JulianRe24/ME3-Entwurf/Unterlagen/Foto Getriebe.PNG

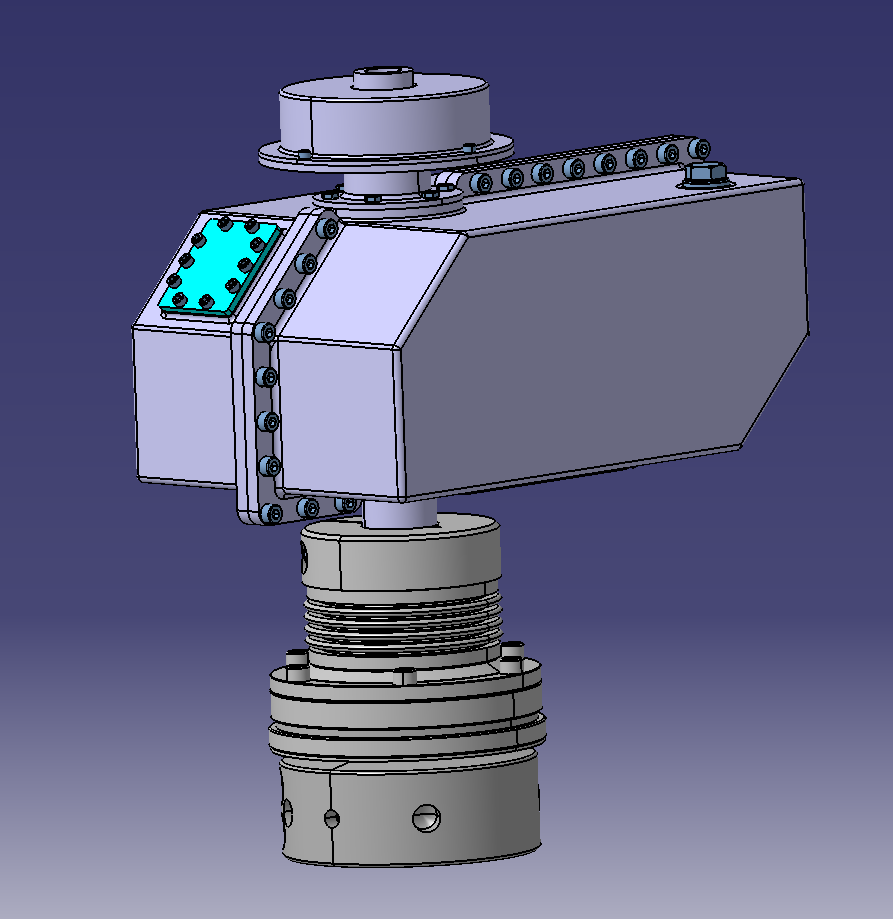
Unterlagen/Foto Getriebe.PNG
