JulianRe24/ME3-Entwurf/README.md

# ME3-Entwurf
Hier wird ein wundervoller Maschinenelemente 3 Entwurf erstellt.
