JulianRe24/ME3-Entwurf/Unterlagen/Bohrgerät-Getriebe_Berechnung final.pdf

Getriebeberechnung Bohrgerät | Lara Vujevic
Julian Reimann
Arne Schlemermeyer

Vereinbarte Konstanten:

Normaleingriffs-winkelwinkel:

Schrägungswinkel: Überschlägiger Belastungswert:

Anwendungsfaktor:

αn ≔20 | ° | β ≔20 ° | Bzul ≔4 | ―N―mm²
KA ≔2.0

Druckkraft
vom Boden:
Schaltdrehzahl: | Dauerfestigkeitsschubspannung:
FB ≔1500 N | ns ≔1400 rpm | τTzul ≔50 ―N―mm²
(42CrMo4)

Antriebsdrehzahl:
nAntrieb ≔2000 ―1―min

Übersetzungsverhältnis:

Antriebsmoment:
Tan ≔50 N ⋅m

Theoretisch benötigte Übersetzungen:
i1 ≔3.40 | i2 ≔2.95 | orientiert an TB 21-11
iGesamt ≔i | ⋅ 1

i2

iGesamt =10.03

Errechnete Übersetzungen (siehe Zahnraddaten):
i'1 ≔3.381 | i'2 ≔2.964
i'Gesamt ≔i' | ⋅ 1

i'2

i'Gesamt =10.021

Moment der Vorgelegewelle:
TVorgelege ≔T | ⋅ an | i'1 | TVorgelege =169.05 N ⋅m

Abtriebsmoment:

Tab ≔T | ⋅ an | i'Gesamt | Tab =501.064 N ⋅m

10.08.2022 Seite 1 von 27

Fliehkraftkupplung:

NFK ≔2 | FF ≔25 N | ns ≔1400 ―1―min
ωs ≔2 π⋅ns =146.608 | ―1
s
rFK ≔50 mm | μ0 ≔0.9
mFK ≔0.5 | kg | Δl ≔2.5 mm

dR ≔120 mm

Federsteifigkeit: | C ≔――

FF
Δl

C =10 ―N―mm

Bei Schaltdrehzahl:

Fliehkraft: | FFlieh ≔mFK ⋅ rFK ⋅ωs
2 | FFlieh =0.537 | kN
Kontaktkraft: | FN ≔⎛⎝FFlieh -2 ⋅FF

⎞
⎠ | FN =0.487 | kN
Reibkraft eines Fliehkörpers: | FR ≔μ | ⋅ 0 | FN | FR =438.611 N
Reib-/Schaltmoment: | TR ≔NFK ⋅FR ⋅―

dR
2

TR =52.633 N·m

10.08.2022 Seite 2 von 27

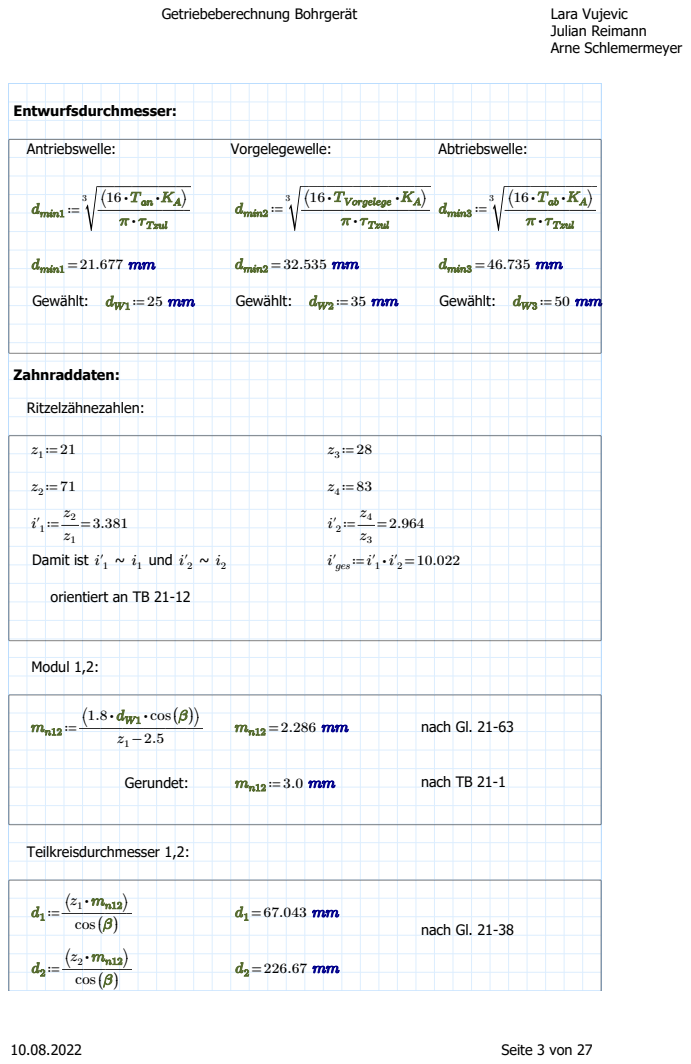
[picture p2: page 3]
Entwurfsdurchmesser:; Antriebswelle:; Vorgelegewelle:; Abtriebswelle:; dmin2 ≔; ⎛⎝16 ⋅TVorgelege ⋅KA; π⋅τTzul; dmin3 ≔; dmin1 ≔; dmin1 =21.677 mm; dmin2 =32.535 mm; dmin3 =46.735 mm; Gewählt:; Zahnraddaten:; Ritzelzähnezahlen:; Damit ist i' ~; und; i'ges≔i'1; Modul 1,2:; ⎛⎝1.8 ⋅dW1 ⋅ cos ((β))⎞ ⎠; nach Gl. 21-63; Gerundet:; nach TB 21-1; Teilkreisdurchmesser 1,2:; cos ((β)); nach Gl. 21-38; 10.08.2022 Seite 3 von 27

orientiert an TB 21-12

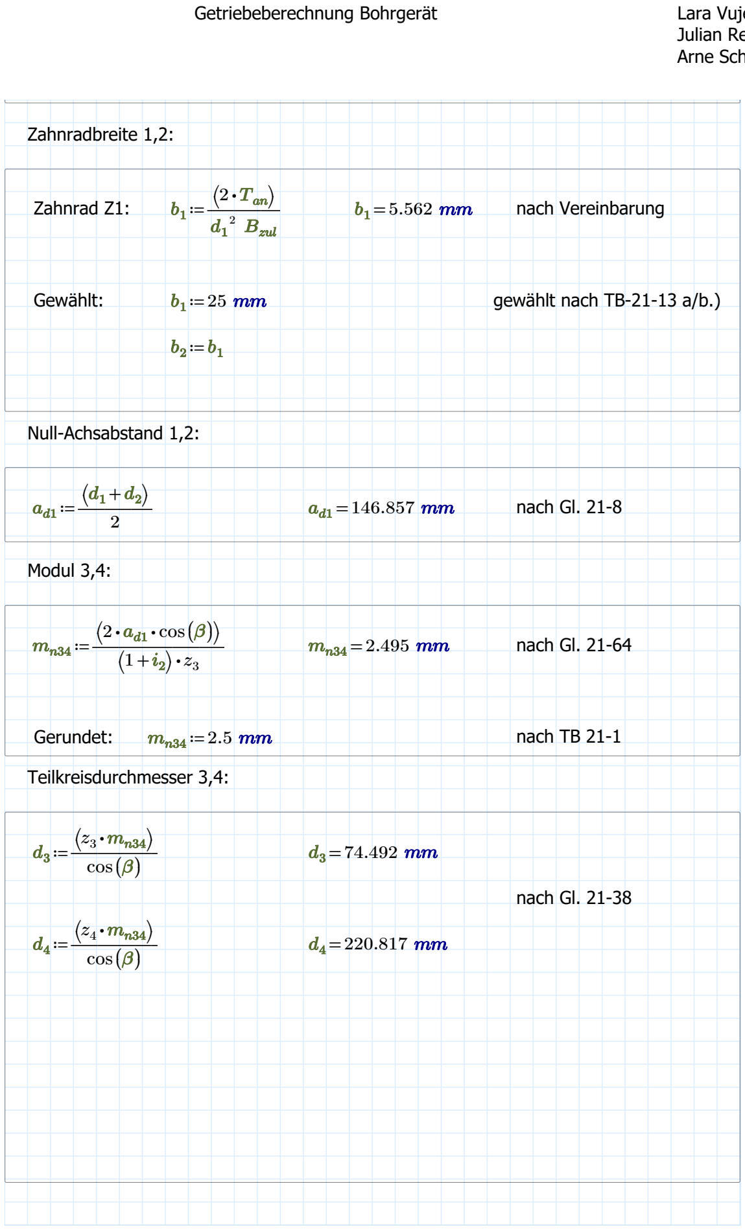
[picture p3: figure]
Zahnradbreite 1,2:; Zahnrad Z1:; ⎛⎝2 ⋅Tan; 2 Bzul; nach Vereinbarung; Gewählt:; gewählt nach TB-21-13 a/b.); Null-Achsabstand 1,2:; nach Gl. 21-8; Modul 3,4:; ⋅ d1 cos ((β))⎞; nach Gl. 21-64; Gerundet:; nach TB 21-1; Teilkreisdurchmesser 3,4:; cos ((β)); nach Gl. 21-38

10.08.2022 Seite 4 von 27

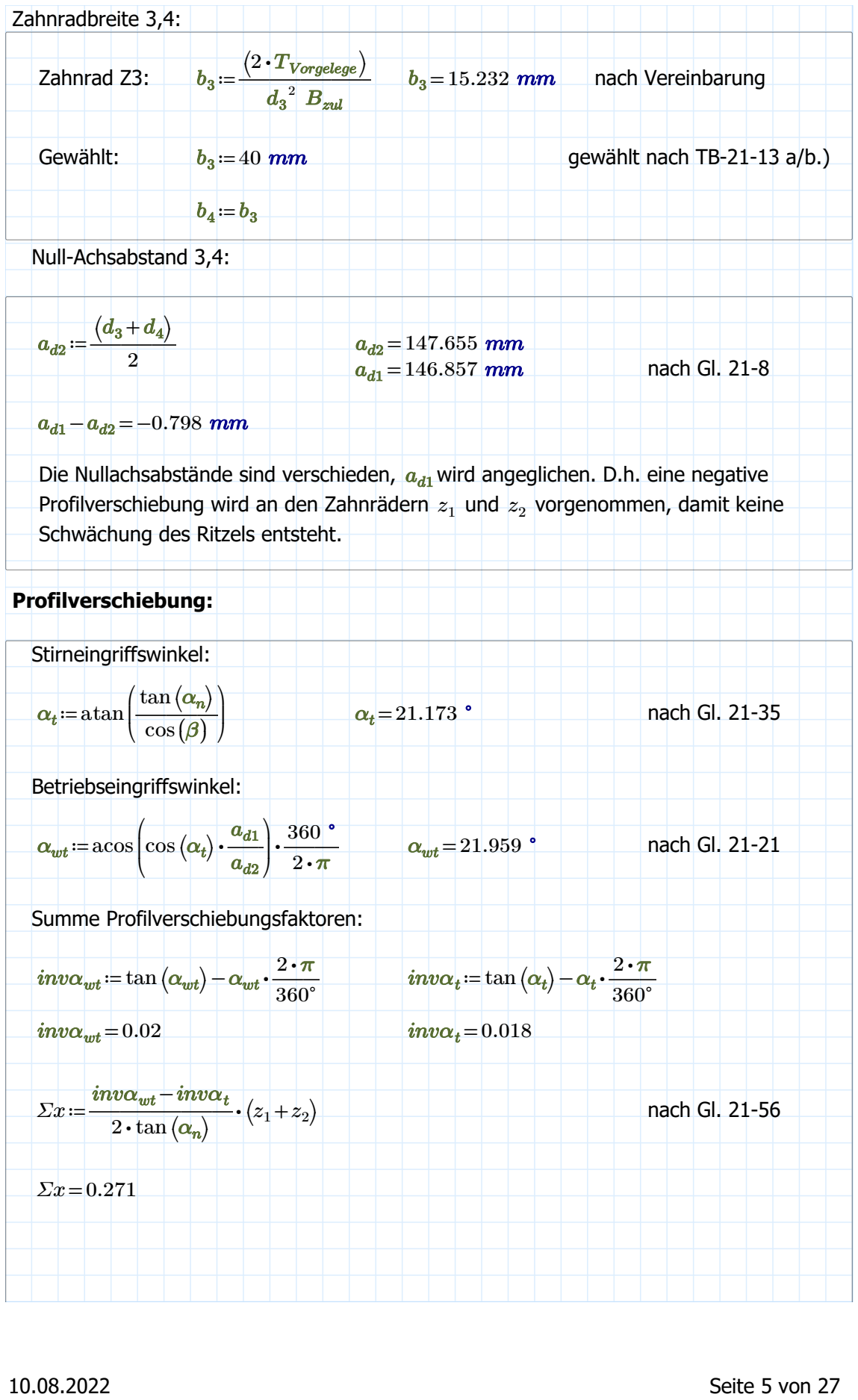
[picture p4: figure]
Zahnradbreite 3,4:; Zahnrad Z3:; ⎛⎝2 ⋅TVorgelege ⎞ ⎠; 2 Bzul; nach Vereinbarung; Gewählt:; gewählt nach TB-21-13 a/b.); Null-Achsabstand 3,4:; nach Gl. 21-8; Profilverschiebung wird an den Zahnrädern; und; vorgenommen, damit keine 1; Schwächung des Ritzels entsteht.; Profilverschiebung:; Stirneingriffswinkel:; αt ≔atan; tan⎛⎝αn; ⎞ ⎠ cos ((β)); nach Gl. 21-35; Betriebseingriffswinkel:; αwt ≔acos; cos ⎛; αwt =21.959 °; nach Gl. 21-21; Summe Profilverschiebungsfaktoren:; invαwt ≔tan⎛⎝αwt⎞; ⎠-αwt ⋅―2 ⋅π―360°; invαt ≔tan⎛⎝αt; invαwt =0.02; invαt =0.018; invαwt -invαt 2 ⋅ tan⎛⎝αn; nach Gl. 21-56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

Die Nullachsabstände sind verschieden, | a | wird angeglichen. D.h. eine negative d1

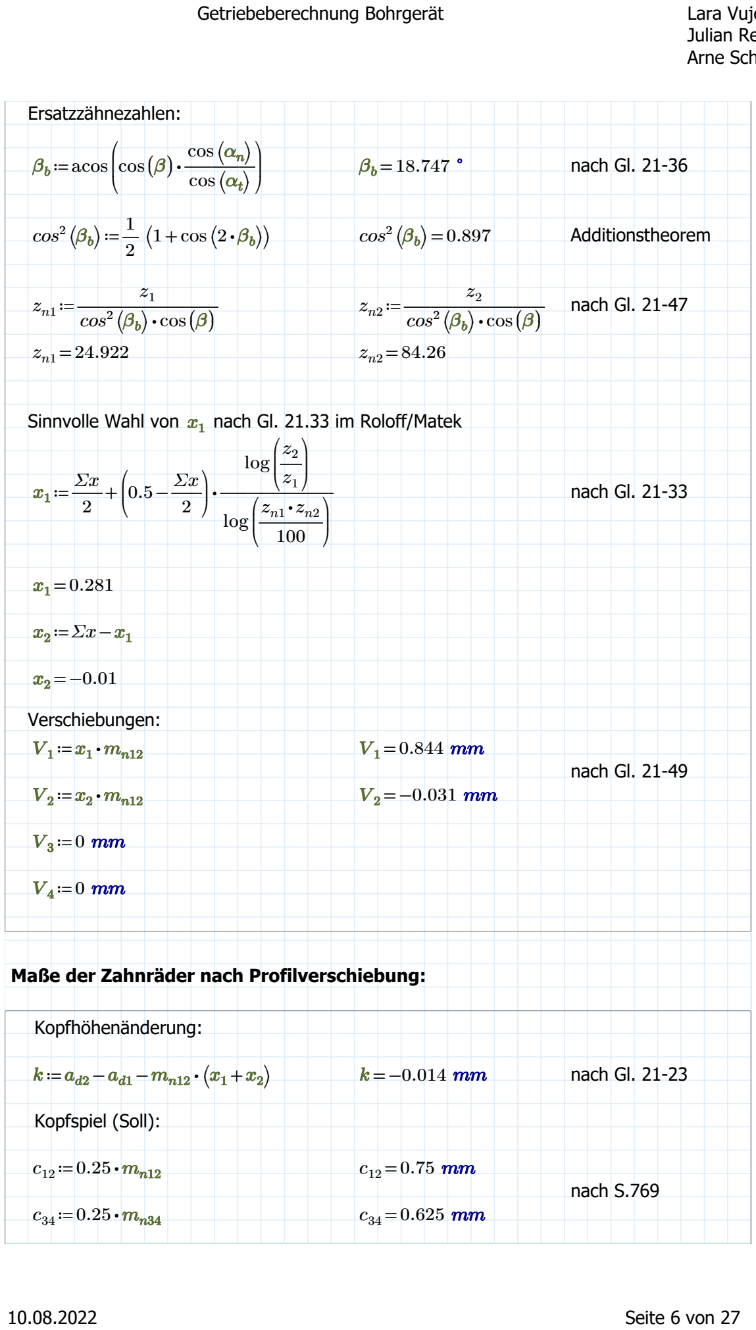
[picture p5: figure]
Ersatzzähnezahlen:; βb ≔acos; cos ((β)) ⋅―――; cos ⎛⎝αn; cos ⎛⎝αt; nach Gl. 21-36; cos² ⎛⎝βb; ⎛⎝1+cos ⎛⎝2 ⋅βb; Additionstheorem; cos² ⎛; ⎠ cos ((β)); nach Gl. 21-47; log; nach Gl. 21-33; Verschiebungen:; nach Gl. 21-49; Kopfhöhenänderung:; nach Gl. 21-23; Kopfspiel (Soll):; nach S.769; 10.08.2022 Seite 6 von 27

Sinnvolle Wahl von x1 nach Gl. 21.33 im Roloff/Matek

Maße der Zahnräder nach Profilverschiebung:

Kopfkreisdurchmesser nach Profilverschiebung:

da1 ≔d1 +2 ⋅mn12 +2 ⋅V1 +2 ⋅k | da1 =74.702 mm | nach Gl. 21-24
da2 ≔d2 +2 ⋅mn12 +2 ⋅V2 +2 ⋅k | da2 =232.578 | mm
da3 ≔d3 +2 ⋅mn34 | da3 =79.492 mm | nach Gl. 21-40
da4 ≔d4 +2 ⋅mn34 | da4 =225.817 | mm

Fußkreisdurchmesser nach Profilverschiebung:

df1 ≔d1 -2 ⋅ ⎛⎝

⎛⎝mn12 +c12⎞
⎠-V1

⎞
⎠ | df1 =61.231 mm | nach Gl. 21-25

df2 ≔d2 -2 ⋅ ⎛⎝

⎛⎝mn12 +c12⎞
⎠-V2

⎞
⎠ | df2 =219.107 | mm
df3 ≔d3 -2.5 ⋅mn34 | df3 =68.242 mm | nach Gl. 21-41
df4 ≔d4 -2.5 ⋅mn34 | df4 =214.567 | mm

Kopfspiel nach Profilverschiebung:

c≔ad2 -0.5 ⋅ ⎛⎝da1 +df2⎞
⎠ | c=0.75 | mm | nach Gl. 21-22c

Prüfen der Zahndicke am Kopfkreis:

tangentiales Modul: | mt12 ≔―――

mn12
cos ((β))
min. Kopfdicke des Zahnes: | sa12min ≔0.2 ⋅mn12 | nach S.791

sa12min =0.6 mm

Stirnteilung: | pt12 ≔m | ⋅ t12 | π | nach Gl. 21-34
Stirnzahndicke: | st1 ≔――+

pt12
2

2 ⋅V ⋅ 1 tan⎛⎝αt

⎞
⎠ | nach Gl. 21-51
" s | " ist in Bezug auf den tangentialen Stirnschnitt (S-S) durch das Zahnrad. t1
(S.802 - Bild 21-14)
" sa1 " ist auf den Kopfkreis bezogen

10.08.2022 Seite 7 von 27

nach S.806
"α " entspricht at1
"αyt1 " aus Roloff Matek

Profilwinkel am Kopfkreis: αat1 ≔acos

⎛
⎜
⎝

――――

d ⋅ 1 cos ⎛⎝αt

⎞
⎠
da1

⎞
⎟
⎠

invαat1 ≔tan⎛⎝αat1⎞

⎠-αat1 ⋅―― | aus Vorlesung 2 ⋅π
360 °

Kopfdicke des Zahnes an den gewählten Zahnrädern (nach Profilverschiebung):

sa1 ≔d ⋅ a1

⎛
⎜
⎝
| | ―+ | | | -
| | st1 d1
invαt
| | | invαat1 | | | ⎞ ⎟ ⎠
sa1 =2.055 | mm | nach Gl. 21-53
Stirnzahndicke: | st2 ≔――+
| | | | | | pt12
| | | | | | 2
2 ⋅V | ⋅ 2 tan⎛⎝αt

⎞
⎠

Profilwinkel am Kopfkreis: αat2 ≔acos

⎛
⎜
⎝

――――

d ⋅ 2 cos ⎛⎝αt

⎞
⎠
da2

⎞
⎟
⎠

invαat2 ≔tan⎛⎝αat2⎞

⎠-α ⋅ at2 ―2 ⋅―π
360 °
Kopfdicke des Zahnes an den gewählten Zahnrädern (nach Profilverschiebung):

sa2 ≔d ⋅ a2

⎛
⎜
⎝
| | ―+ | | | -
| | st2 d2
invαt
| | | invαat2 | | | ⎞ ⎟ ⎠
sa2 =2.583 | mm
Sowohl | s | als auch | sind > | . Die Zahndicke am Kopfkreis ist damit a1 | sa2 | sa12min
ausreichend. Zusätzliche Prüfung über TB 21-8 R/M führt zum gleichen Ergebnis.

Grundkreisdurchmesser db:
(Der Durchmesser welcher von der Normalen N-N, die durch den Berührpunkt der Zahnflanken geht, tangiert wird - Bild 21.3)
db1 ≔d | ⋅ 1 | cos ⎛⎝αt
| | ⎞
⎠ | db1 =62.517 mm
db2 ≔d | ⋅ 2 | cos ⎛⎝αt
| | ⎞
⎠ | db2 =211.369 | mm
nach Gl. 21-2
db3 ≔d | ⋅ 3 | cos ⎛⎝αt
| | ⎞
⎠ | db3 =69.464 mm
db4 ≔d | ⋅ 4 | cos ⎛⎝αt
| | ⎞
⎠ | db4 =205.911 | mm

Profilüberdeckung:

Profilüberdeckung des ersten Zahnradpaares:

nach Gl. 21-57
εα12≔――――――――――――――――――

⎛
⎜
⎝
0.5 ⋅ | -
| | ⎛ ⎜ ⎝ d a1
- +

### 2 db1

2 ――⋅

z2
|z2
- da2

### 2 db2

2

⎞
⎟
⎠
a | ⋅ d2 | sin⎛⎝αwt⎞
⎠

⎞
⎟
⎠
π⋅m ⋅ t12 cos ⎛⎝αt

⎞
⎠

10.08.2022 Seite 8 von 27

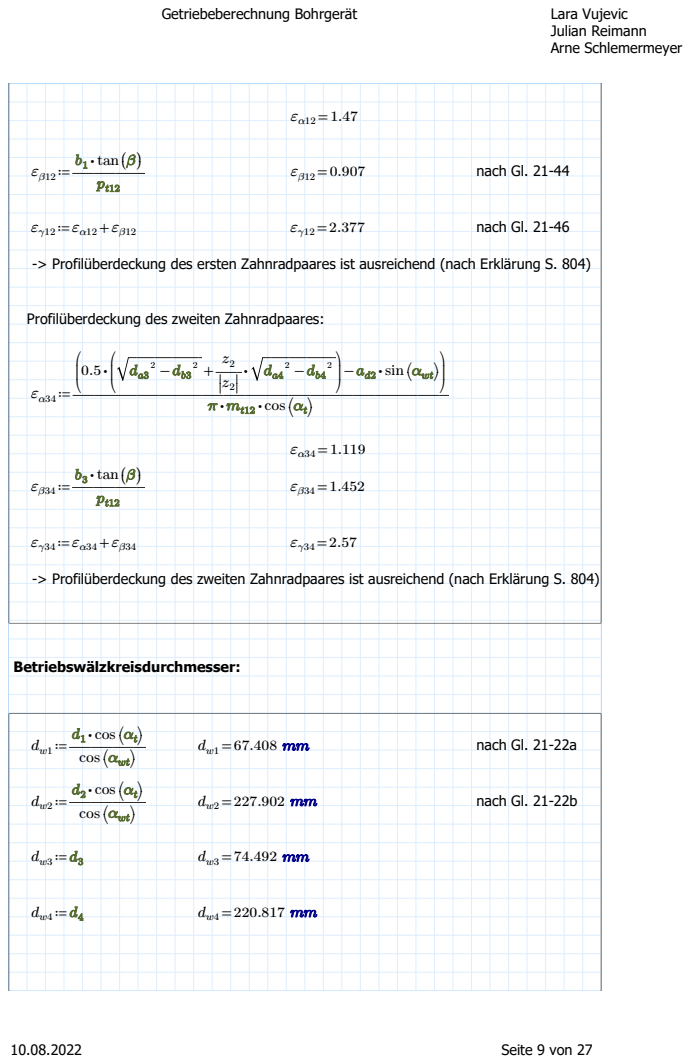
[picture p6: page 9]
nach Gl. 21-44; ⋅ 1 tan((β)); nach Gl. 21-46; sin⎛⎝αwt⎞; ⋅ t12 cos ⎛⎝αt; ⋅ 3 tan((β)); Betriebswälzkreisdurchmesser:; ⋅ 1 cos ⎛⎝αt; cos ⎛⎝αwt⎞ ⎠; nach Gl. 21-22a; ⋅ 2 cos ⎛⎝αt; nach Gl. 21-22b; 10.08.2022 Seite 9 von 27

-> Profilüberdeckung des ersten Zahnradpaares ist ausreichend (nach Erklärung S. 804)

Profilüberdeckung des zweiten Zahnradpaares:

-> Profilüberdeckung des zweiten Zahnradpaares ist ausreichend (nach Erklärung S. 804)

Kontrolle Achsabstand:

a≔―――=

dw1+dw2
2

147.655 mm
identisch mit:
ad2 =147.655 mm

a≔―――=

dw3+dw4
2

147.655 mm

Zusammenfassung:

d1 =67.043 mm | db1 =62.517 mm | da1 =74.702 mm | df1 =61.231 mm
d2 =226.67 mm | db2 =211.369 | mm | da2 =232.578 | mm | df2 =219.107 | mm
d3 =74.492 mm | db3 =69.464 mm | da3 =79.492 mm | df3 =68.242 mm
d4 =220.817 mm | db4 =205.911 | mm | da4 =225.817 | mm | df4 =214.567 | mm
b1 =25 mm | dw1=67.408 mm | z1=21 | mn12 =3 mm
b2 =25 mm | dw2=227.902 | mm | z2=71
b3 =40 mm | dw3=74.492 mm | z3=28 | mn34 =2.5 | mm
b4 =40 mm | dw4=220.817 | mm | z4=83
V1 =0.844 | mm | εα12=1.47 | εα34=1.119 | x1 =0.281
V2 =-0.031 mm | εβ12=0.907 | εβ34=1.452 | x2 =-0.01
V3 =0 mm | | εγ12=2.377 | εγ34=2.57

V4 =0 mm

10.08.2022 Seite 10 von 27

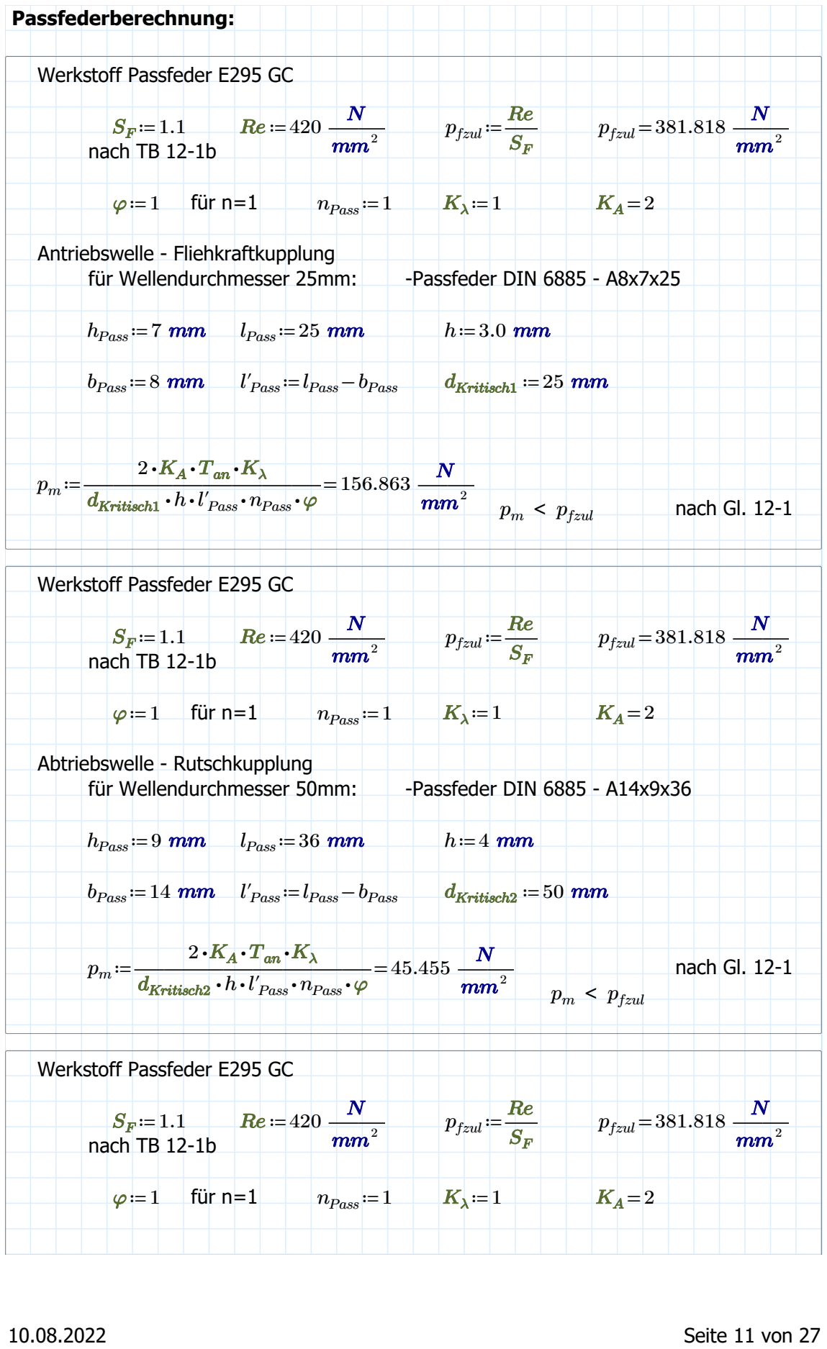
[picture p7: figure]
Passfederberechnung:; Werkstoff Passfeder E295 GC; Re ≔420 ―N―mm²; pfzul≔―Re―SF; pfzul=381.818 ―N―mm²; nach TB 12-1b; für n=1; nPass≔1; Antriebswelle - Fliehkraftkupplung; für Wellendurchmesser 25mm:; -Passfeder DIN 6885 - A8x7x25; hPass≔7 mm; lPass≔25 mm; bPass≔8; l'Pass≔lPass-bPass; dKritisch1 ≔25; dKritisch1; ⋅h⋅l'Pass ⋅nPass ⋅φ; 156.863 ―N―mm²; pm < pfzul; nach Gl. 12-1; Abtriebswelle - Rutschkupplung; für Wellendurchmesser 50mm:; -Passfeder DIN 6885 - A14x9x36; hPass≔9 mm; lPass≔36 mm; bPass≔14 mm; dKritisch2 ≔50; dKritisch2; 45.455 ―N―mm²; 10.08.2022 Seite 11 von 27

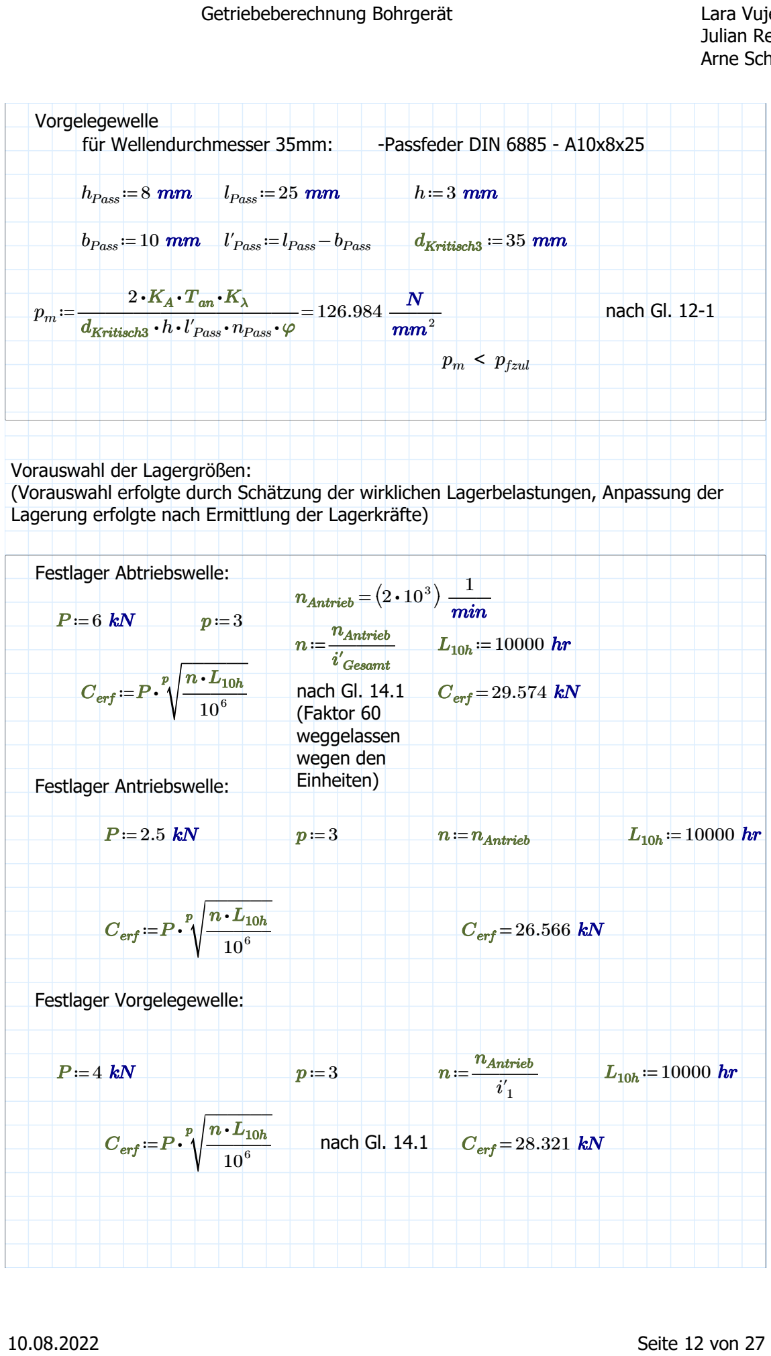
[picture p8: figure]
Vorgelegewelle; für Wellendurchmesser 35mm:; -Passfeder DIN 6885 - A10x8x25; hPass≔8 mm; lPass≔25 mm; bPass≔10 mm; l'Pass≔lPass-bPass; dKritisch3 ≔35; dKritisch3; ⋅h⋅l'Pass ⋅nPass ⋅φ; 126.984 ―N―mm²; nach Gl. 12-1; pm < pfzul; Vorauswahl der Lagergrößen:; Festlager Abtriebswelle:; nAntrieb =⎛⎝2 ⋅ 10³ ⎞; ⎠ ―1―min P ≔6 kN; nAntrieb; i'Gesamt; nach Gl. 14.1 (Faktor 60 weggelassen wegen den Einheiten); Cerf ≔P ⋅; Cerf =29.574; Festlager Antriebswelle:; n ≔nAntrieb; Cerf =26.566; Festlager Vorgelegewelle:; nAntrieb i'1; nach Gl. 14.1; Cerf =28.321; 10.08.2022 Seite 12 von 27

(Vorauswahl erfolgte durch Schätzung der wirklichen Lagerbelastungen, Anpassung der Lagerung erfolgte nach Ermittlung der Lagerkräfte)

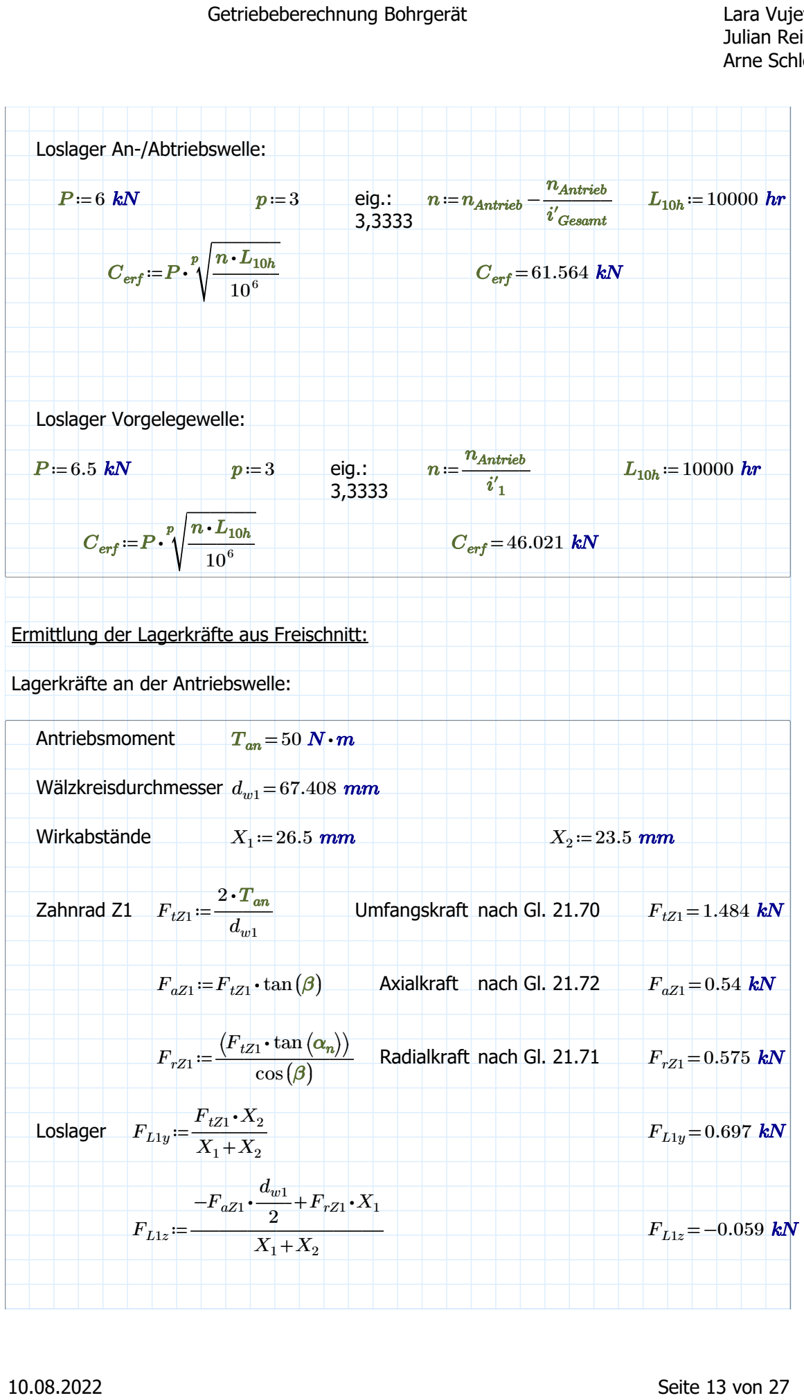
[picture p9: figure]
Loslager An-/Abtriebswelle:; eig.:; n ≔nAntrieb -―――; nAntrieb; i'Gesamt; Cerf ≔P ⋅; Cerf =61.564; Loslager Vorgelegewelle:; nAntrieb i'1; Cerf =46.021; Ermittlung der Lagerkräfte aus Freischnitt:; Lagerkräfte an der Antriebswelle:; Antriebsmoment; Tan =50 N ⋅m; Wälzkreisdurchmesser; Wirkabstände; FtZ1≔―――; 2 ⋅Tan; Zahnrad Z1; Umfangskraft; nach Gl. 21.70; FtZ1=1.484 kN; FaZ1≔F; ⋅ tZ1 tan((β)); Axialkraft; nach Gl. 21.72; FaZ1=0.54; FrZ1≔―――――; ⋅ tZ1 tan⎛⎝αn; cos ((β)); Radialkraft; nach Gl. 21.71; FrZ1=0.575 kN; Loslager; -FaZ1 ⋅――+; 10.08.2022 Seite 13 von 27

Festlager | FF1x≔FaZ1 | FF1x=0.54 | kN
FF1y≔FtZ1-FL1y | FF1y=0.786 kN
FF1z≔FrZ1-FL1z | FF1z=0.634 kN

Lagerkräfte an der Vorgelegewelle:

Moment an der Vorgelegewelle: | TVorgelege =169.05 N ⋅m
Wälzkreisdurchmesser | dw2=227.902 | mm | dw3=74.492 mm
Wirkabstände | X3≔26 | mm | X4≔21 | mm | X5≔36.5 mm
Zahnrad Z2 | FaZ2≔-FaZ1 | FtZ2≔-FtZ1 | FrZ2≔-FrZ1

Zahnrad Z3
FtZ3≔――――

2 ⋅TVorgelege
| | dw3 | | | FtZ3=4.539 kN
FaZ3≔F | ⋅ tZ3 | tan((β)) | FaZ3=1.652 kN

FrZ3≔―――――

F ⋅ tZ3 tan⎛⎝αn

⎞
⎠
| | cos ((β)) | | | FrZ3=1.758 kN
Loslager | FL2y≔-――――――――
FtZ2 ⋅X3+F | ⋅ tZ3 ⎛⎝X3+X4

⎞
⎠
X3+X4+X5 | FL2y=-2.093 | kN

FL2z≔――――――――――――――――

-FrZ2 ⋅X3+FaZ2 ⋅――+ | +

dw2
2
F | ⋅ rZ3 | ⎛⎝X3+X4

⎞
⎠ | F | ⋅ aZ3 | ――

dw3
2
X3+X4+X5

FL2z=1.168 kN

Festlager | FF2x≔FaZ3+FaZ2 | FF2x=1.112 kN
FF2y≔-FtZ2-FtZ3-FL2y | FF2y=-0.962 | kN
FF2z≔FrZ2-FrZ3+FL2z | FF2z=-1.164 | kN

10.08.2022 Seite 14 von 27

Die Lagerkräfte | , | und | wurden im Freischnitt falsch
herum orientiert angenommen, daraus resultiert ihr negativer Wert. Für die weitere Berechnung wird die Orientierung der Kraftvektoren positiv angenommen daher folgt:
FL2y | FF2y | FF2z

FL2y≔2.093 kN
FF2y≔0.962 kN
FF2z≔1.164 kN

Lagerkräfte an der Abtriebswelle:

Bodenkraft | FB≔1.5 kN
Abtriebsmoment | Tab =501.064 N ⋅m
Wälzkreisdurchmesser | dw4=220.817 | mm
Wirkabstände | X6≔27.5 mm | X7≔41 | mm
Zahnrad Z4 | FaZ4≔-FaZ3 | FtZ4≔-FtZ3 | FrZ4≔-FrZ3

FtZ4≔――

2 ⋅Tab

dw4

FtZ4=4.538 kN

FaZ4≔F | ⋅ tZ3 | tan((β)) | FaZ4=1.652 kN

FrZ4≔―――――

F ⋅ tZ4 tan⎛⎝αn

⎞
⎠
cos ((β))

FrZ4=1.758 kN

Loslager | FL3y≔――――
-F | ⋅ tZ4 | X7
X6+X7

FL3y=-2.716 kN

FL3z≔―――――――

-FrZ4 ⋅X7-F ⋅ aZ4 ――

dw4
2
X6+X7
FL3z=-3.715 | kN
Festlager | FF3x≔-FaZ4+FB | FF3x=-0.152 | kN
| FF3y≔-FtZ4-FL3y | FF3y=-1.822 | kN
FF3z≔-FrZ4-FL3z | FF3z=1.957 kN

10.08.2022 Seite 15 von 27

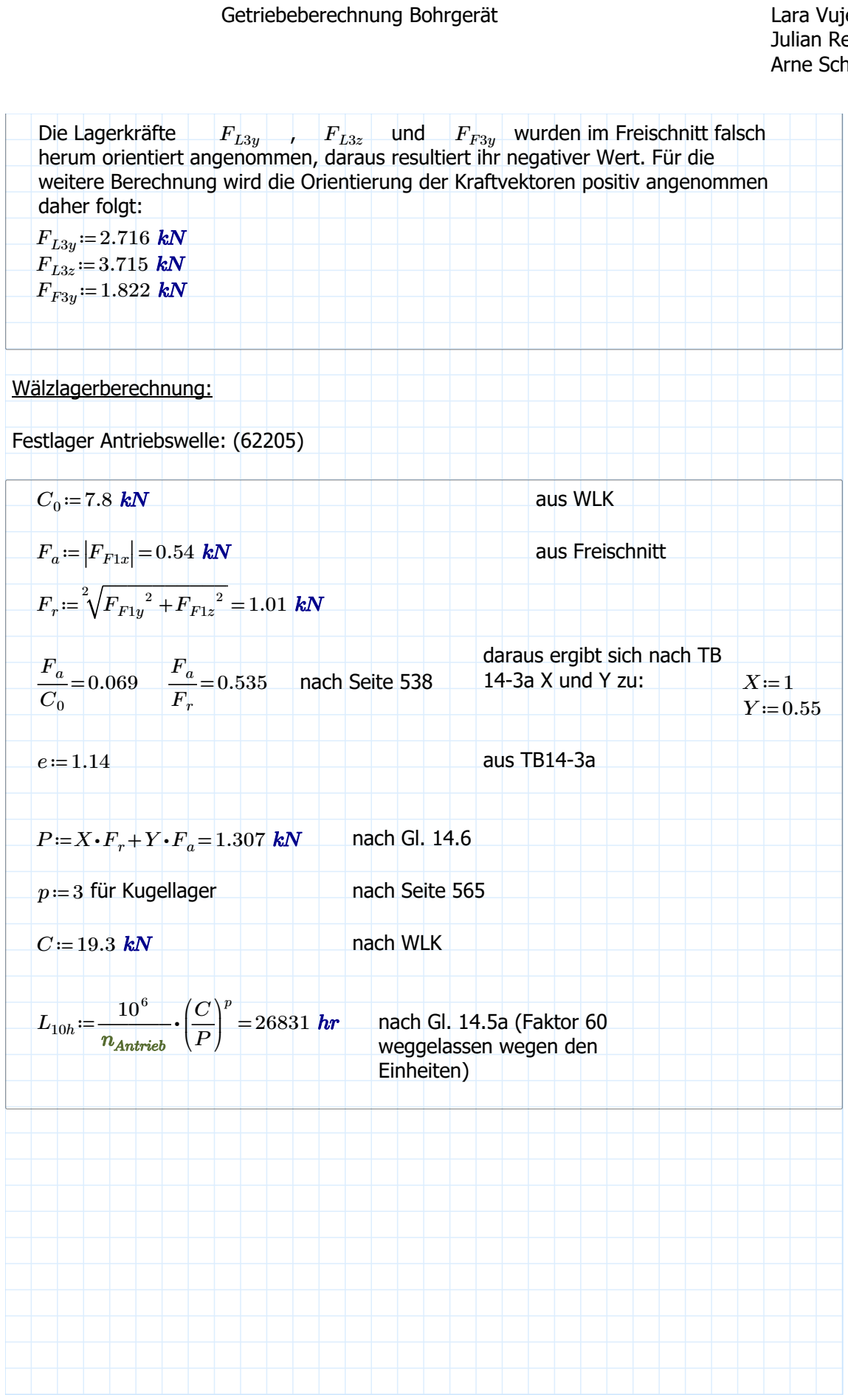
[picture p10: figure]
Die Lagerkräfte; und; wurden im Freischnitt falsch; daher folgt:; Wälzlagerberechnung:; Festlager Antriebswelle: (62205); aus WLK; aus Freischnitt; aus TB14-3a; nach Gl. 14.6; p≔3 für Kugellager; nach Seite 565; nach WLK; nach Gl. 14.5a (Faktor 60 weggelassen wegen den Einheiten); nAntrieb

herum orientiert angenommen, daraus resultiert ihr negativer Wert. Für die weitere Berechnung wird die Orientierung der Kraftvektoren positiv angenommen

daraus ergibt sich nach TB ―= | nach Seite 538 | 14-3a X und Y zu: | X≔1

10.08.2022 Seite 16 von 27

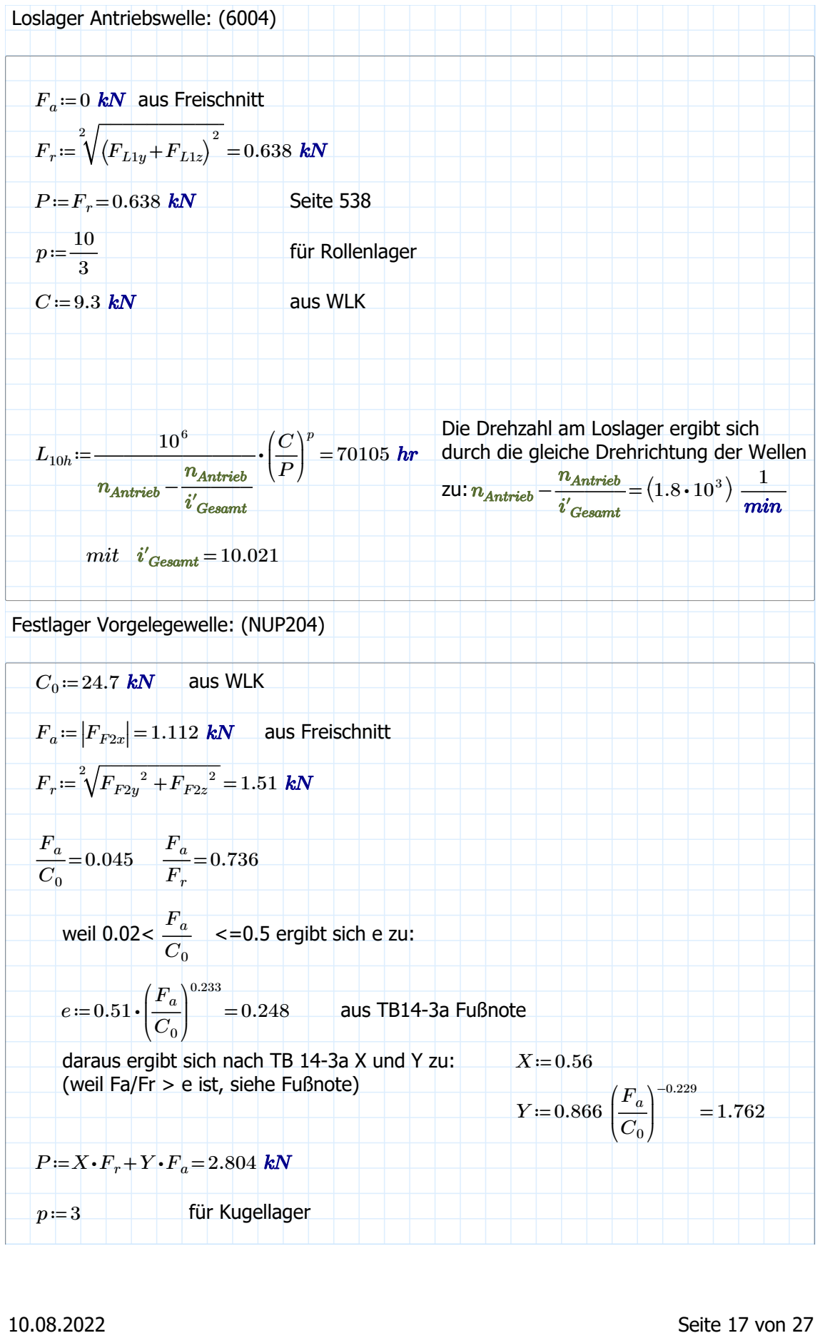
[picture p11: figure]
Loslager Antriebswelle: (6004); aus Freischnitt; Seite 538; für Rollenlager; aus WLK; Die Drehzahl am Loslager ergibt sich; zu:nAntrieb -―――=; nAntrieb; i'Gesamt; ―1―min; nAntrieb -―――; mit; i'Gesamt =10.021; Festlager Vorgelegewelle: (NUP204); aus Freischnitt a; weil 0.02<; <=0.5 ergibt sich e zu:; 0.248 aus TB14-3a Fußnote; (weil Fa/Fr > e ist, siehe Fußnote); für Kugellager; 10.08.2022 Seite 17 von 27

durch die gleiche Drehrichtung der Wellen

daraus ergibt sich nach TB 14-3a X und Y zu:

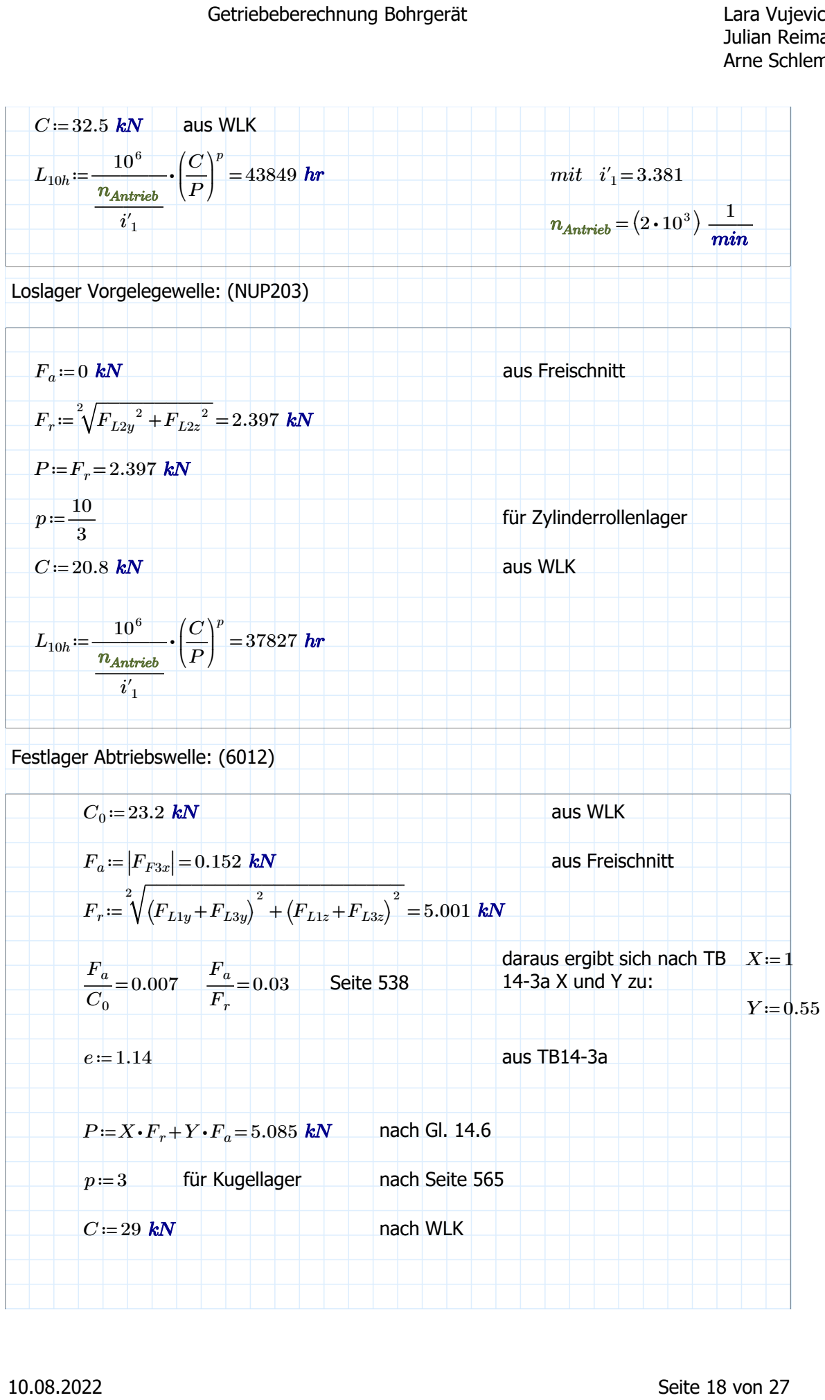
[picture p12: figure]
aus WLK; nAntrieb i'1; mit; nAntrieb =⎛⎝2 ⋅ 10³ ⎞; ⎠ ―1―min; Loslager Vorgelegewelle: (NUP203); aus Freischnitt; für Zylinderrollenlager 10; Festlager Abtriebswelle: (6012); daraus ergibt sich nach TB 14-3a X und Y zu:; Seite 538; aus TB14-3a; nach Gl. 14.6; für Kugellager; nach Seite 565; nach WLK; 10.08.2022 Seite 18 von 27

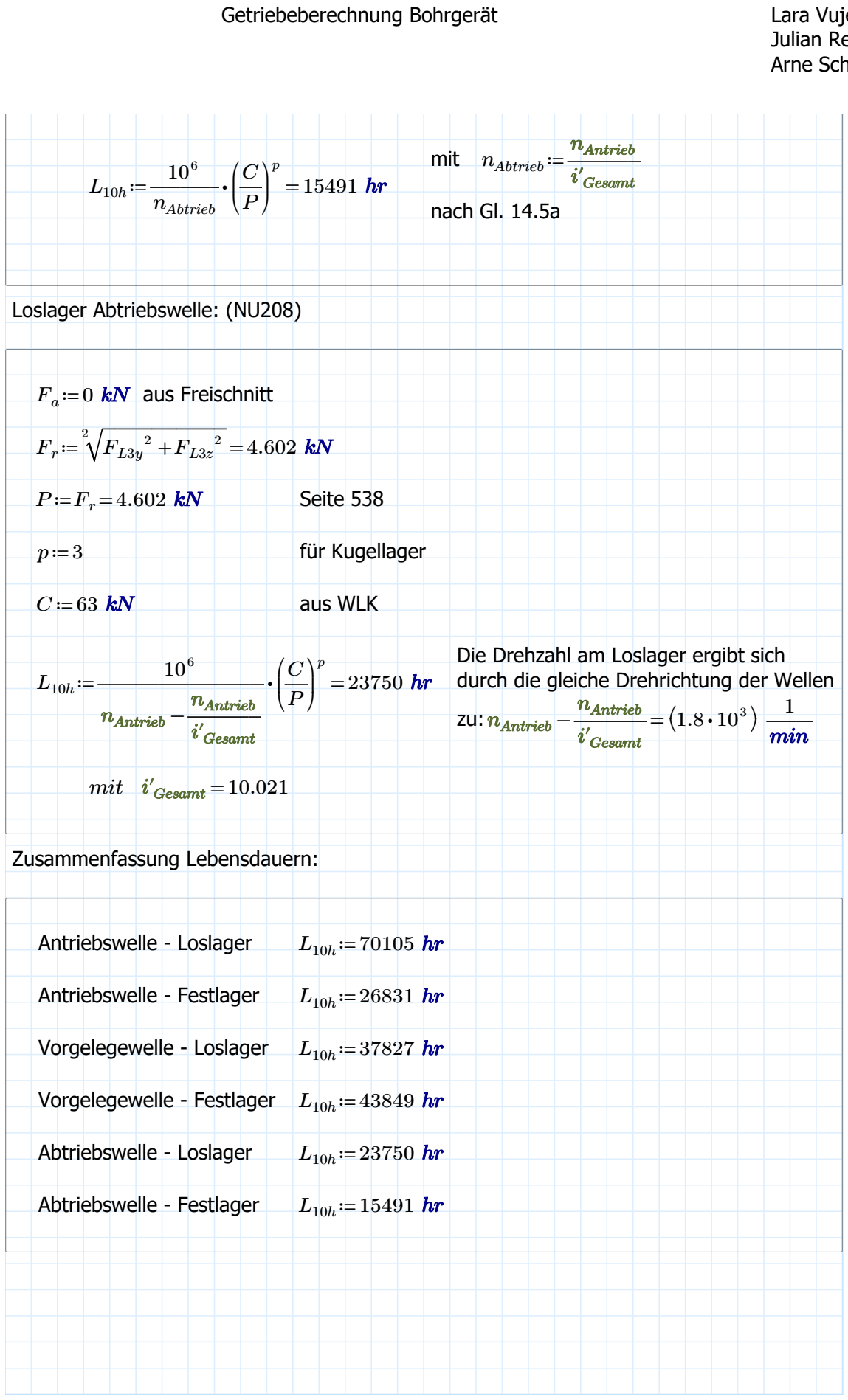
[picture p13: figure]
mit; nAbtrieb≔―――; nAntrieb; i'Gesamt 10h; nAbtrieb; nach Gl. 14.5a; Loslager Abtriebswelle: (NU208); aus Freischnitt; Seite 538; für Kugellager; aus WLK; Die Drehzahl am Loslager ergibt sich; zu:nAntrieb -―――=; i'Gesamt; ―1―min; nAntrieb -―――; i'Gesamt =10.021; Zusammenfassung Lebensdauern:; Antriebswelle - Loslager; Antriebswelle - Festlager; Vorgelegewelle - Loslager; Vorgelegewelle - Festlager; Abtriebswelle - Loslager; Abtriebswelle - Festlager

durch die gleiche Drehrichtung der Wellen

10.08.2022 Seite 19 von 27

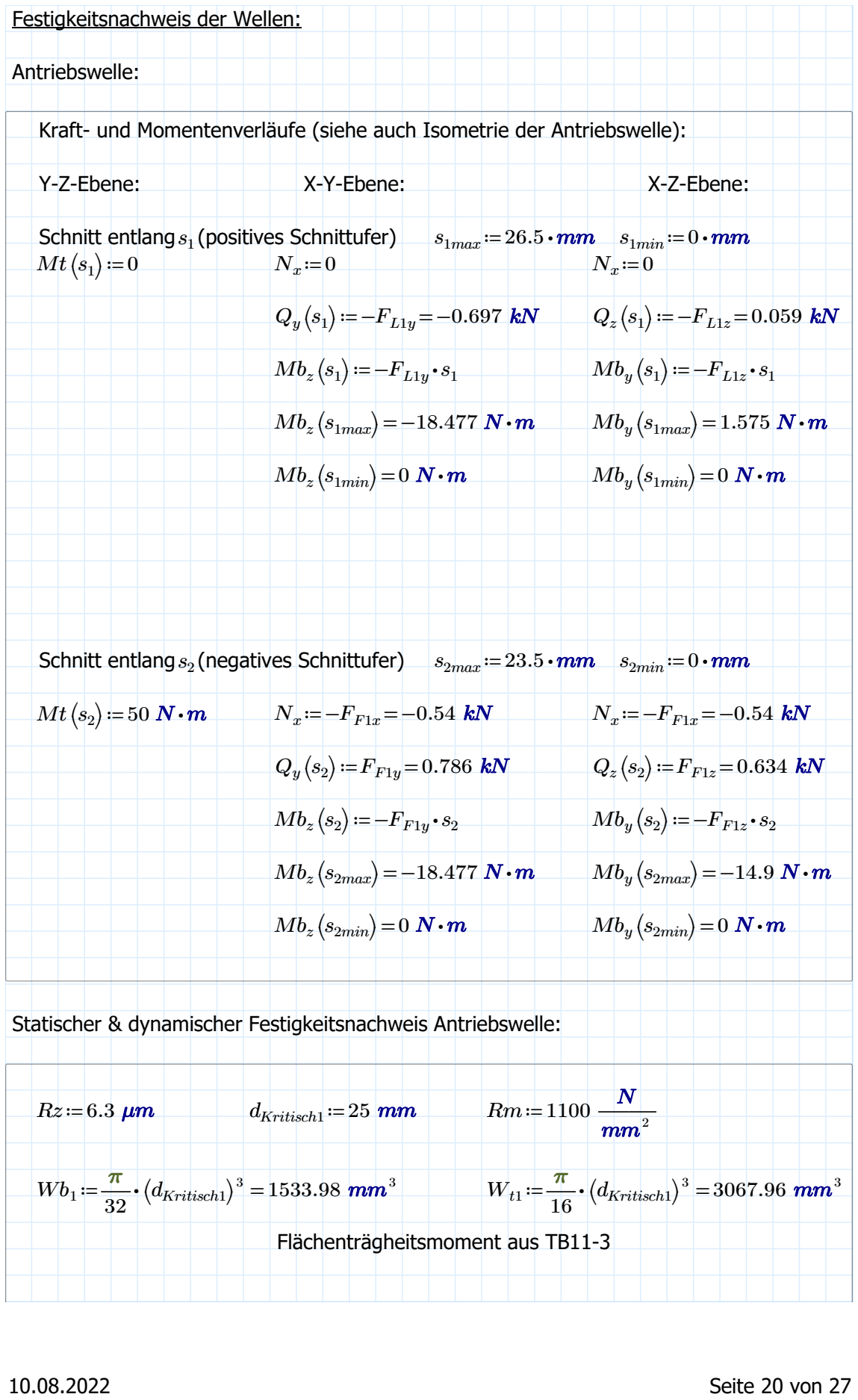
[picture p14: figure]
Festigkeitsnachweis der Wellen:; Antriebswelle:; Y-Z-Ebene:; X-Y-Ebene:; X-Z-Ebene:; Mbz; Mby; ⎛⎝s1max⎞; ⎛⎝s1max⎞ ⎠=1.575 N ⋅m; ⎛⎝s1min⎞; ⎛⎝s1min⎞ ⎠=0 N ⋅m; ⎛⎝s2max⎞; ⎛⎝s2max⎞ ⎠=-14.9 N ⋅m; ⎛⎝s2min⎞; ⎛⎝s2min⎞ ⎠=0 N ⋅m; ⎛⎝dKritisch1⎞ ⎠; mm³; 3 3067.96 mm³; Flächenträgheitsmoment aus TB11-3; 10.08.2022 Seite 20 von 27

Kraft- und Momentenverläufe (siehe auch Isometrie der Antriebswelle):

Schnitt entlangs1 (positives Schnittufer) | s1max≔26.5 ⋅mm | s1min≔0 ⋅mm
Schnitt entlangs2 (negatives Schnittufer) | s2max≔23.5 ⋅mm | s2min≔0 ⋅mm
⎠≔50 N ⋅m | Nx≔-FF1x=-0.54 | kN | Nx≔-FF1x=-0.54 | kN

Statischer & dynamischer Festigkeitsnachweis Antriebswelle:

Rz≔6.3 μm | dKritisch1≔25 | mm | Rm≔1100 ―N―mm²

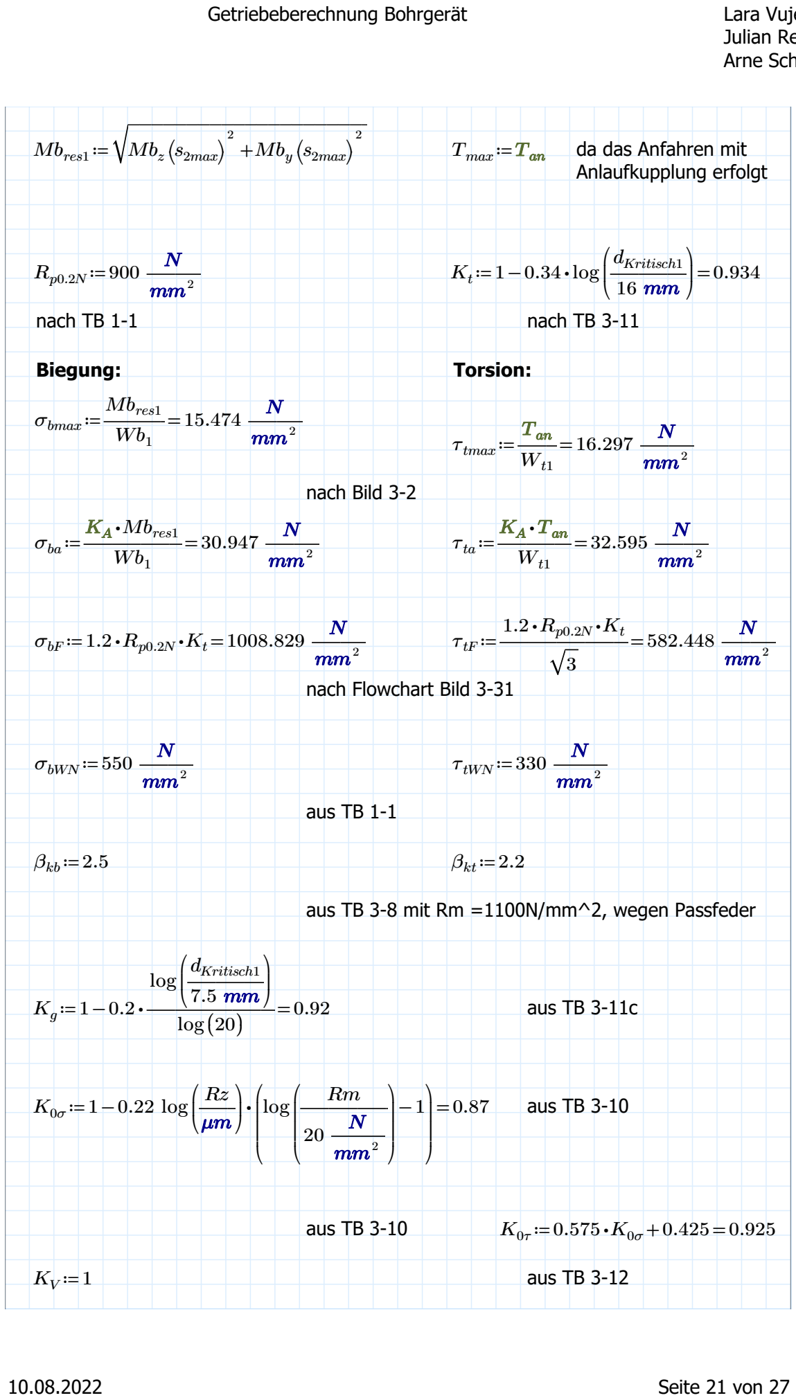
[picture p15: figure]
Mbres1≔; Mbz; ⎛⎝s2max⎞; Mby; ⎛⎝s2max⎞ ⎠; Tmax≔Tan; da das Anfahren mit; Anlaufkupplung erfolgt; Rp0.2N≔900 ―N―mm²; Kt≔1-0.34 ⋅log; dKritisch1 16 mm; nach TB 1-1; nach TB 3-11; Biegung:; Torsion:; σbmax≔―――=; Mbres1 Wb1; 15.474 ―N―mm²; τtmax≔――=; Tan; 16.297 ―N―mm²; nach Bild 3-2; σba≔――――=; KA ⋅Mbres1 Wb1; 30.947 ―N―mm²; τta≔―――=; KA ⋅Tan; 32.595 ―N―mm²; σbF≔1.2 ⋅Rp0.2N ⋅Kt=1008.829 ―N―mm²; τtF≔―――――=; 582.448 ―N―mm²; nach Flowchart Bild 3-31; σbWN≔550 ―N―mm²; τtWN≔330; ―N―mm²; aus TB 1-1; βkb≔2.5; βkt≔2.2; log; dKritisch1 7.5 mm; log((20)); 0.92 aus TB 3-11c; K0σ≔1-0.22 log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

aus TB 3-8 mit Rm =1100N/mm^2, wegen Passfeder

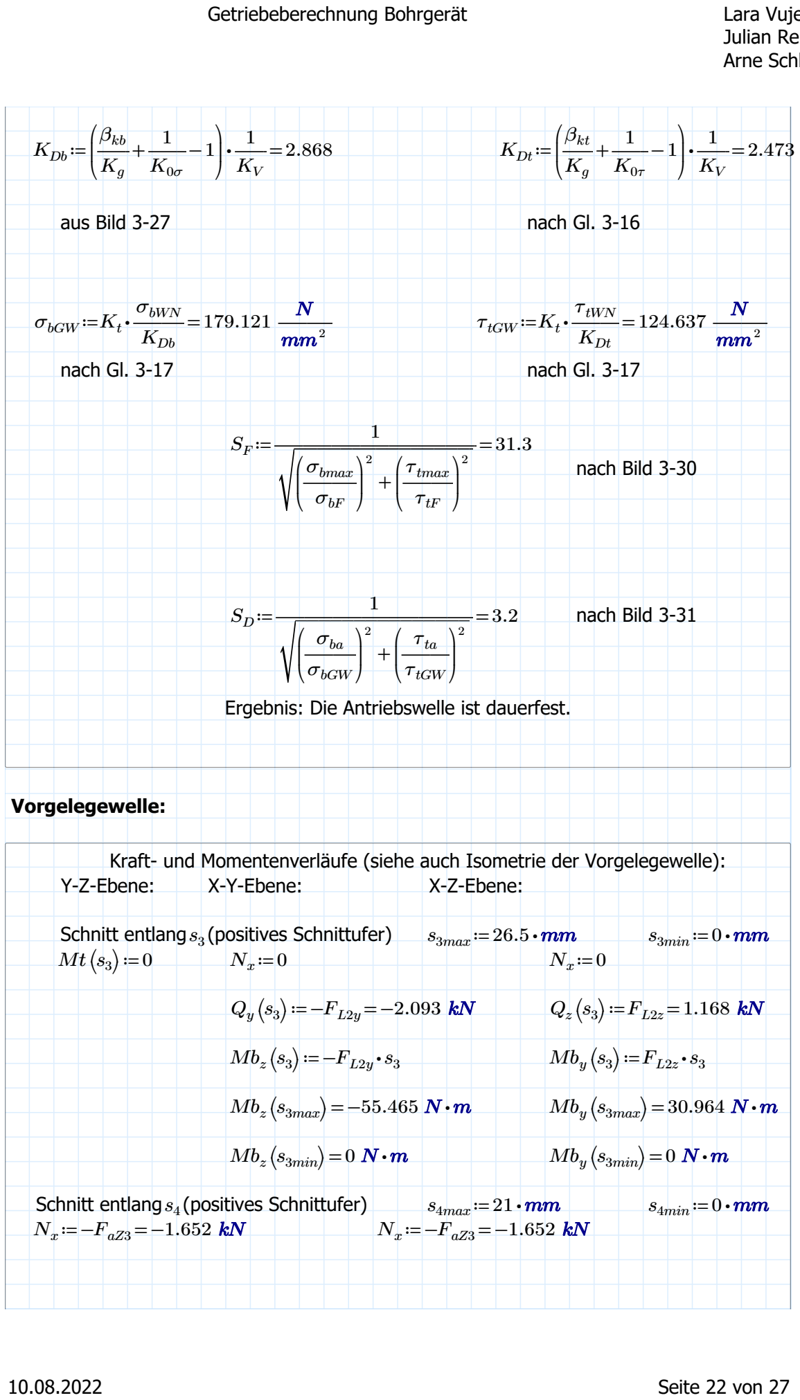
[picture p16: figure]
KDb≔; βkb Kg; KDt≔; βkt Kg; aus Bild 3-27; nach Gl. 3-16; σbGW ≔Kt; σbWN; KDb; 179.121 ―N―mm²; τtGW ≔Kt; τtWN; KDt; 124.637 ―N―mm²; nach Gl. 3-17; σbmax; σbF; τtmax; τtF; nach Bild 3-30; σba; σbGW; τta; τtGW; 3.2 nach Bild 3-31; Ergebnis: Die Antriebswelle ist dauerfest.; Vorgelegewelle:; Y-Z-Ebene:; X-Y-Ebene:; X-Z-Ebene:; Schnitt entlangs; (positives Schnittufer) 3; s3max≔26.5 ⋅mm; s3min≔0 ⋅mm; Mbz; Mby; ⎛⎝s3max⎞; ⎛⎝s3max⎞ ⎠=30.964 N ⋅m; ⎛⎝s3min⎞; ⎛⎝s3min⎞ ⎠=0 N ⋅m; (positives Schnittufer) 4; s4max≔21 ⋅mm; s4min≔0 ⋅mm; Nx≔-FaZ3=-1.652 kN; 10.08.2022 Seite 22 von 27

Kraft- und Momentenverläufe (siehe auch Isometrie der Vorgelegewelle):

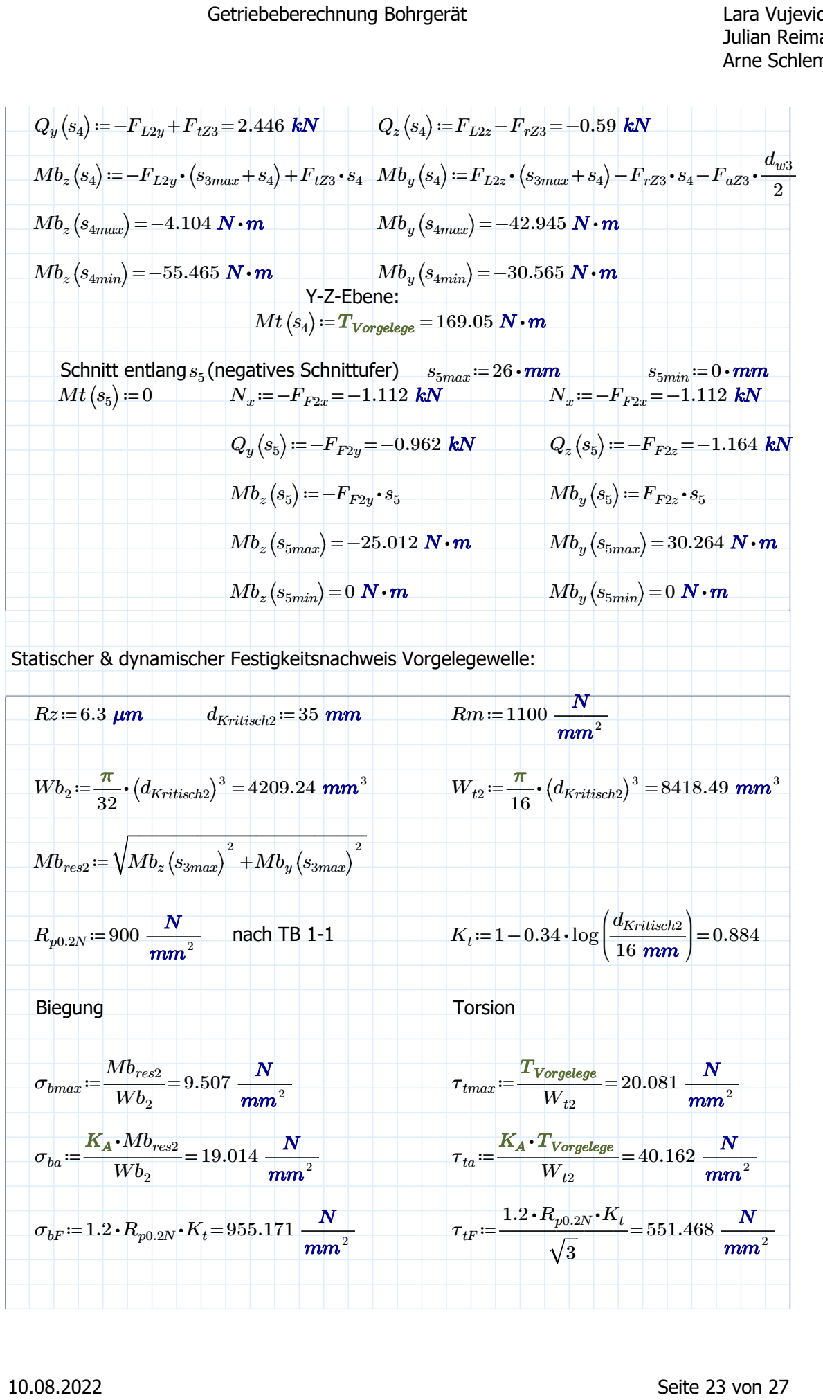
[picture p17: figure]
⎠≔-FL2y+FtZ3=2.446 kN; ⎠≔FL2z-FrZ3=-0.59; Mbz; ⎠≔-FL2y ⋅ ⎛⎝s3max+s4; Mby; ⎠≔FL2z ⋅ ⎛⎝s3max+s4; ⎠-FrZ3 ⋅ s4-F; ⎛⎝s4max⎞; ⎛⎝s4max⎞ ⎠=-42.945 N ⋅m; ⎛⎝s4min⎞; ⎛⎝s4min⎞ ⎠=-30.565 N ⋅m; Y-Z-Ebene: Mt ⎛⎝s4; ⎞ ⎠≔TVorgelege =169.05 N ⋅m; Schnitt entlangs; (negatives Schnittufer) 5; s5max≔26 ⋅mm; s5min≔0 ⋅mm; ⎛⎝s5max⎞; ⎛⎝s5max⎞ ⎠=30.264 N ⋅m; ⎛⎝s5min⎞; ⎛⎝s5min⎞ ⎠=0 N ⋅m; Statischer & dynamischer Festigkeitsnachweis Vorgelegewelle:; dKritisch2≔35; Rm≔1100 ―N―mm²; ⎛⎝dKritisch2⎞ ⎠; mm³; 3 8418.49 mm³; Mbres2≔; ⎛⎝s3max⎞; ⎛⎝s3max⎞ ⎠; Rp0.2N≔900 ―N―mm²; nach TB 1-1; Kt≔1-0.34 ⋅log; dKritisch2 16 mm; Biegung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

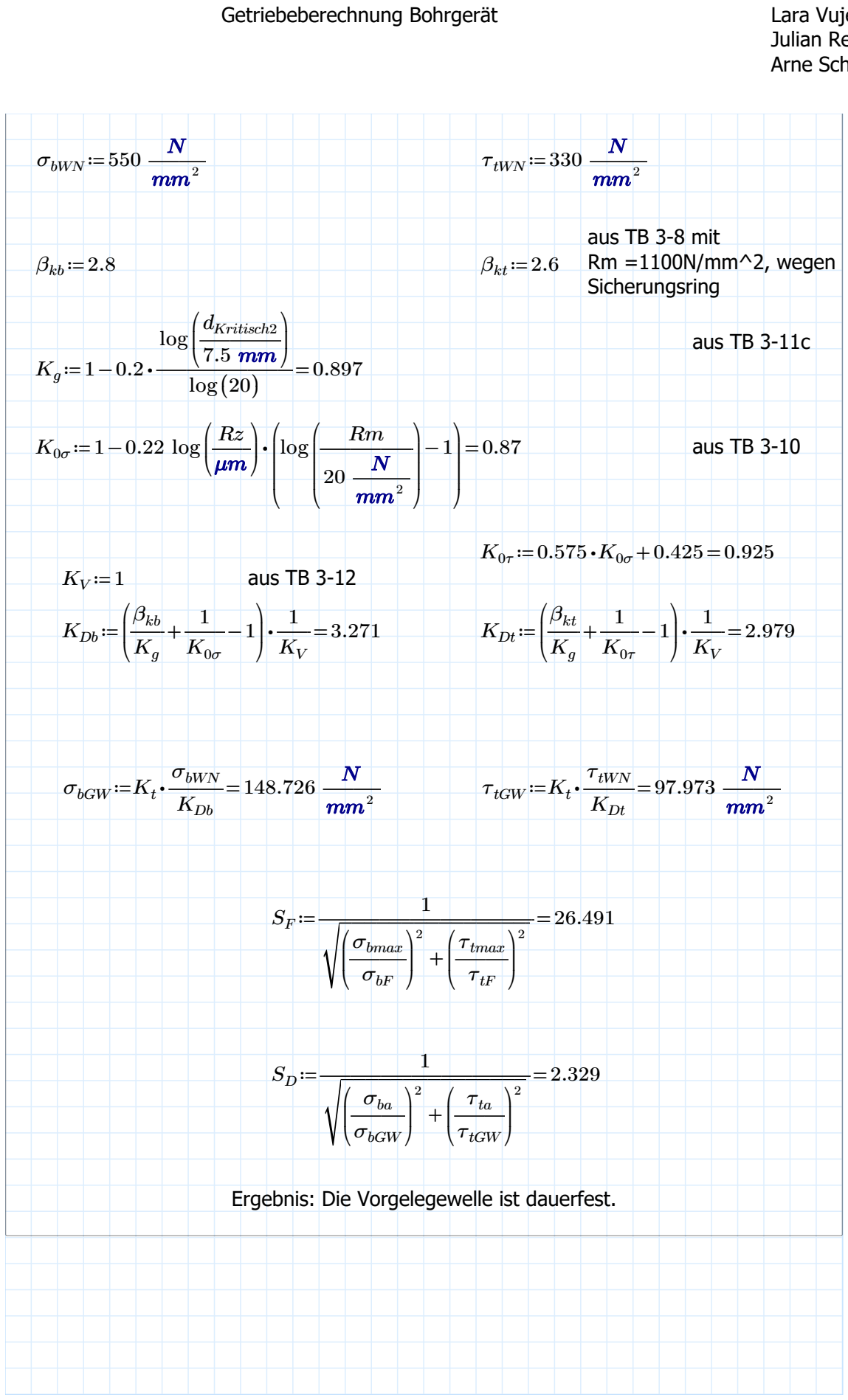
[picture p18: figure]
σbWN≔550 ―N―mm²; τtWN≔330; ―N―mm²; aus TB 3-8 mit Rm =1100N/mm^2, wegen Sicherungsring; βkb≔2.8; βkt≔2.6; aus TB 3-11c; log; dKritisch2 7.5 mm; log((20)); K0σ≔1-0.22 log; ―Rm――― 20 ―N―mm²; 0.87 aus TB 3-10; aus TB 3-12; KDb≔; βkb Kg; KDt≔; βkt Kg; σbGW ≔Kt; σbWN; KDb; 148.726 ―N―mm²; τtGW ≔Kt; τtWN; KDt; 97.973 ―N―mm²; σbmax; σbF; τtmax; τtF; σba; σbGW; τta; τtGW; Ergebnis: Die Vorgelegewelle ist dauerfest.

10.08.2022 Seite 24 von 27

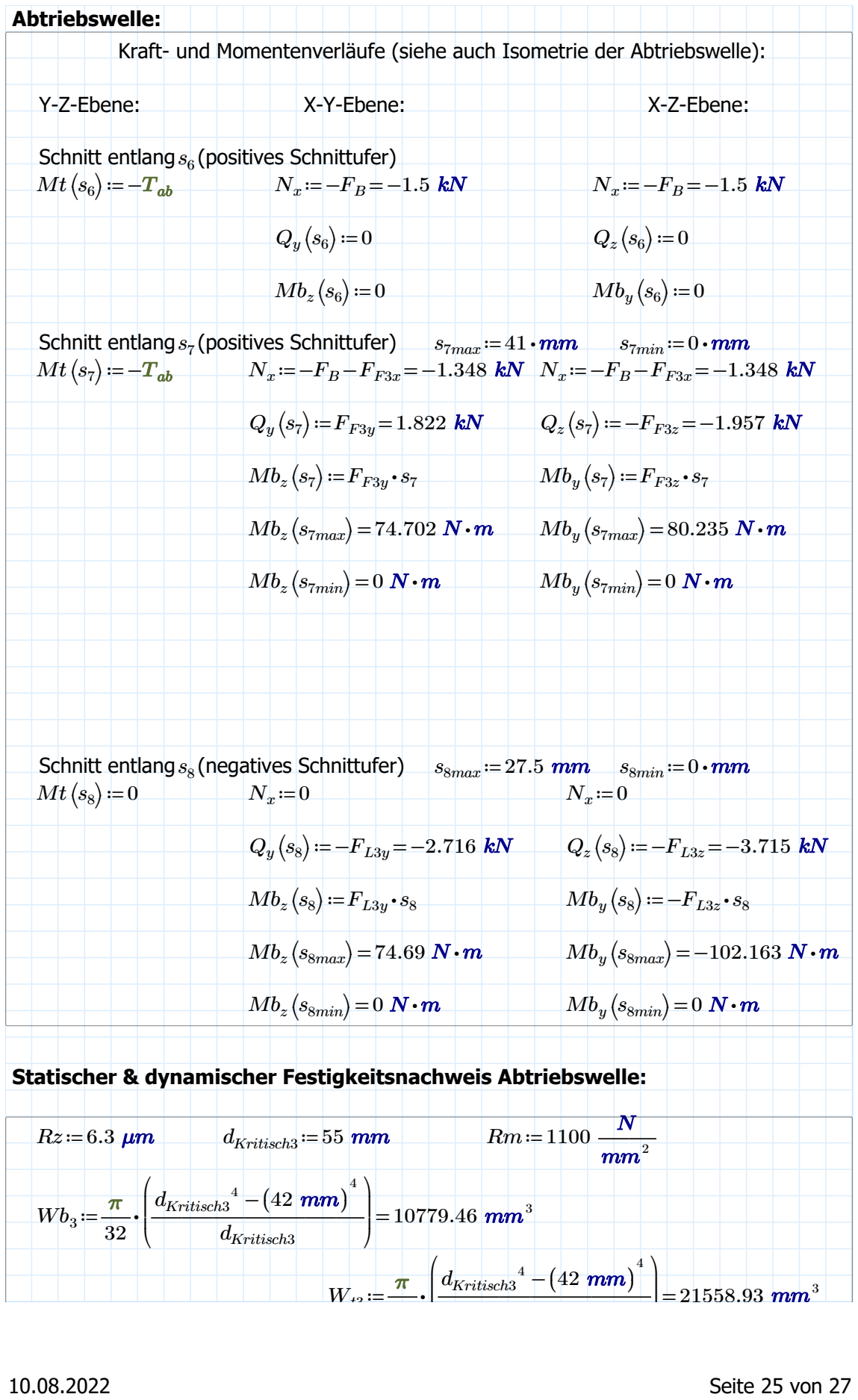
[picture p19: figure]
Abtriebswelle:; Y-Z-Ebene:; X-Y-Ebene:; X-Z-Ebene:; Schnitt entlangs; (positives Schnittufer) 6; ⎠≔-Tab; Mbz; Mby; Schnitt entlangs7 (positives Schnittufer); s7max≔41 ⋅mm; s7min≔0 ⋅mm; ⎛⎝s7max⎞; ⎛⎝s7max⎞ ⎠=80.235 N ⋅m; ⎛⎝s7min⎞; ⎛⎝s7min⎞ ⎠=0 N ⋅m; Schnitt entlangs8 (negatives Schnittufer); s8max≔27.5 mm; s8min≔0 ⋅mm; ⎛⎝s8max⎞; ⎛⎝s8max⎞ ⎠=-102.163 N ⋅m; ⎛⎝s8min⎞; ⎛⎝s8min⎞ ⎠=0 N ⋅m; Statischer & dynamischer Festigkeitsnachweis Abtriebswelle:; dKritisch3≔55; Rm≔1100 ―N―mm²; dKritisch3; 10779.46 mm³; dKritisch3 -; 21558.93 mm³; 10.08.2022 Seite 25 von 27

Kraft- und Momentenverläufe (siehe auch Isometrie der Abtriebswelle):

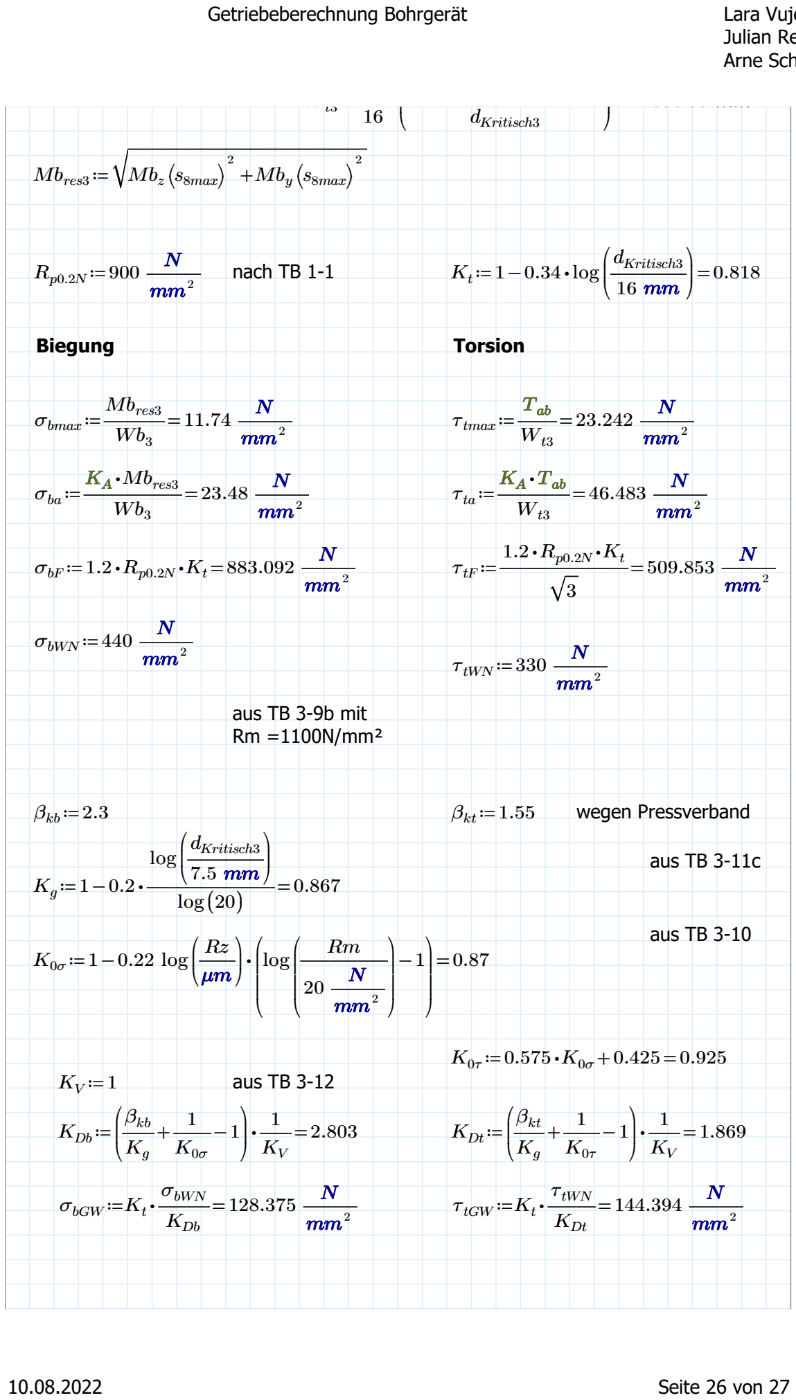
[picture p20: figure]
dKritisch3; Mbres3≔; Mbz; ⎛⎝s8max⎞; Mby; ⎛⎝s8max⎞ ⎠; Rp0.2N≔900 ―N―mm²; nach TB 1-1; Kt≔1-0.34 ⋅log; dKritisch3 16 mm; Biegung; Torsion; σbmax≔―――=; Mbres3 Wb3; 11.74 ―N―mm²; τtmax≔――=; Tab; 23.242 ―N―mm²; σba≔――――=; KA ⋅Mbres3 Wb3; 23.48 ―N―mm²; τta≔―――=; KA ⋅Tab; 46.483 ―N―mm²; σbF≔1.2 ⋅Rp0.2N ⋅Kt=883.092; ―N―mm²; τtF≔―――――=; 509.853 ―N―mm²; σbWN≔440 ―N―mm²; τtWN≔330; aus TB 3-9b mit Rm =1100N/mm²; βkb≔2.3; βkt≔1.55; wegen Pressverband; aus TB 3-11c; log; dKritisch3 7.5 mm; log((20)); aus TB 3-10; K0σ≔1-0.22 log; ―Rm――― 20 ―N―mm²; aus TB 3-12; KDb≔; βkb Kg; KDt≔; βkt Kg; σbGW ≔Kt; σbWN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

SF≔――――――――=

1

+

⎛
⎜
⎝

――

σbmax

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
τtmax

τtF

⎞
⎟
⎠

2

21.06

SD≔―――――――=

1

+

⎛
⎜
⎝

――

σba

σbGW

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
τtGW

⎞
⎟
⎠

2

2.701

Ergebnis: Die Abtriebswelle ist dauerfest.

Schmierstoffberechnung

Für Auslegung eines Schmierstoffes für das Getriebe muss zuerst die benötigte kinematische Nennviskosität des Schmieröles bestimmt werden. Diese erhalten wir über TB 20-7 a) mit Hilfe des Kraft-Geschwindigkeits-Faktors ―. Es wird die Umfangsgeschwindigkeit und Durchmesser von ks v

Zahnrad 4 gewählt.

u≔―

z4 z3 | nAbtrieb≔――― nAntrieb i'Gesamt
ks≔ | ⋅ | =

⎛
⎜
⎝

3 ⋅――⋅

FtZ4
b | ⋅ 4 | d4

―u+―1
u

⎞
⎟
⎠

――1――― π⋅d ⋅ 4 nAbtrieb
0.893 ―⋅

s
m

MPa
υ
Durch das Ablesen von TB 20-7 a) ergibt sich ca. ein Wert von: | ν40≔2.3 ⋅ 10 | ⋅

2 ―mm―

2
s

Gewähltes Schmieröl:
DIN 51517 - CLP 220: Umlaufschmieröl auf Basis eines Mineralöls (C) mit Zusatzstoffen für erhöhten Korrosionsschutz, Alterungsbeständigkeit (L), sowie Herabsetzung der Reibung und des Verschleißes (P).
Geeignet für kinematische Viskositäten von | ν | ≔ | - ISO VG 220 (220). 40 | 198‥.242 ―mm―

2
s

10.08.2022 Seite 27 von 27
