JulianRe24/ME3-Entwurf/Unterlagen/Bohrgerät-Getriebe_Berechnung Stand 11.04.pdf

Getriebeberechnung Bohrgerät | Lara Vujevic
Julian Reimann
Arne Schlemermeyer

Vereinbarte Konstanten:

Normaleingriffs-winkelwinkel:

Schrägungswinkel: Überschlägiger Belastungswert:

Anwendungsfaktor:

αn ≔20 | ° | β ≔20 ° | Bzul ≔4 | ―N―mm²
KA ≔2.0

Druckkraft
vom Boden:
Schaltdrehzahl: | Dauerfestigkeitsschubspannung:
FB ≔1500 N | ns ≔1400 rpm | τTzul ≔50 ―N―mm²
(42CrMo4)

Antriebsdrehzahl:
nAntrieb ≔2000 ―1―min

Übersetzungsverhältnis:

Antriebsmoment:
Tan ≔50 N ⋅m

Theoretisch benötigte Übersetzungen:
i1 ≔3.40 | i2 ≔2.95 | orientiert an TB 21-11
iGesamt ≔i | ⋅ 1

i2

iGesamt =10.03

Errechnete Übersetzungen (siehe Zahnraddaten):
i'1 ≔3.381 | i'2 ≔2.964
i'Gesamt ≔i' | ⋅ 1

i'2

i'Gesamt =10.021

Moment der Vorgelegewelle:
TVorgelege ≔T | ⋅ an | i'1 | TVorgelege =169.05 N ⋅m

Abtriebsmoment:

Tab ≔T | ⋅ an | i'Gesamt | Tab =501.064 N ⋅m

11.04.2022 Seite 1 von 32

Fliehkraftkupplung:

NFK ≔2 | FF ≔15 N | ns ≔1400 ―1―min
ωs ≔2 π⋅ns =146.608 | ―1
s
rFK ≔50 mm | μ0 ≔0.9
mFK ≔1 kg | Δl ≔2.5 mm

dR ≔140 mm

Federsteifigkeit: | C ≔―― FF
Δl

C =6 ―N―mm

Bei Schaltdrehzahl:

Fliehkraft: | FFlieh ≔mFK ⋅ rFK ⋅ωs
2 | FFlieh =1.075 | kN
Kontaktkraft: | FN ≔⎛⎝FFlieh -2 ⋅FF

⎞
⎠ | FN =1.045 | kN
Reibkraft eines Fliehkörpers: | FR ≔μ | ⋅ 0 | FN | FR =940.221 N
Reib-/Schaltmoment: | TR ≔NFK ⋅FR ⋅―

dR
2

TR =131.631 N·m

11.04.2022 Seite 2 von 32

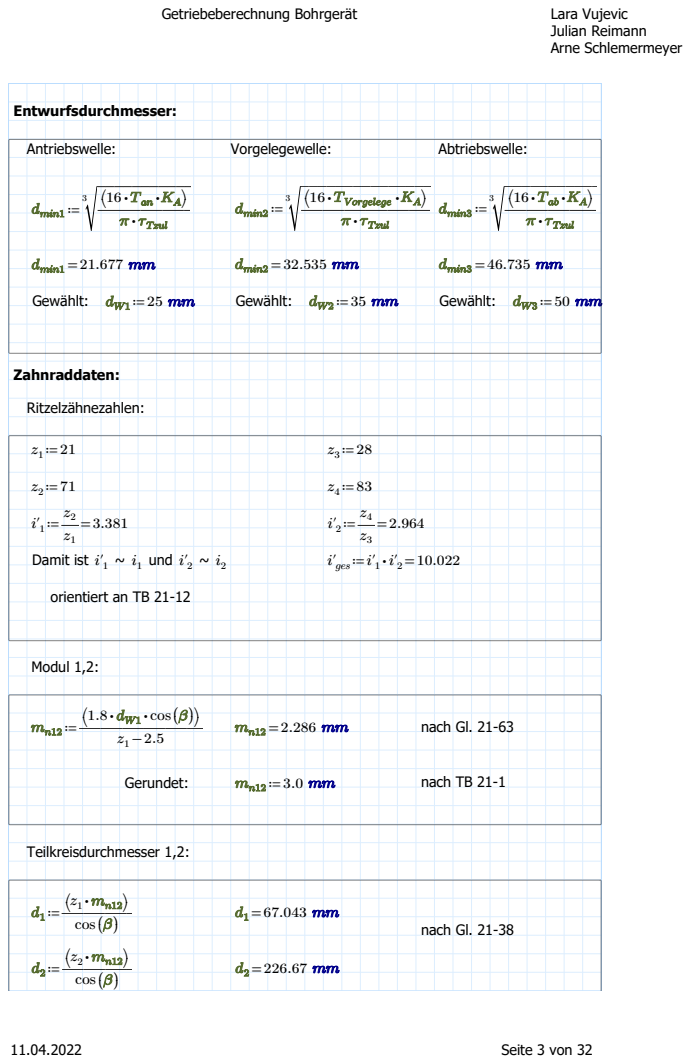
[picture p21: page 3]
Entwurfsdurchmesser:; Antriebswelle:; Vorgelegewelle:; Abtriebswelle:; dmin2 ≔; ⎛⎝16 ⋅TVorgelege ⋅KA; π⋅τTzul; dmin3 ≔; dmin1 ≔; dmin1 =21.677 mm; dmin2 =32.535 mm; dmin3 =46.735 mm; Gewählt:; Zahnraddaten:; Ritzelzähnezahlen:; Damit ist i' ~; und; i'ges≔i'1; Modul 1,2:; ⎛⎝1.8 ⋅dW1 ⋅ cos ((β))⎞ ⎠; nach Gl. 21-63; Gerundet:; nach TB 21-1; Teilkreisdurchmesser 1,2:; cos ((β)); nach Gl. 21-38; 11.04.2022 Seite 3 von 32

orientiert an TB 21-12

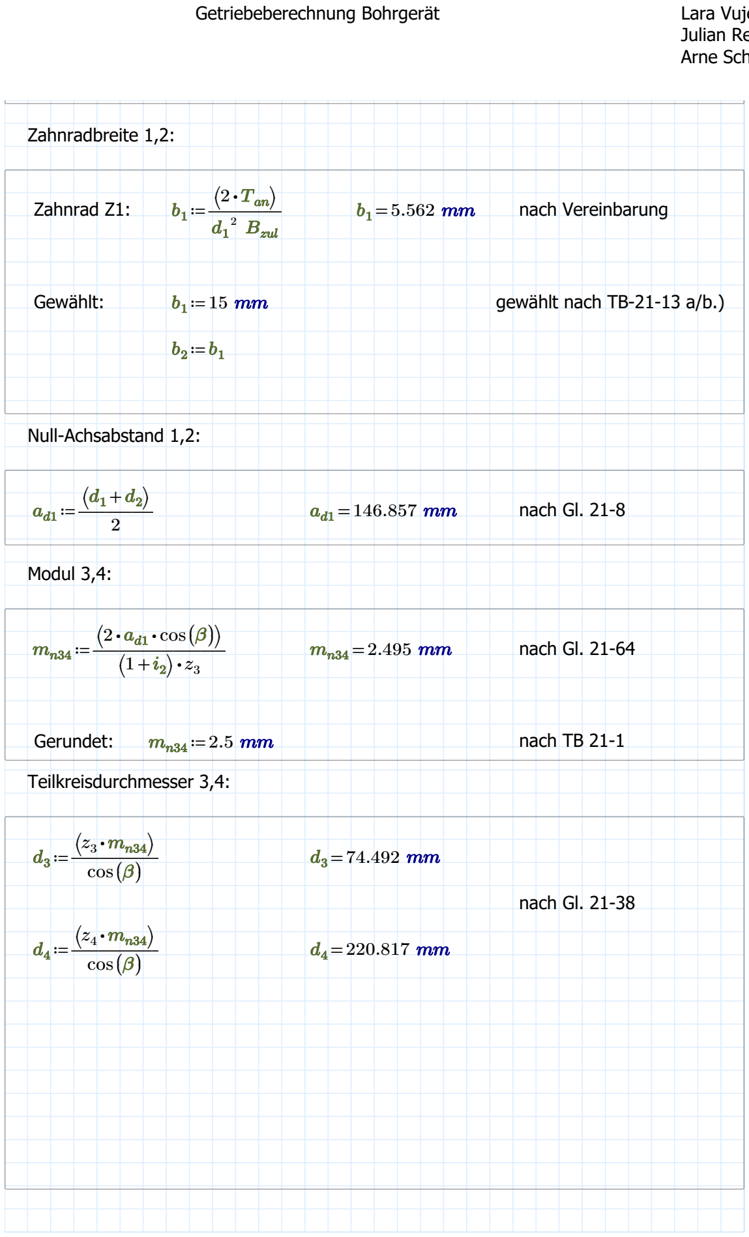
[picture p22: figure]
Zahnradbreite 1,2:; Zahnrad Z1:; ⎛⎝2 ⋅Tan; 2 Bzul; nach Vereinbarung; Gewählt:; gewählt nach TB-21-13 a/b.); Null-Achsabstand 1,2:; nach Gl. 21-8; Modul 3,4:; ⋅ d1 cos ((β))⎞; nach Gl. 21-64; Gerundet:; nach TB 21-1; Teilkreisdurchmesser 3,4:; cos ((β)); nach Gl. 21-38

11.04.2022 Seite 4 von 32

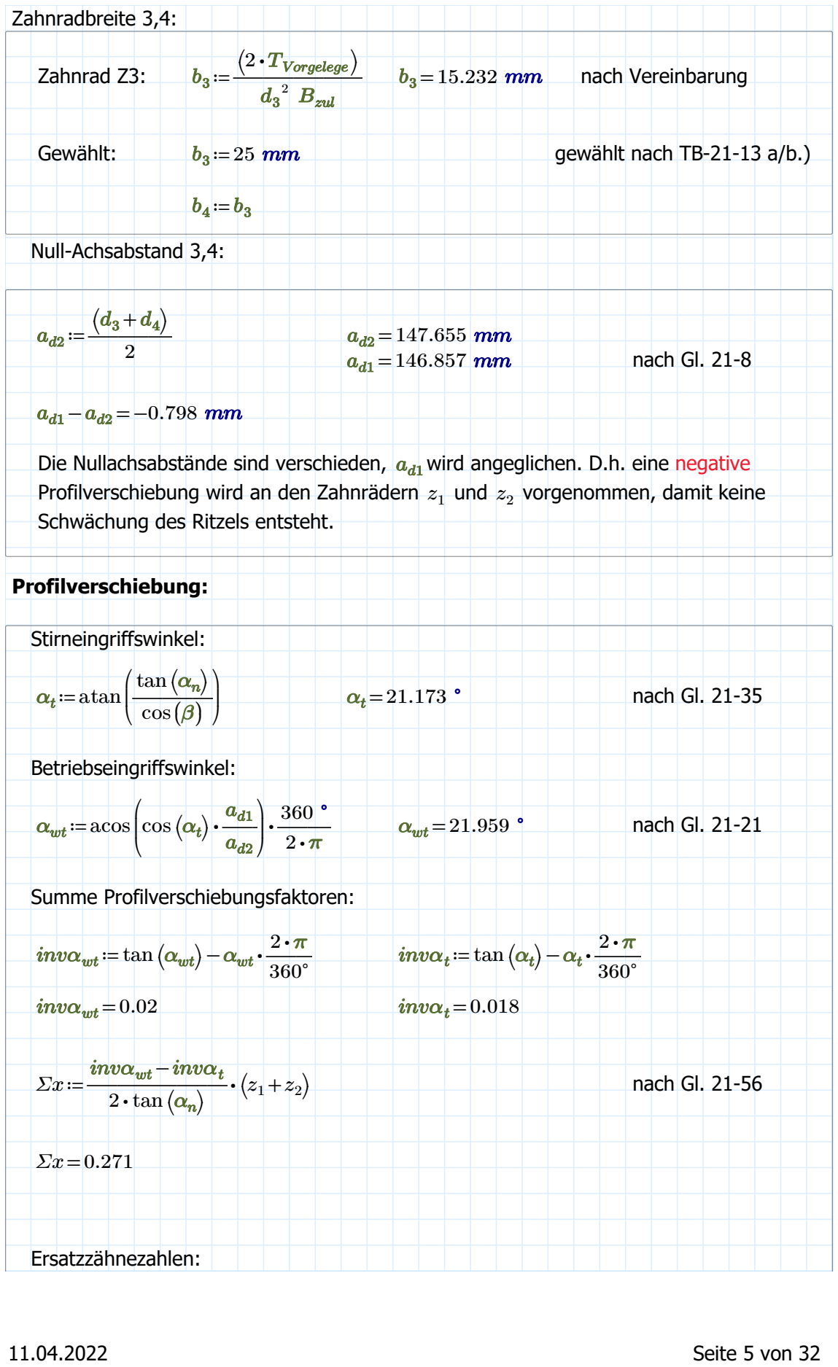
[picture p23: figure]
Zahnradbreite 3,4:; Zahnrad Z3:; ⎛⎝2 ⋅TVorgelege ⎞ ⎠; 2 Bzul; nach Vereinbarung; Gewählt:; gewählt nach TB-21-13 a/b.); Null-Achsabstand 3,4:; nach Gl. 21-8; Profilverschiebung wird an den Zahnrädern; und; vorgenommen, damit keine 1; Schwächung des Ritzels entsteht.; Profilverschiebung:; Stirneingriffswinkel:; αt ≔atan; tan⎛⎝αn; ⎞ ⎠ cos ((β)); nach Gl. 21-35; Betriebseingriffswinkel:; αwt ≔acos; cos ⎛; αwt =21.959 °; nach Gl. 21-21; Summe Profilverschiebungsfaktoren:; invαwt ≔tan⎛⎝αwt⎞; ⎠-αwt ⋅―2 ⋅π―360°; invαt ≔tan⎛⎝αt; invαwt =0.02; invαt =0.018; invαwt -invαt 2 ⋅ tan⎛⎝αn; nach Gl. 21-56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

Die Nullachsabstände sind verschieden, ad1 wird angeglichen. D.h. eine negative

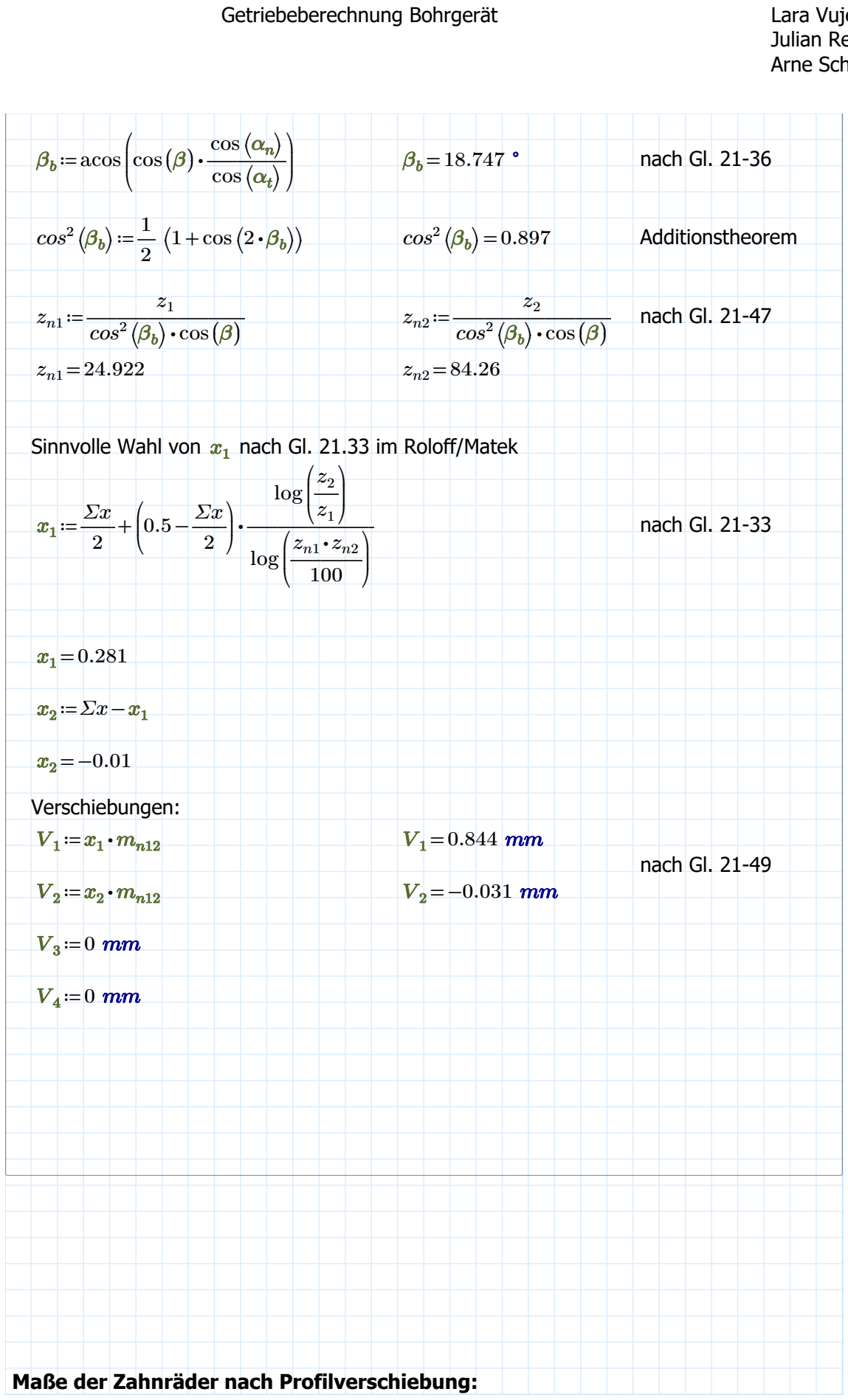
[picture p24: figure]
βb ≔acos; cos ((β)) ⋅―――; cos ⎛⎝αn; cos ⎛⎝αt; nach Gl. 21-36; cos² ⎛⎝βb; ⎛⎝1+cos ⎛⎝2 ⋅βb; Additionstheorem; cos² ⎛; ⎠ cos ((β)); nach Gl. 21-47; log; nach Gl. 21-33; Verschiebungen:; nach Gl. 21-49

Sinnvolle Wahl von x1 nach Gl. 21.33 im Roloff/Matek

Maße der Zahnräder nach Profilverschiebung:

11.04.2022 Seite 6 von 32

Kopfhöhenänderung:

k ≔ad2 -ad1 -m | ⋅ n12 | ⎛⎝x1 +x2

⎞
⎠ | k =-0.014 | mm | nach Gl. 21-23

Kopfspiel (Soll):

c12≔0.25 ⋅mn12 | c12=0.75 mm
| | | nach S.769
c34≔0.25 ⋅mn34 | c34=0.625 | mm

Kopfkreisdurchmesser nach Profilverschiebung:

da1 ≔d1 +2 ⋅mn12 +2 ⋅V1 +2 ⋅k | da1 =74.702 mm | nach Gl. 21-24
da2 ≔d2 +2 ⋅mn12 +2 ⋅V2 +2 ⋅k | da2 =232.578 | mm
da3 ≔d3 +2 ⋅mn34 | da3 =79.492 mm | nach Gl. 21-40
da4 ≔d4 +2 ⋅mn34 | da4 =225.817 | mm

Fußkreisdurchmesser nach Profilverschiebung:

df1 ≔d1 -2 ⋅ ⎛⎝

⎛⎝mn12 +c12⎞
⎠-V1

⎞
⎠ | df1 =61.231 mm | nach Gl. 21-25

df2 ≔d2 -2 ⋅ ⎛⎝

⎛⎝mn12 +c12⎞
⎠-V2

⎞
⎠ | df2 =219.107 | mm
df3 ≔d3 -2.5 ⋅mn34 | df3 =68.242 mm | nach Gl. 21-41
df4 ≔d4 -2.5 ⋅mn34 | df4 =214.567 | mm

Kopfspiel nach Profilverschiebung:

c≔ad2 -0.5 ⋅ ⎛⎝da1 +df2⎞
⎠ | c=0.75 | mm | nach Gl. 21-22c

Prüfen der Zahndicke am Kopfkreis:

11.04.2022 Seite 7 von 32

tangentiales Modul: | mt12 ≔―――

mn12
cos ((β))
min. Kopfdicke des Zahnes: | sa12min ≔0.2 ⋅mn12 | nach S.791

sa12min =0.6 mm

Stirnteilung: | pt12 ≔m | ⋅ t12 | π | nach Gl. 21-34
Stirnzahndicke: | st1 ≔――+

pt12
2

2 ⋅V ⋅ 1 tan⎛⎝αt

⎞
⎠ | nach Gl. 21-51
" s | " ist in Bezug auf den tangentialen Stirnschnitt (S-S) durch das Zahnrad. t1
(S.802 - Bild 21-14)
" sa1 " ist auf den Kopfkreis bezogen

nach S.806
"α " entspricht at1
"αyt1 " aus Roloff Matek

Profilwinkel am Kopfkreis: αat1 ≔acos

⎛
⎜
⎝

――――

d ⋅ 1 cos ⎛⎝αt

⎞
⎠
da1

⎞
⎟
⎠

invαat1 ≔tan⎛⎝αat1⎞

⎠-αat1 ⋅―― | aus Vorlesung 2 ⋅π
360 °

Kopfdicke des Zahnes an den gewählten Zahnrädern (nach Profilverschiebung):

sa1 ≔d ⋅ a1

⎛
⎜
⎝
| | ―+ | | | -
| | st1 d1
invαt
| | | invαat1 | | | ⎞ ⎟ ⎠
sa1 =2.055 | mm | nach Gl. 21-53
Stirnzahndicke: | st2 ≔――+
| | | | | | pt12
| | | | | | 2
2 ⋅V | ⋅ 2 tan⎛⎝αt

⎞
⎠

Profilwinkel am Kopfkreis: αat2 ≔acos

⎛
⎜
⎝

――――

d ⋅ 2 cos ⎛⎝αt

⎞
⎠
da2

⎞
⎟
⎠

invαat2 ≔tan⎛⎝αat2⎞

⎠-α ⋅ at2 ―2 ⋅―π
360 °
Kopfdicke des Zahnes an den gewählten Zahnrädern (nach Profilverschiebung):

sa2 ≔d ⋅ a2

⎛
⎜
⎝
| | ―+ | | | -
| | st2 d2
invαt
| | | invαat2 | | | ⎞ ⎟ ⎠
sa2 =2.583 | mm
Sowohl | s | als auch | sind > | . Die Zahndicke am Kopfkreis ist damit a1 | sa2 | sa12min
ausreichend. Zusätzliche Prüfung über TB 21-8 R/M führt zum gleichen Ergebnis.

Grundkreisdurchmesser db:

11.04.2022 Seite 8 von 32

(Der Durchmesser welcher von der Normalen N-N, die durch den Berührpunkt der Zahnflanken geht, tangiert wird - Bild 21.3)
db1 ≔d | ⋅ 1 | cos ⎛⎝αt

⎞
⎠ | db1 =62.517 mm
db2 ≔d | ⋅ 2 | cos ⎛⎝αt

⎞
⎠ | db2 =211.369 | mm
nach Gl. 21-2
db3 ≔d | ⋅ 3 | cos ⎛⎝αt

⎞
⎠ | db3 =69.464 mm
db4 ≔d | ⋅ 4 | cos ⎛⎝αt

⎞
⎠ | db4 =205.911 | mm

Profilüberdeckung:

Profilüberdeckung des ersten Zahnradpaares:

nach Gl. 21-57
εα12≔――――――――――――――――――

⎛
⎜
⎝
0.5 ⋅ | -

⎛
⎜
⎝

d
a1
- +

### 2 db1

2 ――⋅

z2
|z2
- da2

### 2 db2

2

⎞
⎟
⎠
a | ⋅ d2 | sin⎛⎝αwt⎞
⎠

⎞
⎟
⎠
π⋅m ⋅ t12 cos ⎛⎝αt

⎞
⎠

εα12=1.47

εβ12≔―――― | nach Gl. 21-44
b | ⋅ 1 tan((β))

pt12

εβ12=0.544

εγ12≔εα12+εβ12 | εγ12=2.015 | nach Gl. 21-46

-> Profilüberdeckung des ersten Zahnradpaares ist ausreichend (nach Erklärung S. 804)

Profilüberdeckung des zweiten Zahnradpaares:

εα34≔――――――――――――――――――

⎛
⎜
⎝
0.5 ⋅ | -

⎛
⎜
⎝

d
a3
- +

### 2 db3

2 ――⋅

z2
|z2
- da4

### 2 db4

2

⎞
⎟
⎠
a | ⋅ d2 | sin⎛⎝αwt⎞
⎠

⎞
⎟
⎠
π⋅m ⋅ t12 cos ⎛⎝αt

⎞
⎠

εα34=1.119

εβ34≔――――

b ⋅ 3 tan((β))

pt12

εβ34=0.907

εγ34≔εα34+εβ34 | εγ34=2.026

-> Profilüberdeckung des zweiten Zahnradpaares ist ausreichend (nach Erklärung S. 804)

11.04.2022 Seite 9 von 32

Betriebswälzkreisdurchmesser:

dw1≔――――

d ⋅ 1 cos ⎛⎝αt

⎞
⎠
cos ⎛⎝αwt⎞
⎠
dw1=67.408 mm | nach Gl. 21-22a

dw2≔――――

d ⋅ 2 cos ⎛⎝αt

⎞
⎠
cos ⎛⎝αwt⎞
⎠
dw2=227.902 | mm | nach Gl. 21-22b
dw3≔d3 | dw3=74.492 mm
dw4≔d4 | dw4=220.817 | mm

Kontrolle Achsabstand:

a≔―――=

dw1+dw2
2

147.655 mm
identisch mit:
ad2 =147.655 mm

a≔―――=

dw3+dw4
2

147.655 mm

Zusammenfassung:

d1 =67.043 mm | db1 =62.517 mm | da1 =74.702 mm | df1 =61.231 mm
d2 =226.67 mm | db2 =211.369 | mm | da2 =232.578 | mm | df2 =219.107 | mm
d3 =74.492 mm | db3 =69.464 mm | da3 =79.492 mm | df3 =68.242 mm
d4 =220.817 mm | db4 =205.911 | mm | da4 =225.817 | mm | df4 =214.567 | mm
b1 =15 mm | dw1=67.408 mm | z1=21 | mn12 =3 mm
b2 =15 mm | dw2=227.902 | mm | z2=71
b3 =25 mm | dw3=74.492 mm | z3=28 | mn34 =2.5 | mm
b4 =25 mm | dw4=220.817 | mm | z4=83
V1 =0.844 | mm | εα12=1.47 | εα34=1.119 | x1 =0.281

11.04.2022 Seite 10 von 32

1 | α12 | α34 | 1
V2 =-0.031 mm | εβ12=0.544 | εβ34=0.907 | x2 =-0.01
V3 =0 mm | εγ12=2.015 | εγ34=2.026

V4 =0 mm

Passfederberechnung:

Werkstoff Passfeder E295 GC SF ≔1.1 Re ≔420 ―N―mm²

pfzul≔―Re―SF

pfzul=381.818 ―N―mm²
nach TB 12-1b
φ ≔1 | für n=1 | nPass≔1 | Kλ ≔1 | KA =2

Antriebswelle - Fliehkraftkupplung
für Wellendurchmesser 25mm: | -Passfeder DIN 6885 - A8x7x28
hPass≔7 mm | lPass≔28 mm | h≔3.0 | mm
bPass≔8 | mm | l'Pass≔lPass-bPass | dKritisch1 ≔25 | mm

pm ≔――――――――=

2 ⋅KA ⋅T | ⋅ an | Kλ
dKritisch1 | ⋅h⋅l'Pass ⋅nPass ⋅φ

133.333 ―N―mm²
pm < pfzul | nach Gl. 12-1

Werkstoff Passfeder E295 GC
SF ≔1.1 | Re ≔420 ―N―mm²
| | | pfzul≔―Re―SF | pfzul=381.818 ―N―mm²
nach TB 12-1b
φ ≔1 | für n=1 | nPass≔1 | Kλ ≔1 | KA =2

Abtriebswelle - Rutschkupplung
für Wellendurchmesser 50mm: | -Passfeder DIN 6885 - A14x9x70
hPass≔9 mm | lPass≔70 mm | h≔3.5 | mm
bPass≔14 mm | l'Pass≔lPass-bPass | dKritisch1 ≔50 | mm

11.04.2022 Seite 11 von 32

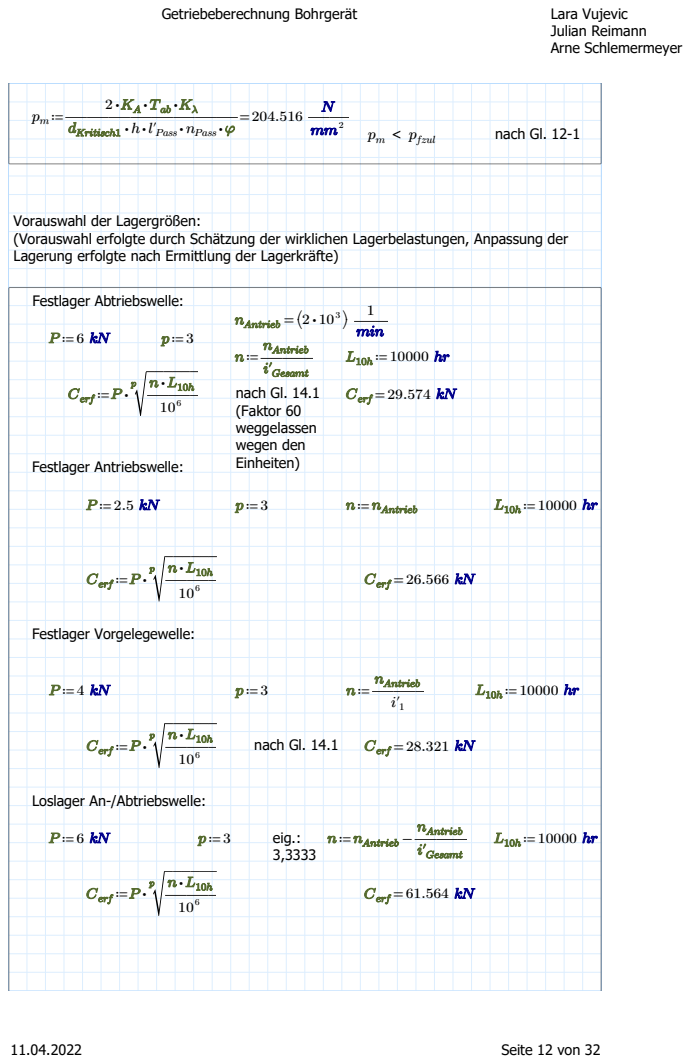
[picture p25: page 12]
dKritisch1; ⋅h⋅l'Pass ⋅nPass ⋅φ; 204.516 ―N―mm²; pm < pfzul; nach Gl. 12-1; Festlager Abtriebswelle:; nAntrieb =⎛⎝2 ⋅ 10³ ⎞; ⎠ ―1―min P ≔6 kN; nAntrieb; i'Gesamt; nach Gl. 14.1 (Faktor 60 weggelassen wegen den Einheiten); Cerf ≔P ⋅; Cerf =29.574; Festlager Antriebswelle:; n ≔nAntrieb; Cerf =26.566; Festlager Vorgelegewelle:; nAntrieb i'1; nach Gl. 14.1; Cerf =28.321; eig.:; n ≔nAntrieb -―――; Cerf =61.564; 11.04.2022 Seite 12 von 32

Vorauswahl der Lagergrößen:
(Vorauswahl erfolgte durch Schätzung der wirklichen Lagerbelastungen, Anpassung der
Lagerung erfolgte nach Ermittlung der Lagerkräfte)

Loslager An-/Abtriebswelle:

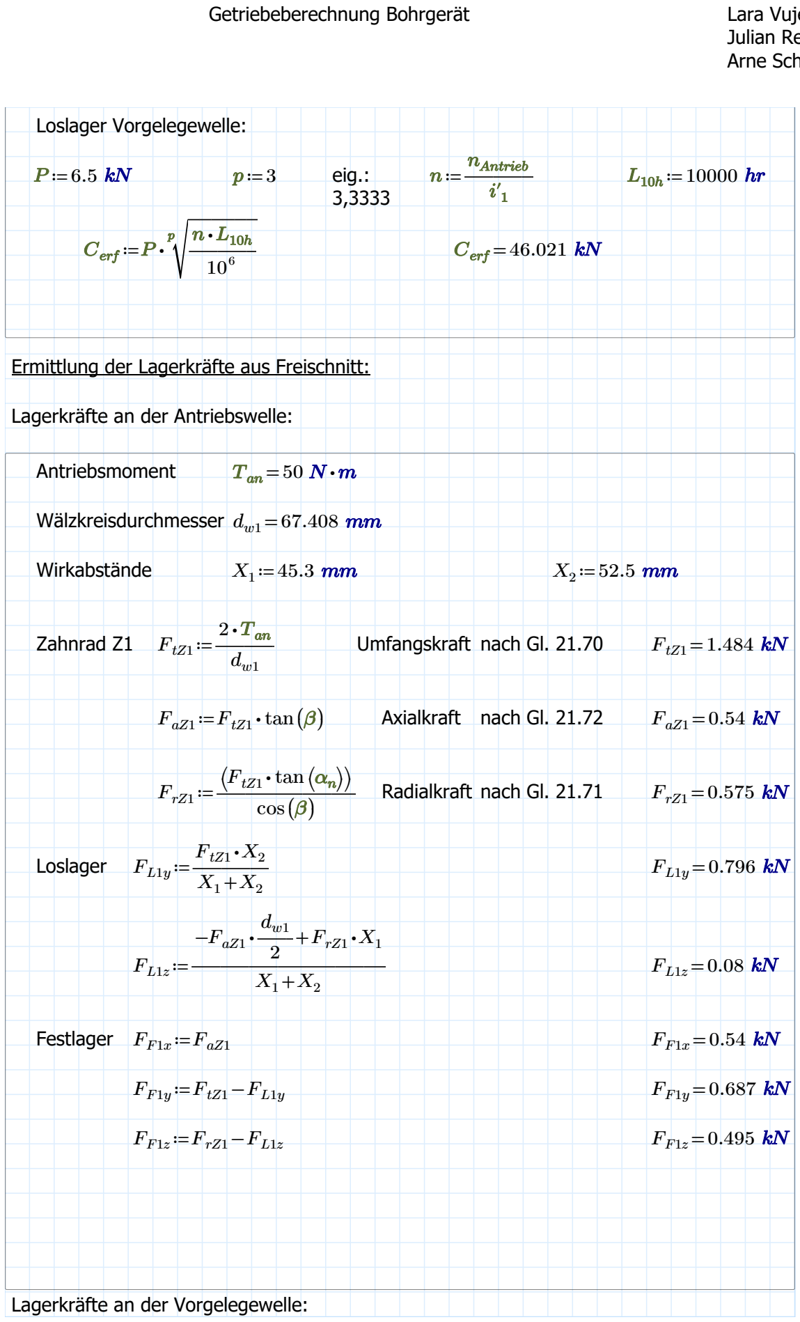
[picture p26: figure]
Loslager Vorgelegewelle:; eig.:; nAntrieb i'1; Cerf ≔P ⋅; Cerf =46.021; Ermittlung der Lagerkräfte aus Freischnitt:; Lagerkräfte an der Antriebswelle:; Antriebsmoment; Tan =50 N ⋅m; Wälzkreisdurchmesser; Wirkabstände; FtZ1≔―――; 2 ⋅Tan; Zahnrad Z1; Umfangskraft; nach Gl. 21.70; FtZ1=1.484 kN; FaZ1≔F; ⋅ tZ1 tan((β)); Axialkraft; nach Gl. 21.72; FaZ1=0.54; FrZ1≔―――――; ⋅ tZ1 tan⎛⎝αn; cos ((β)); Radialkraft; nach Gl. 21.71; FrZ1=0.575 kN; Loslager; -FaZ1 ⋅――+; Festlager; FF1x≔FaZ1; FF1y≔FtZ1-FL1y; FF1z≔FrZ1-FL1z; Lagerkräfte an der Vorgelegewelle:

11.04.2022 Seite 13 von 32

Moment an der Vorgelegewelle: | TVorgelege =169.05 N ⋅m
Wälzkreisdurchmesser | dw2=227.902 | mm | dw3=74.492 mm
Wirkabstände | X3≔48.5 mm | X4≔104.15 mm | X5≔49.85 | mm
Zahnrad Z2 | FaZ2≔-FaZ1 | FtZ2≔-FtZ1 | FrZ2≔-FrZ1

Zahnrad Z3
| FtZ3≔―――― 2 ⋅TVorgelege dw3
FtZ3=4.539 kN
FaZ3≔F | ⋅ tZ3 | tan((β)) | FaZ3=1.652 kN

FrZ3≔―――――

| F ⋅ tZ3 tan⎛⎝αn

⎞
⎠
| cos ((β))

FrZ3=1.758 kN

Loslager | FL2y≔-――――――――
FtZ2 ⋅X3+F | ⋅ tZ3 ⎛⎝X3+X4

⎞
⎠
X3+X4+X5 | FL2y=-3.066 | kN

FL2z≔――――――――――――――――

-FrZ2 ⋅X3+FaZ2 ⋅――+ | +

dw2
2
F | ⋅ rZ3 | ⎛⎝X3+X4

⎞
⎠ | F | ⋅ aZ3 | ――

dw3
2
X3+X4+X5

FL2z=1.463 kN

Festlager | FF2x≔FaZ3+FaZ2 | FF2x=1.112 kN
FF2y≔-FtZ2-FtZ3-FL2y | FF2y=0.011 kN
FF2z≔FrZ2-FrZ3+FL2z | FF2z=-0.87 kN
Die Lagerkräfte | , | und | wurden im Freischnitt falsch
herum orientiert angenommen, daraus resultiert ihr negativer Wert. Für die weitere Berechnung wird die Orientierung der Kraftvektoren positiv angenommen daher folgt:
FL2y | FF2y | FF2z

FL2y≔4.707 kN
FF2y≔0.051 kN
FF2z≔1.303 kN

Lagerkräfte an der Abtriebswelle:

11.04.2022 Seite 14 von 32

Bodenkraft | FB≔1.5 kN
Abtriebsmoment | Tab =501.064 N ⋅m
Wälzkreisdurchmesser | dw4=220.817 | mm
Wirkabstände | X6≔49.35 | mm | X7≔51.65 | mm
Zahnrad Z4 | FaZ4≔-FaZ3 | FtZ4≔-FtZ3 | FrZ4≔-FrZ3

FtZ4≔――

2 ⋅Tab

dw4

FtZ4=4.538 kN

FaZ4≔F | ⋅ tZ3 | tan((β)) | FaZ4=1.652 kN

FrZ4≔―――――

F ⋅ tZ4 tan⎛⎝αn

⎞
⎠
cos ((β))

FrZ4=1.758 kN

Loslager | FL3y≔――――
-F | ⋅ tZ4 | X7
X6+X7

FL3y=-2.321 kN

FL3z≔―――――――

-FrZ4 ⋅X7-F ⋅ aZ4 ――

dw4
2
X6+X7
FL3z=-2.705 | kN
Festlager | FF3x≔-FaZ4+FB | FF3x=-0.152 | kN
| FF3y≔-FtZ4-FL3y | FF3y=-2.217 | kN
FF3z≔-FrZ4-FL3z | FF3z=0.947 kN
Die Lagerkräfte | , | und | wurden im Freischnitt falsch
herum orientiert angenommen, daraus resultiert ihr negativer Wert. Für die weitere Berechnung wird die Orientierung der Kraftvektoren positiv angenommen daher folgt:
FL3y | FL3z | FF3y

FL3y≔3.564 kN
FL3z≔3.176 kN
FF3y≔3.406 kN

Wälzlagerberechnung:

11.04.2022 Seite 15 von 32

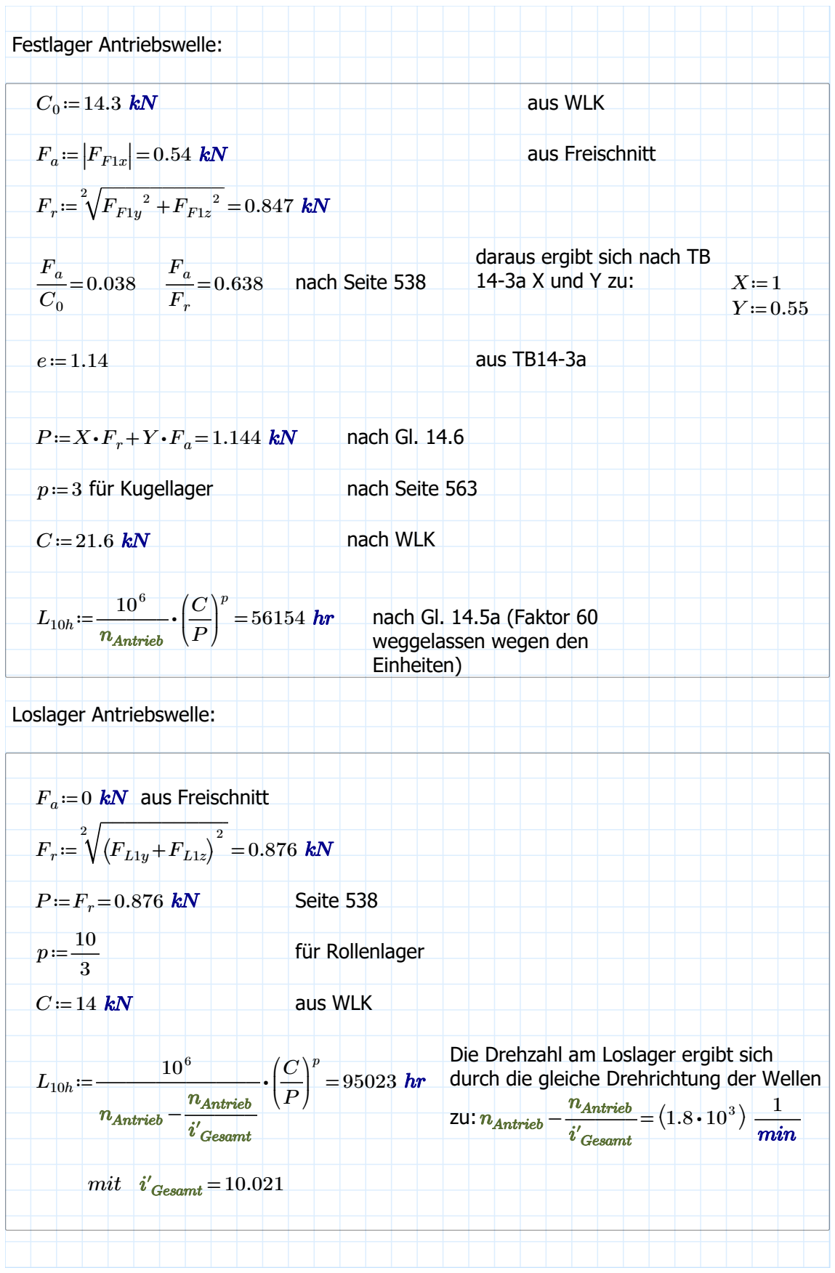
[picture p27: figure]
Festlager Antriebswelle:; aus WLK; aus Freischnitt; aus TB14-3a; nach Gl. 14.6; p≔3 für Kugellager; nach Seite 563; nach WLK; nach Gl. 14.5a (Faktor 60 weggelassen wegen den Einheiten); nAntrieb; Loslager Antriebswelle:; Seite 538; für Rollenlager; Die Drehzahl am Loslager ergibt sich; zu:nAntrieb -―――=; i'Gesamt; ―1―min; nAntrieb -―――; mit; i'Gesamt =10.021

daraus ergibt sich nach TB ―= | nach Seite 538 | 14-3a X und Y zu: | X≔1

durch die gleiche Drehrichtung der Wellen

11.04.2022 Seite 16 von 32

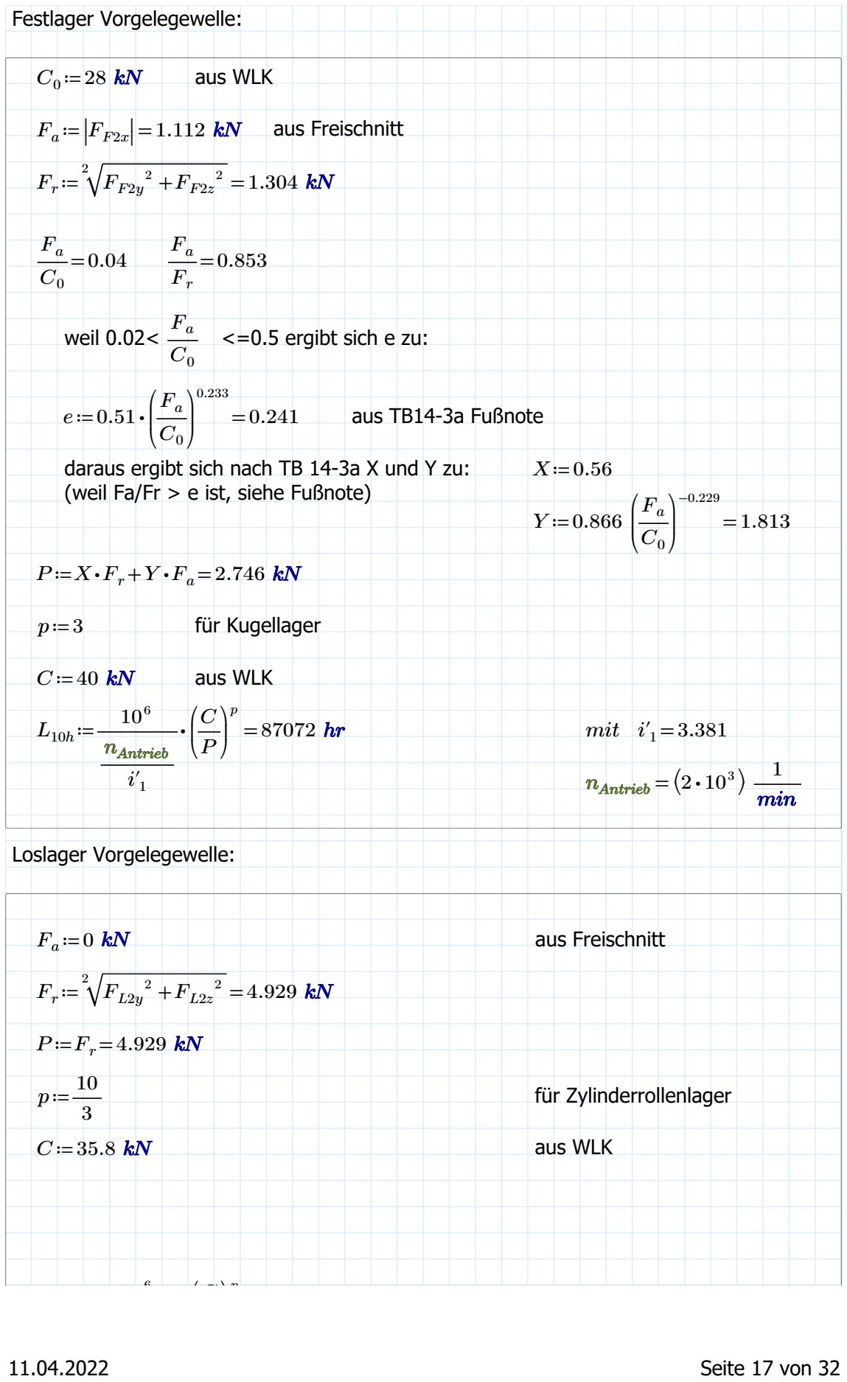
[picture p28: figure]
Festlager Vorgelegewelle:; aus WLK; aus Freischnitt a; weil 0.02<; <=0.5 ergibt sich e zu:; 0.241 aus TB14-3a Fußnote; (weil Fa/Fr > e ist, siehe Fußnote); für Kugellager; nAntrieb i'1; mit; nAntrieb =⎛⎝2 ⋅ 10³ ⎞; ⎠ ―1―min; Loslager Vorgelegewelle:; aus Freischnitt; für Zylinderrollenlager 10; 11.04.2022 Seite 17 von 32

daraus ergibt sich nach TB 14-3a X und Y zu:

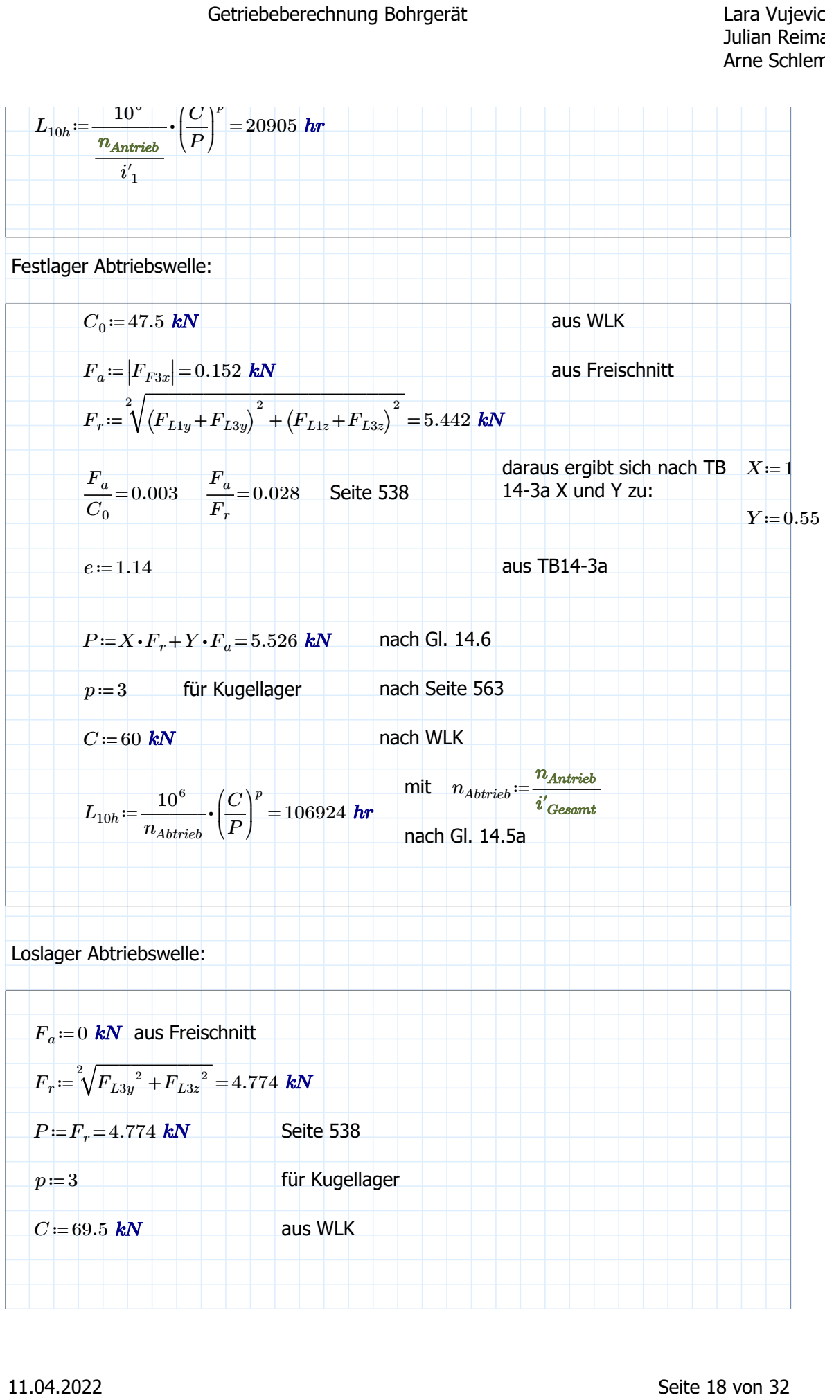
[picture p29: figure]
nAntrieb i'1; Festlager Abtriebswelle:; aus WLK; aus Freischnitt; daraus ergibt sich nach TB 14-3a X und Y zu:; Seite 538; aus TB14-3a; nach Gl. 14.6; für Kugellager; nach Seite 563; nach WLK; mit; nAbtrieb≔―――; nAntrieb; i'Gesamt 10h; nAbtrieb; nach Gl. 14.5a; Loslager Abtriebswelle:; 11.04.2022 Seite 18 von 32

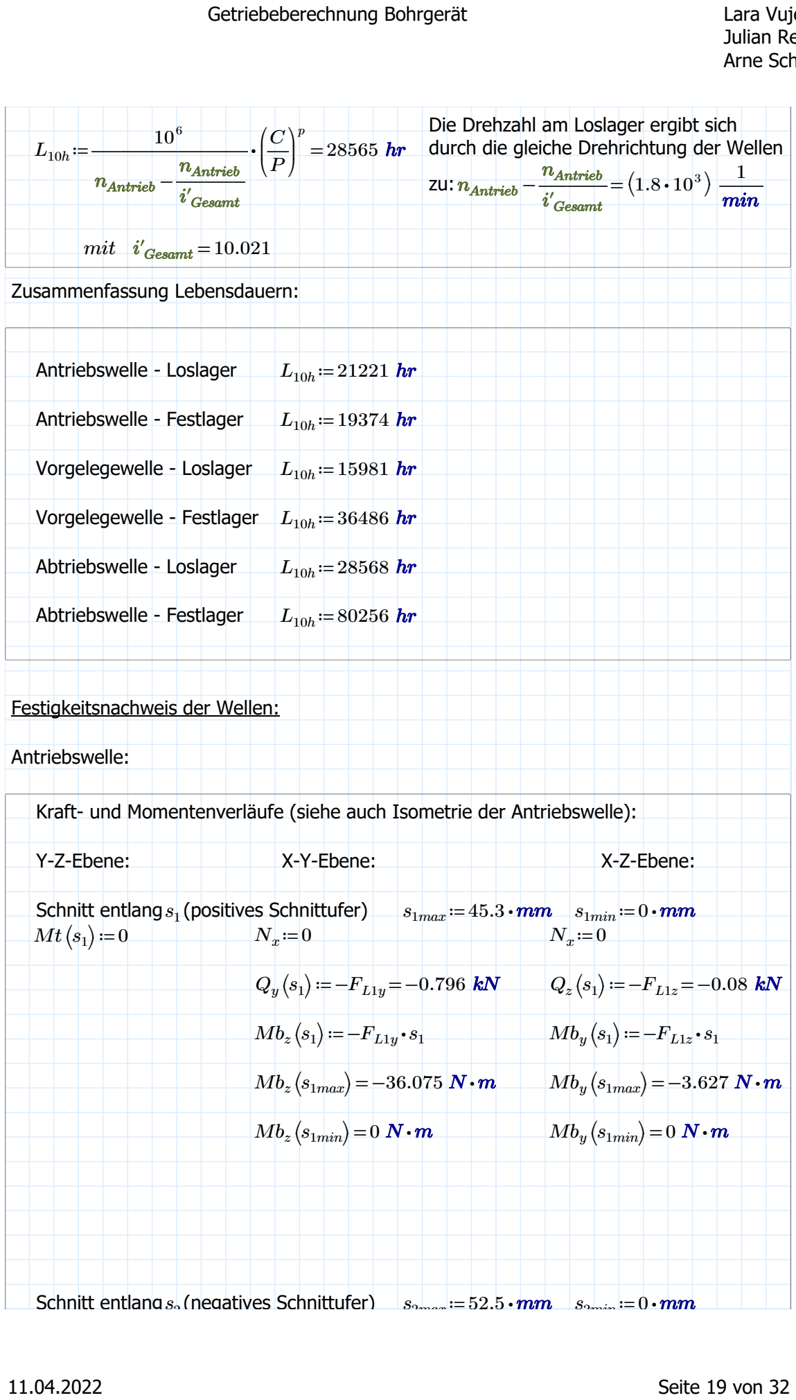
[picture p30: figure]
Die Drehzahl am Loslager ergibt sich; zu:nAntrieb -―――=; nAntrieb; i'Gesamt; ―1―min; nAntrieb -―――; mit; i'Gesamt =10.021; Zusammenfassung Lebensdauern:; Antriebswelle - Loslager; Antriebswelle - Festlager; Vorgelegewelle - Loslager; Vorgelegewelle - Festlager; Abtriebswelle - Loslager; Abtriebswelle - Festlager; Festigkeitsnachweis der Wellen:; Antriebswelle:; Y-Z-Ebene:; X-Y-Ebene:; X-Z-Ebene:; Schnitt entlangs1 (positives Schnittufer); s1max≔45.3 ⋅mm; s1min≔0 ⋅mm; Mbz; Mby; ⎛⎝s1max⎞; ⎛⎝s1max⎞ ⎠=-3.627 N ⋅m; ⎛⎝s1min⎞; ⎛⎝s1min⎞ ⎠=0 N ⋅m; Schnitt entlangs2 (negatives Schnittufer)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

durch die gleiche Drehrichtung der Wellen

Kraft- und Momentenverläufe (siehe auch Isometrie der Antriebswelle):

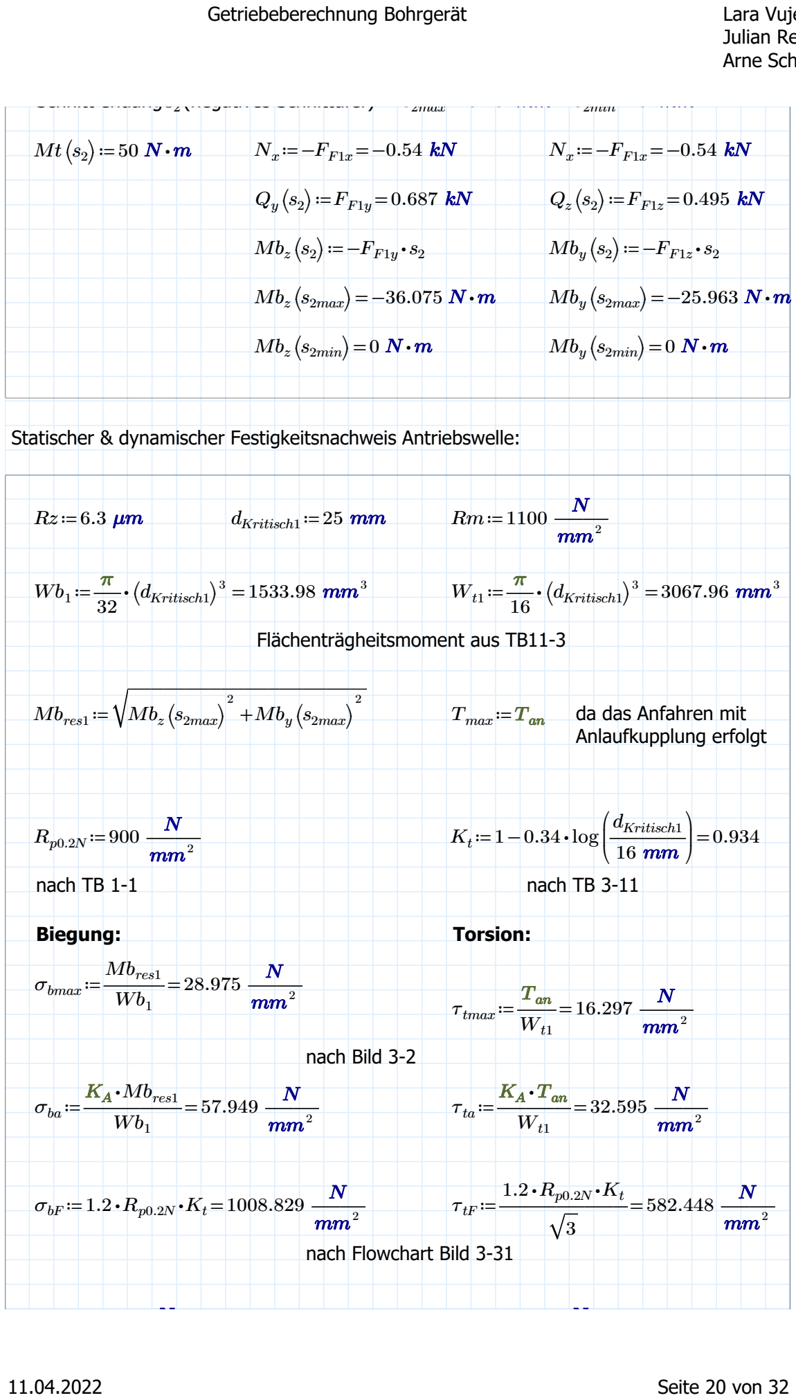
[picture p31: figure]
2max; 2min; Mbz; Mby; ⎛⎝s2max⎞; ⎛⎝s2max⎞ ⎠=-25.963 N ⋅m; ⎛⎝s2min⎞; ⎛⎝s2min⎞ ⎠=0 N ⋅m; Statischer & dynamischer Festigkeitsnachweis Antriebswelle:; dKritisch1≔25; Rm≔1100 ―N―mm²; ⎛⎝dKritisch1⎞ ⎠; mm³; 3 3067.96 mm³; Flächenträgheitsmoment aus TB11-3; Mbres1≔; ⎛⎝s2max⎞ ⎠; Tmax≔Tan; da das Anfahren mit; Anlaufkupplung erfolgt; Rp0.2N≔900 ―N―mm²; Kt≔1-0.34 ⋅log; dKritisch1 16 mm; nach TB 1-1; nach TB 3-11; Biegung:; Torsion:; σbmax≔―――=; Mbres1 Wb1; 28.975 ―N―mm²; τtmax≔――=; Tan; 16.297 ―N―mm²; nach Bild 3-2; σba≔――――=; KA ⋅Mbres1 Wb1; 57.949 ―N―mm²; τta≔―――=; KA ⋅Tan; 32.595 ―N―mm²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

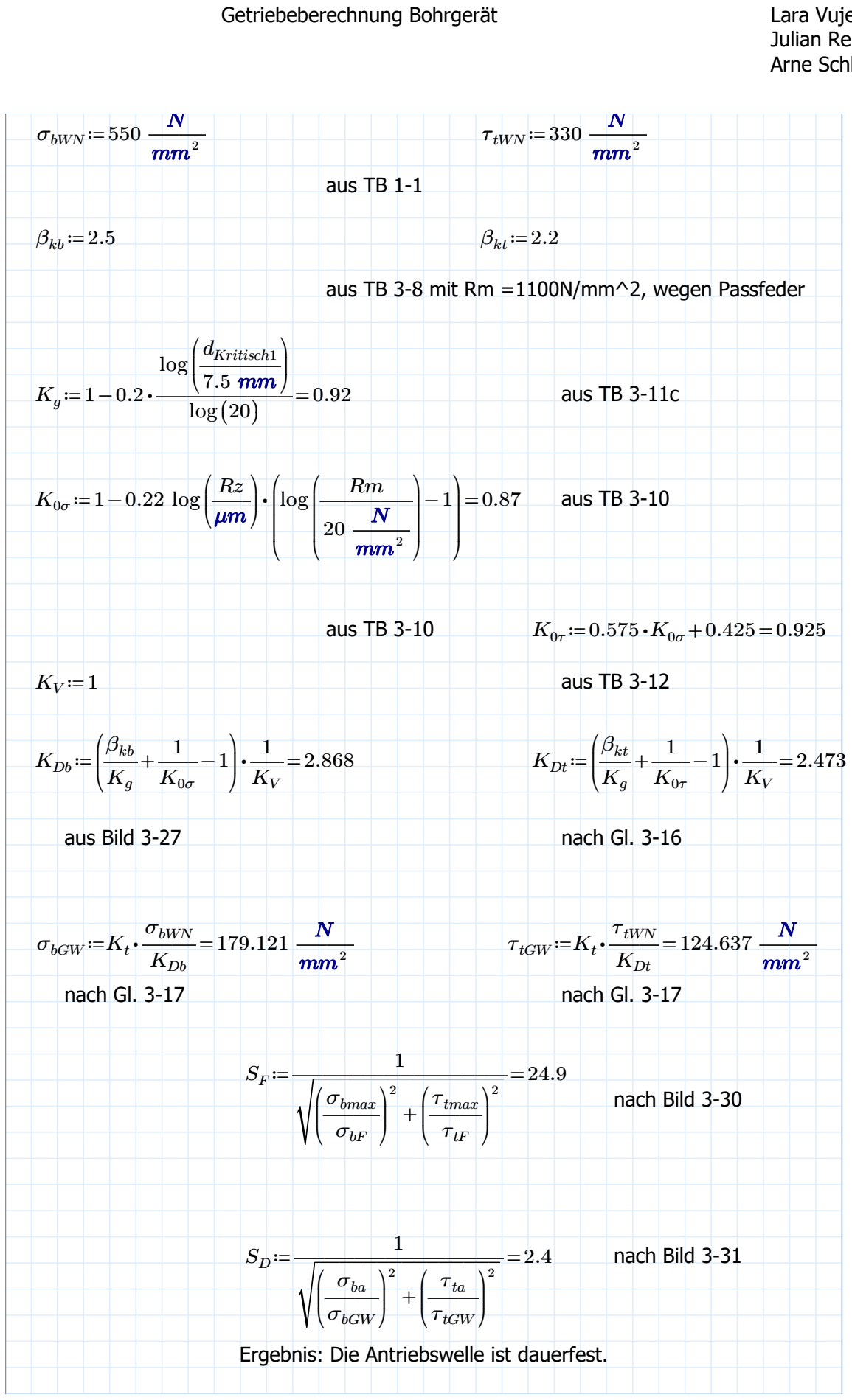
[picture p32: figure]
σbWN≔550 ―N―mm²; τtWN≔330; ―N―mm²; aus TB 1-1; βkb≔2.5; βkt≔2.2; log; dKritisch1 7.5 mm; log((20)); 0.92 aus TB 3-11c; K0σ≔1-0.22 log; ―Rm――― 20 ―N―mm²; 0.87 aus TB 3-10; aus TB 3-10; aus TB 3-12; KDb≔; βkb Kg; KDt≔; βkt Kg; aus Bild 3-27; nach Gl. 3-16; σbGW ≔Kt; σbWN; KDb; 179.121 ―N―mm²; τtGW ≔Kt; τtWN; KDt; 124.637 ―N―mm²; nach Gl. 3-17; σbmax; σbF; τtmax; τtF; nach Bild 3-30; σba; σbGW; τta; τtGW; 2.4 nach Bild 3-31; Ergebnis: Die Antriebswelle ist dauerfest.

aus TB 3-8 mit Rm =1100N/mm^2, wegen Passfeder

11.04.2022 Seite 21 von 32

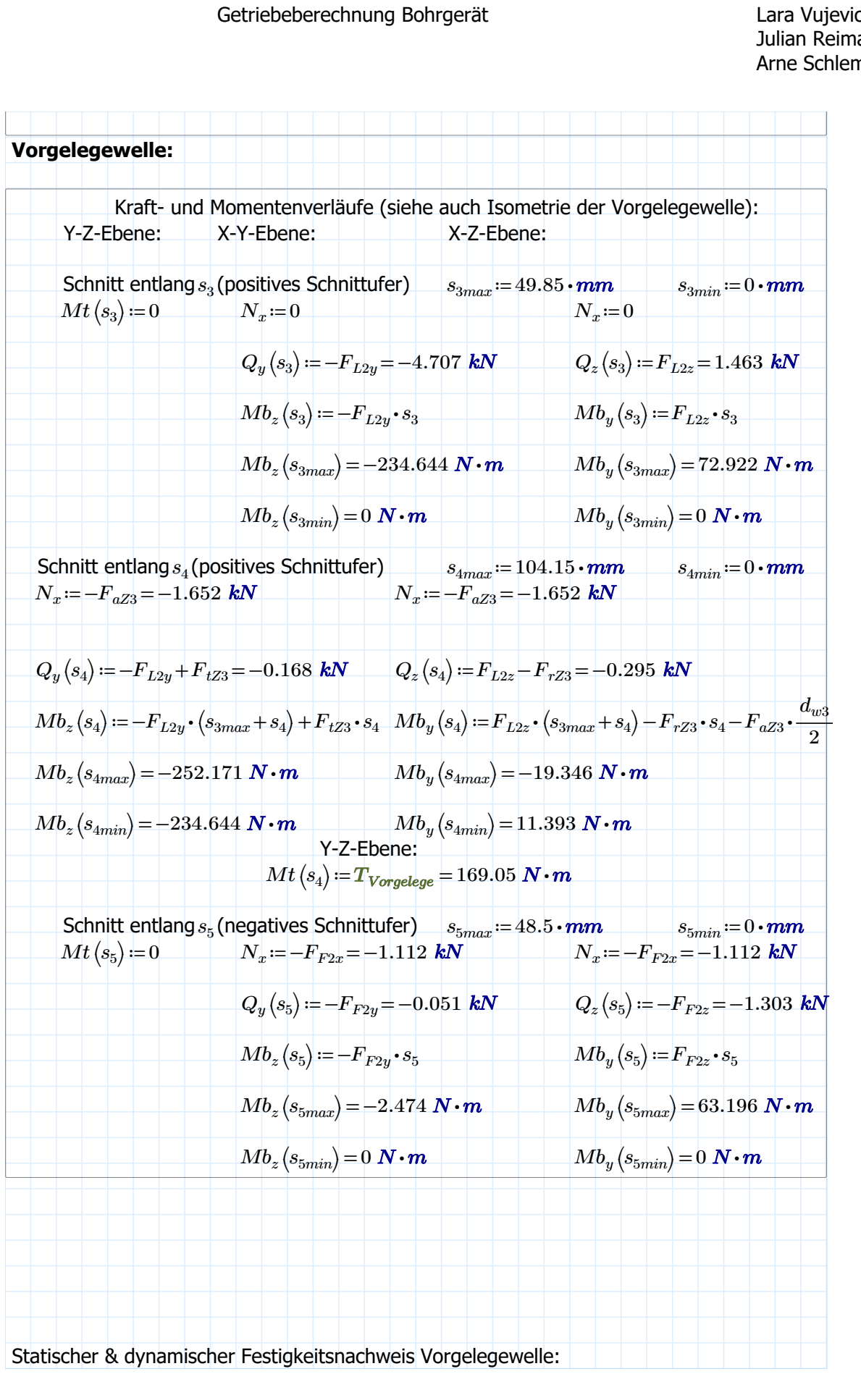
[picture p33: figure]
Vorgelegewelle:; Y-Z-Ebene:; X-Y-Ebene:; X-Z-Ebene:; Mbz; Mby; ⎛⎝s3max⎞; ⎛⎝s3max⎞ ⎠=72.922 N ⋅m; ⎛⎝s3min⎞; ⎛⎝s3min⎞ ⎠=0 N ⋅m; Nx≔-FaZ3=-1.652 kN; ⎠≔-FL2y+FtZ3=-0.168; ⎞ ⎠≔FL2z-FrZ3=-0.295 kN; ⎠≔-FL2y ⋅ ⎛⎝s3max+s4; ⎠≔FL2z ⋅ ⎛⎝s3max+s4; ⎠-FrZ3 ⋅ s4-F; ⎛⎝s4max⎞; ⎛⎝s4max⎞ ⎠=-19.346 N ⋅m; ⎛⎝s4min⎞; ⎛⎝s4min⎞ ⎠=11.393 N ⋅m; Y-Z-Ebene: Mt ⎛⎝s4; ⎞ ⎠≔TVorgelege =169.05 N ⋅m; ⎛⎝s5max⎞; ⎛⎝s5max⎞ ⎠=63.196 N ⋅m; ⎛⎝s5min⎞; ⎛⎝s5min⎞ ⎠=0 N ⋅m

Kraft- und Momentenverläufe (siehe auch Isometrie der Vorgelegewelle):

Schnitt entlangs | (positives Schnittufer) 3 | s3max≔49.85 ⋅mm | s3min≔0 ⋅mm
Schnitt entlangs | (positives Schnittufer) 4 | s4max≔104.15 ⋅mm | s4min≔0 ⋅mm
Schnitt entlangs | (negatives Schnittufer) 5 | s5max≔48.5 ⋅mm | s5min≔0 ⋅mm
⎠≔0 | Nx≔-FF2x=-1.112 kN | Nx≔-FF2x=-1.112 kN

Statischer & dynamischer Festigkeitsnachweis Vorgelegewelle:

11.04.2022 Seite 22 von 32

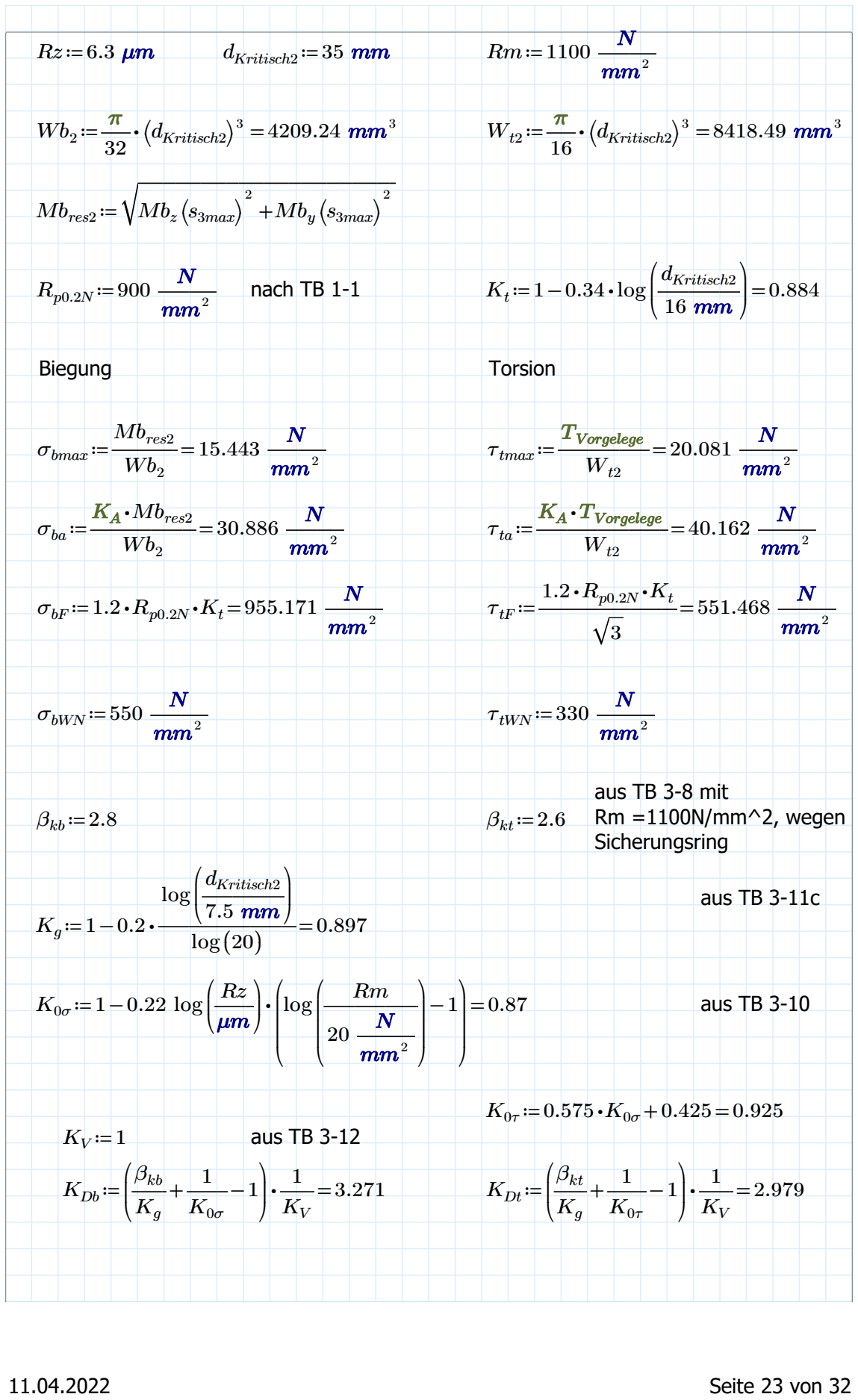
[picture p34: figure]
dKritisch2≔35; Rm≔1100 ―N―mm²; ⎛⎝dKritisch2⎞ ⎠; mm³; 3 8418.49 mm³; Mbres2≔; Mbz; ⎛⎝s3max⎞; Mby; ⎛⎝s3max⎞ ⎠; Rp0.2N≔900 ―N―mm²; nach TB 1-1; Kt≔1-0.34 ⋅log; dKritisch2 16 mm; Biegung; Torsion; σbmax≔―――=; Mbres2 Wb2; 15.443 ―N―mm²; τtmax≔―――=; TVorgelege; 20.081 ―N―mm²; σba≔――――=; KA ⋅Mbres2 Wb2; 30.886 ―N―mm²; τta≔―――――=; KA ⋅TVorgelege; 40.162 ―N―mm²; σbF≔1.2 ⋅Rp0.2N ⋅Kt=955.171; ―N―mm²; τtF≔―――――=; 551.468 ―N―mm²; σbWN≔550 ―N―mm²; τtWN≔330; aus TB 3-8 mit Rm =1100N/mm^2, wegen Sicherungsring; βkb≔2.8; βkt≔2.6; aus TB 3-11c; log; dKritisch2 7.5 mm; log((20)); K0σ≔1-0.22 log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

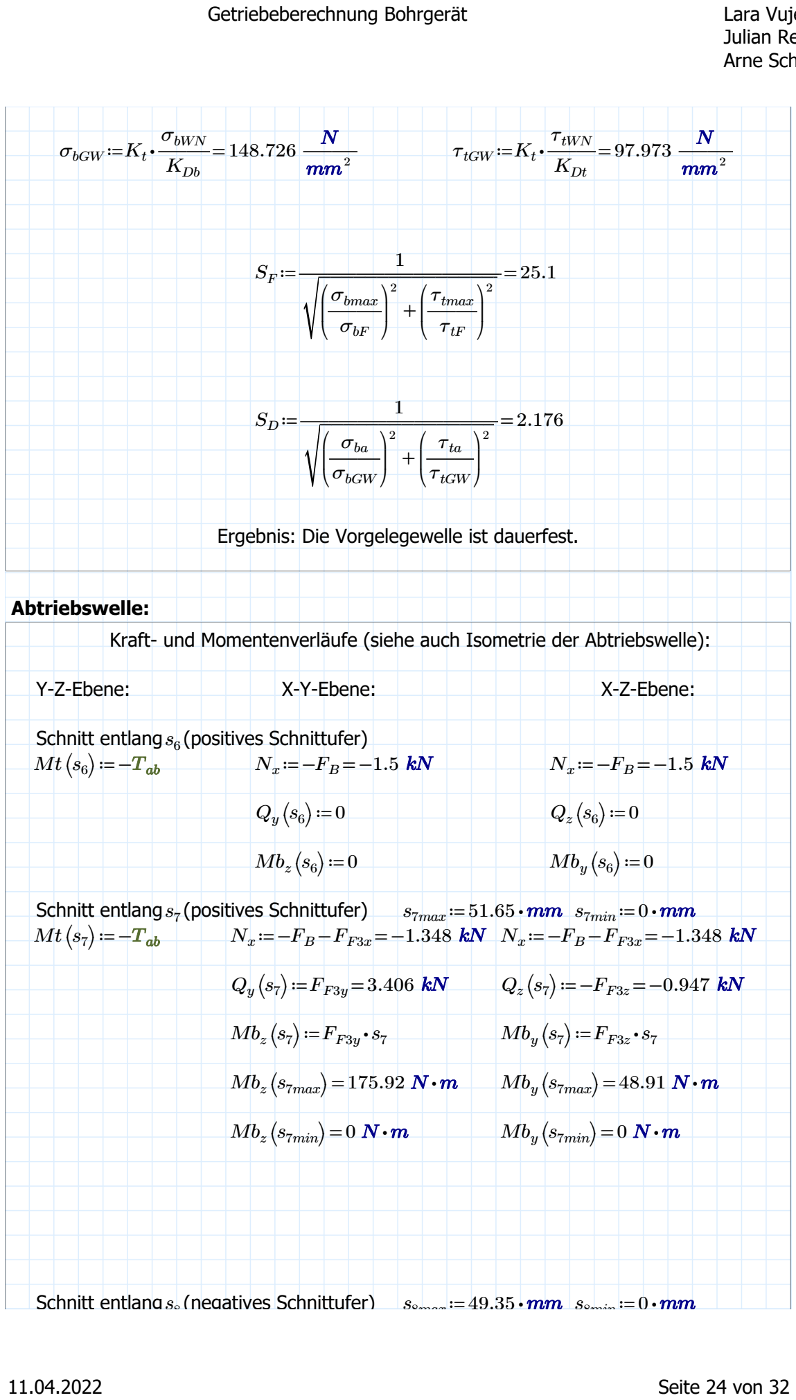
[picture p35: figure]
σbGW ≔Kt; σbWN; KDb; 148.726 ―N―mm²; τtGW ≔Kt; τtWN; KDt; 97.973 ―N―mm²; σbmax; σbF; τtmax; τtF; σba; σbGW; τta; τtGW; Ergebnis: Die Vorgelegewelle ist dauerfest.; Abtriebswelle:; Y-Z-Ebene:; X-Y-Ebene:; X-Z-Ebene:; Schnitt entlangs; (positives Schnittufer) 6; ⎠≔-Tab; Mbz; Mby; Schnitt entlangs7 (positives Schnittufer); s7max≔51.65 ⋅mm; s7min≔0 ⋅mm; ⎛⎝s7max⎞; ⎛⎝s7max⎞ ⎠=48.91 N ⋅m; ⎛⎝s7min⎞; ⎛⎝s7min⎞ ⎠=0 N ⋅m; Schnitt entlangs8 (negatives Schnittufer); s8max≔49.35 ⋅mm; s8min≔0 ⋅mm; 11.04.2022 Seite 24 von 32

Kraft- und Momentenverläufe (siehe auch Isometrie der Abtriebswelle):

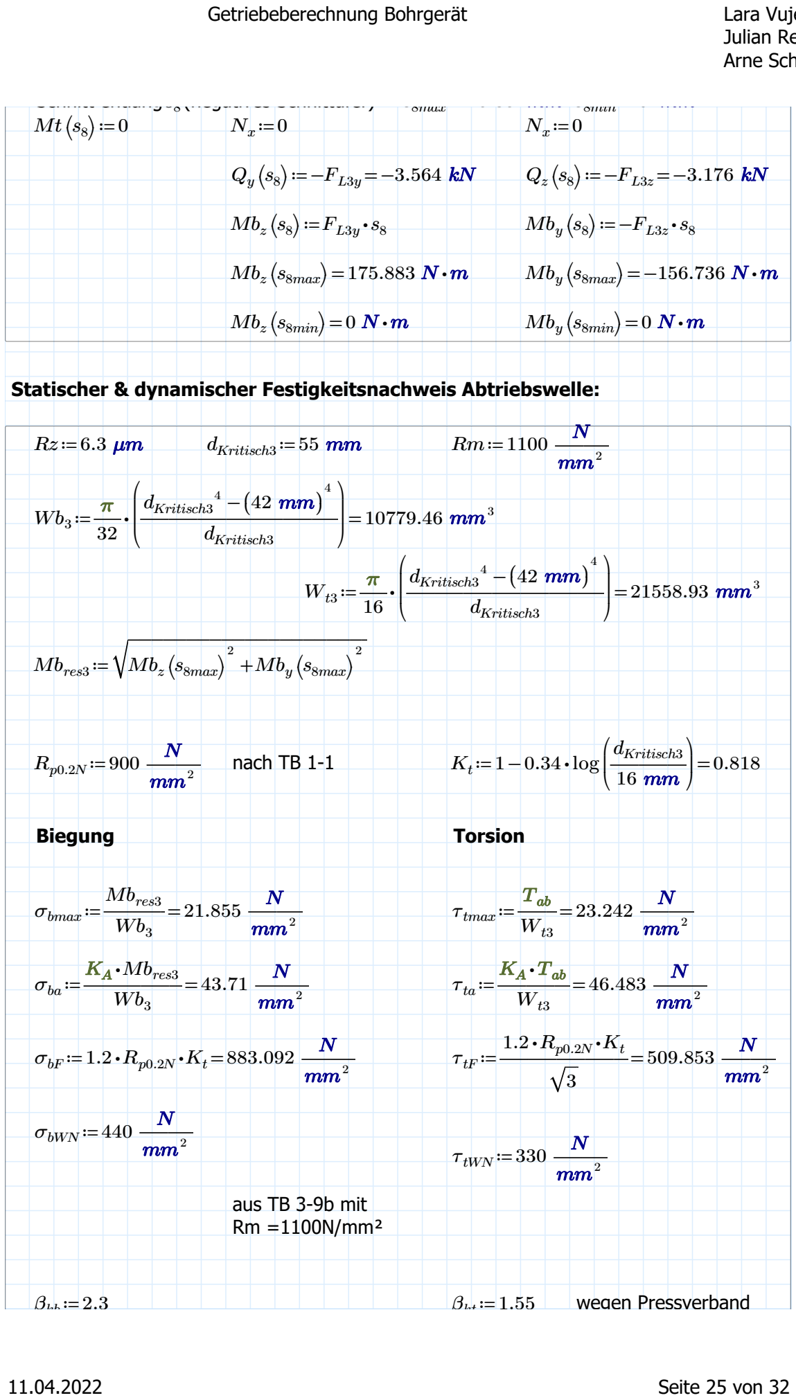
[picture p36: figure]
8max; 8min; Mbz; Mby; ⎛⎝s8max⎞; ⎛⎝s8max⎞ ⎠=-156.736 N ⋅m; ⎛⎝s8min⎞; ⎛⎝s8min⎞ ⎠=0 N ⋅m; Statischer & dynamischer Festigkeitsnachweis Abtriebswelle:; dKritisch3≔55; Rm≔1100 ―N―mm²; dKritisch3; 10779.46 mm³; dKritisch3 -; 21558.93 mm³; Mbres3≔; ⎛⎝s8max⎞ ⎠; Rp0.2N≔900 ―N―mm²; nach TB 1-1; Kt≔1-0.34 ⋅log; dKritisch3 16 mm; Biegung; Torsion; σbmax≔―――=; Mbres3 Wb3; 21.855 ―N―mm²; τtmax≔――=; Tab; 23.242 ―N―mm²; σba≔――――=; KA ⋅Mbres3 Wb3; 43.71 ―N―mm²; τta≔―――=; KA ⋅Tab; 46.483 ―N―mm²; σbF≔1.2 ⋅Rp0.2N ⋅Kt=883.092; ―N―mm²; τtF≔―――――=; 509.853 ―N―mm²; σbWN≔440 ―N―mm²; τtWN≔330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

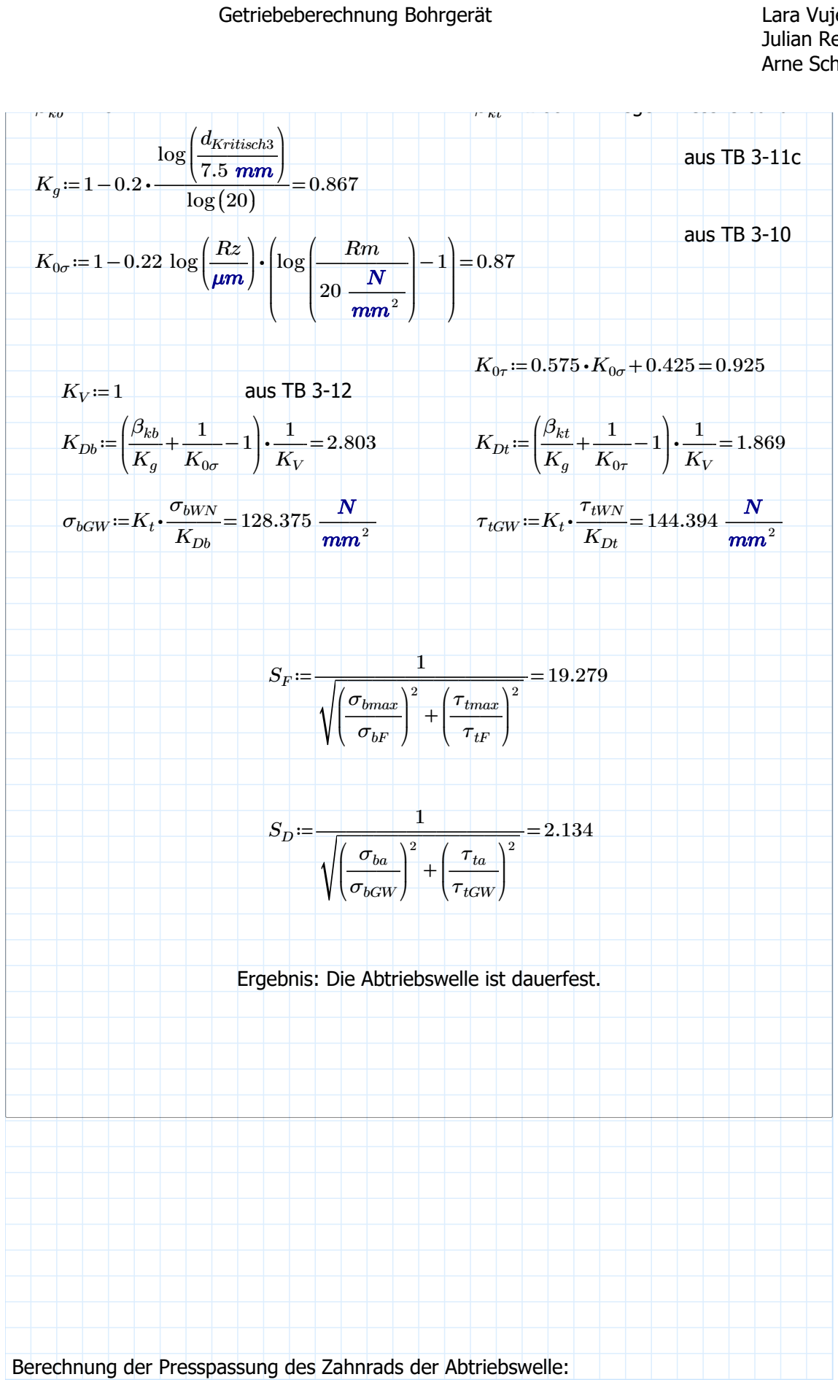
[picture p37: figure]
aus TB 3-11c; log; dKritisch3 7.5 mm; log((20)); aus TB 3-10; K0σ≔1-0.22 log; ―Rm――― 20 ―N―mm²; aus TB 3-12; KDb≔; βkb Kg; KDt≔; βkt Kg; σbGW ≔Kt; σbWN; KDb; 128.375 ―N―mm²; τtGW ≔Kt; τtWN; KDt; 144.394 ―N―mm²; σbmax; σbF; τtmax; τtF; σba; σbGW; τta; τtGW; Ergebnis: Die Abtriebswelle ist dauerfest.

Berechnung der Presspassung des Zahnrads der Abtriebswelle:

11.04.2022 Seite 26 von 32

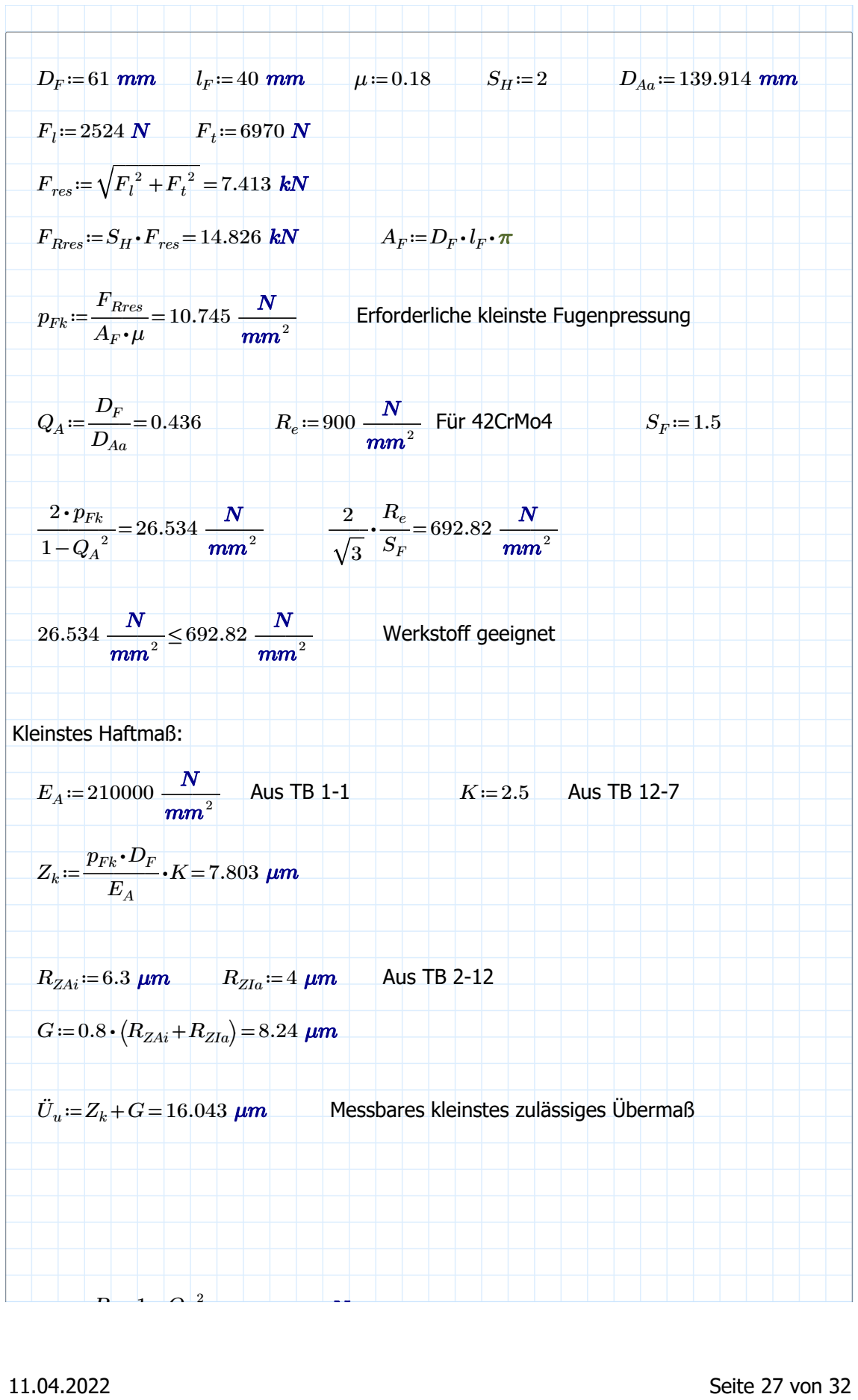
[picture p38: figure]
DAa≔139.914 mm; Fres≔; FRres≔SH ⋅Fres=14.826; pFk≔――=; FRres AF ⋅μ; 10.745 ―N―mm²; Erforderliche kleinste Fugenpressung; DAa; 0.436 Re≔900 ―N―mm²; Für 42CrMo4; 2 ⋅pFk 1- QA; 26.534 ―N―mm²; 692.82 ―N―mm²; N mm²; Werkstoff geeignet; Kleinstes Haftmaß:; EA≔210000 ―N―mm²; Aus TB 1-1; Aus TB 12-7; pFk ⋅ DF EA; RZAi≔6.3 μm; RZIa≔4 μm; Aus TB 2-12; G≔0.8 ⋅ ⎛⎝RZAi+RZIa⎞ ⎠=8.24 μm; Messbares kleinstes zulässiges Übermaß; 11.04.2022 Seite 27 von 32

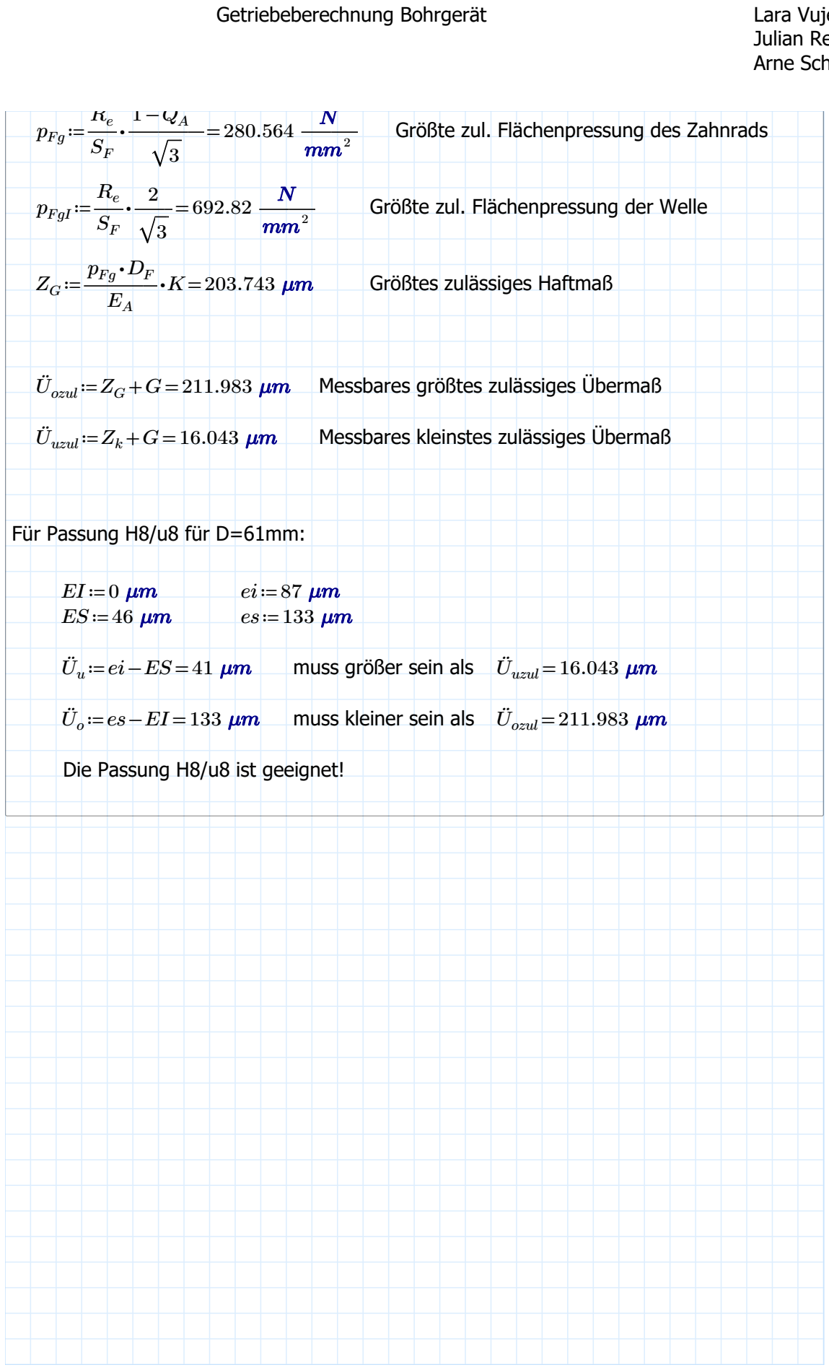
[picture p39: figure]
pFg≔―⋅; 280.564 ―N―mm²; Größte zul. Flächenpressung des Zahnrads; pFgI≔―⋅; 692.82 ―N―mm²; Größte zul. Flächenpressung der Welle; pFg ⋅ DF EA; Größtes zulässiges Haftmaß; Üozul≔ZG +G=211.983 μm; Messbares größtes zulässiges Übermaß; Üuzul≔Zk+G=16.043 μm; Messbares kleinstes zulässiges Übermaß; Für Passung H8/u8 für D=61mm:; muss größer sein als; Üuzul=16.043 μm; muss kleiner sein als; Üozul=211.983 μm; Die Passung H8/u8 ist geeignet!

11.04.2022 Seite 28 von 32

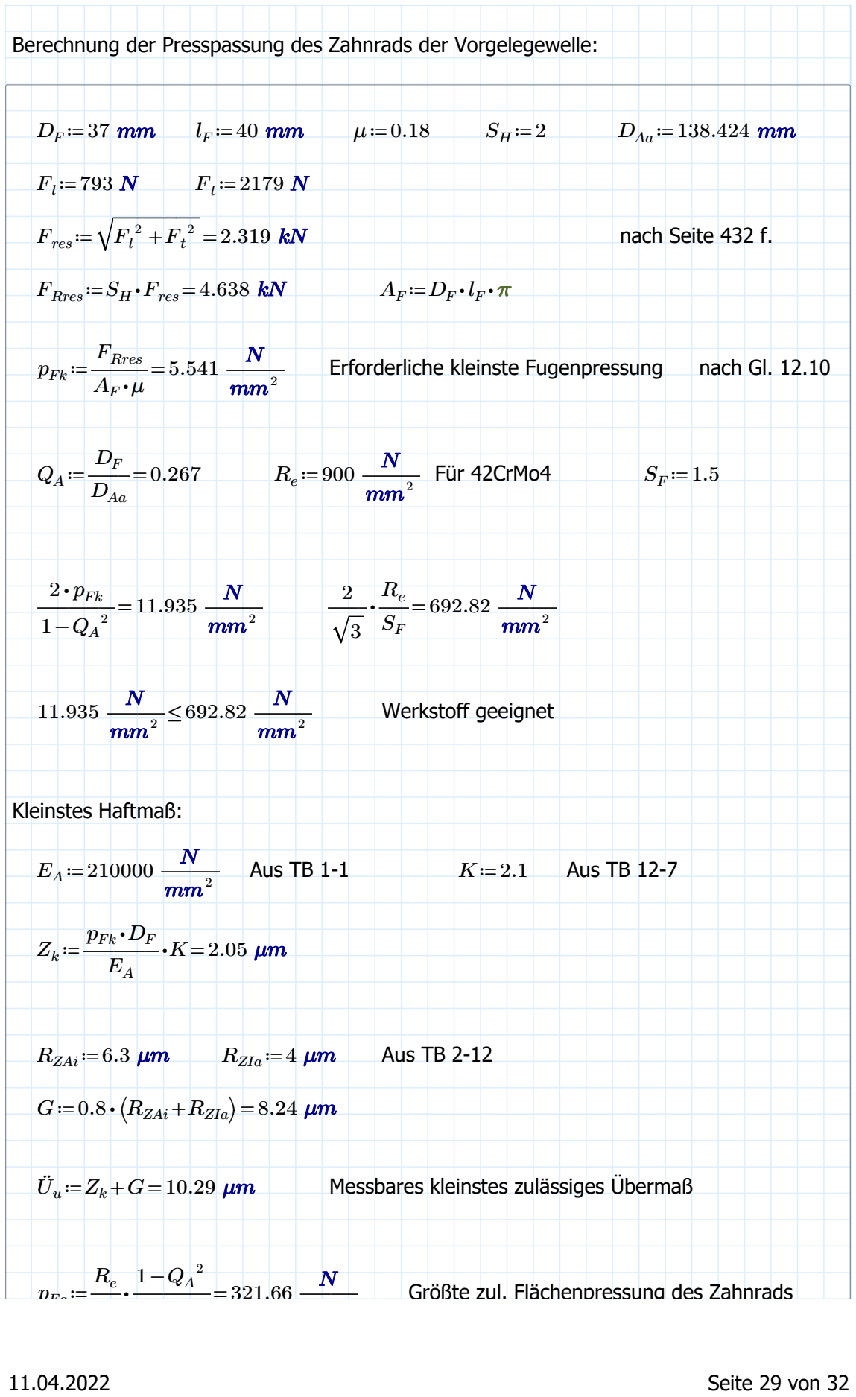
[picture p40: figure]
DAa≔138.424 mm; Fres≔; nach Seite 432 f.; FRres≔SH ⋅Fres=4.638 kN; pFk≔――=; FRres AF ⋅μ; 5.541 ―N―mm²; Erforderliche kleinste Fugenpressung; nach Gl. 12.10; DAa; 0.267 Re≔900 ―N―mm²; Für 42CrMo4; 2 ⋅pFk 1- QA; 11.935 ―N―mm²; 692.82 ―N―mm²; N mm²; Werkstoff geeignet; Kleinstes Haftmaß:; EA≔210000 ―N―mm²; Aus TB 1-1; Aus TB 12-7; pFk ⋅ DF EA; RZAi≔6.3 μm; RZIa≔4 μm; Aus TB 2-12; G≔0.8 ⋅ ⎛⎝RZAi+RZIa⎞ ⎠=8.24 μm; Messbares kleinstes zulässiges Übermaß; pFg≔―⋅; Größte zul. Flächenpressung des Zahnrads; 11.04.2022 Seite 29 von 32

Berechnung der Presspassung des Zahnrads der Vorgelegewelle:

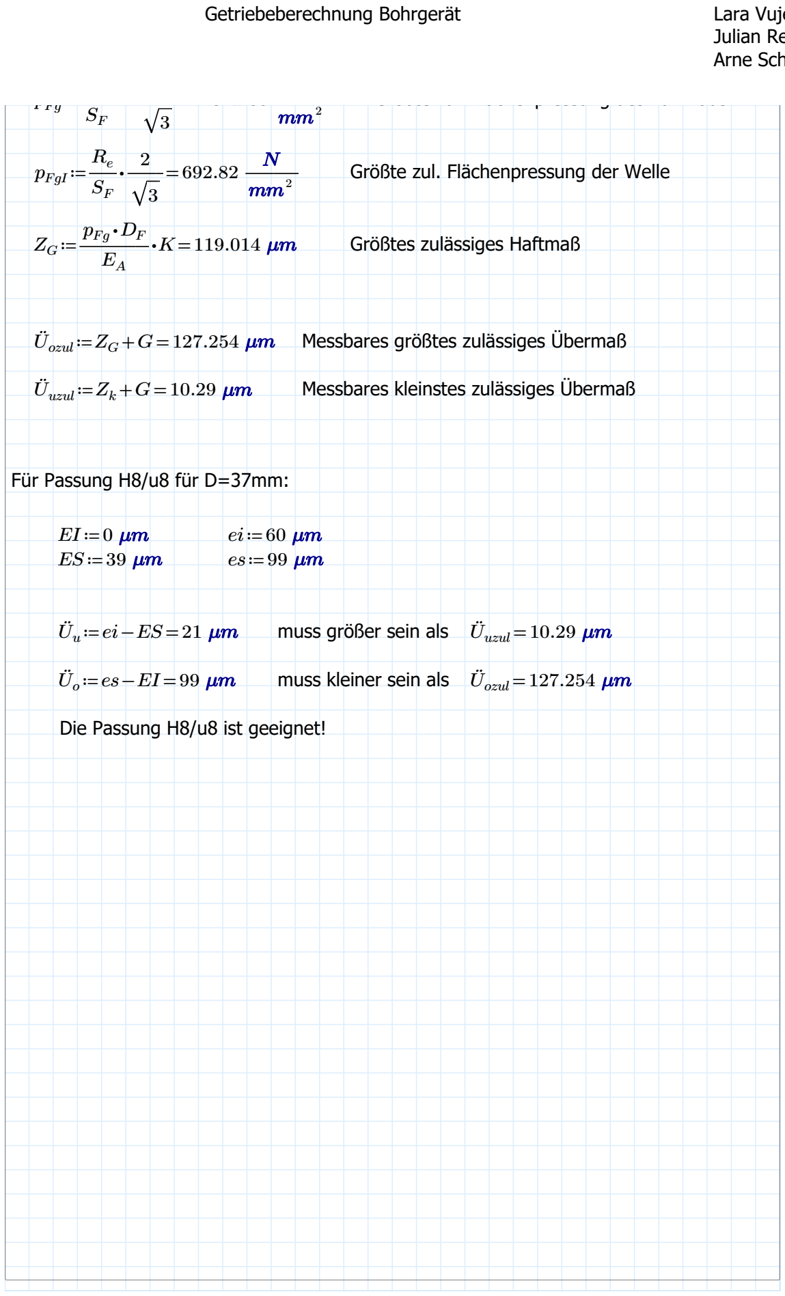
[picture p41: figure]
mm²; pFgI≔―⋅; 692.82 ―N―mm²; Größte zul. Flächenpressung der Welle; pFg ⋅ DF EA; Größtes zulässiges Haftmaß; Üozul≔ZG +G=127.254 μm; Messbares größtes zulässiges Übermaß; Üuzul≔Zk+G=10.29 μm; Messbares kleinstes zulässiges Übermaß; Für Passung H8/u8 für D=37mm:; muss größer sein als; Üuzul=10.29 μm; muss kleiner sein als; Üozul=127.254 μm; Die Passung H8/u8 ist geeignet!

11.04.2022 Seite 30 von 32

Schmierstoffberechnung

Für Auslegung eines Schmierstoffes für das Getriebe muss zuerst die benötigte kinematische Nennviskosität des Schmieröles bestimmt werden. Diese erhalten wir über TB 20-7 a) mit Hilfe des Kraft-Geschwindigkeits-Faktors ―. Es wird die Umfangsgeschwindigkeit und Durchmesser von ks v

Zahnrad 4 gewählt.

u≔―

z4 z3 | nAbtrieb≔――― nAntrieb i'Gesamt
ks≔ | ⋅ | =

⎛
⎜
⎝

3 ⋅――⋅

FtZ4
b | ⋅ 4 | d4

―u+―1
u

⎞
⎟
⎠

――1――― π⋅d ⋅ 4 nAbtrieb
1.429 ―⋅

s
m

MPa
υ
Durch das Ablesen von TB 20-7 a) ergibt sich ca. ein Wert von: | ν40≔2.3 ⋅ 10 | ⋅

2 ―mm―

2
s

Gewähltes Schmieröl:
DIN 51517 - CLP 220: Umlaufschmieröl auf Basis eines Mineralöls (C) mit Zusatzstoffen für erhöhten Korrosionsschutz, Alterungsbeständigkeit (L), sowie Herabsetzung der Reibung und des

11.04.2022 Seite 31 von 32

Verschleißes (P).
Geeignet für kinematische Viskositäten von | ν | ≔ | - ISO VG 220 (220). 40 | 198‥.242 ―mm―

2
s

11.04.2022 Seite 32 von 32
