JulianRe24/ME3-Entwurf/Unterlagen/Entwurfsskizze-1-cropped.pdf

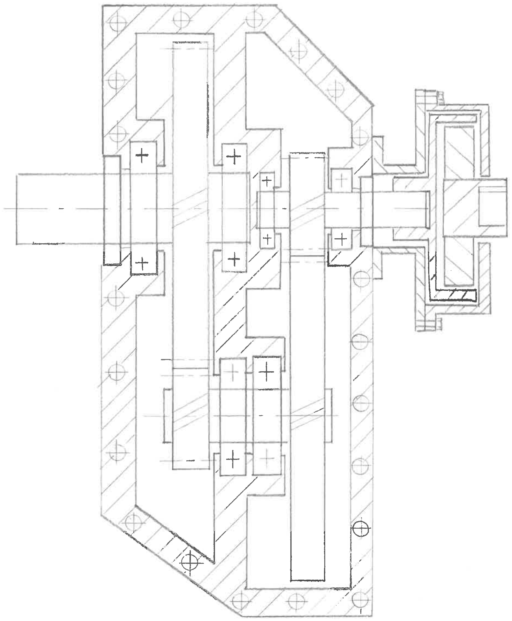
[picture p49: page 1]
