JulianRe24/ME3-Entwurf/Unterlagen/Entwurfsskizze-1.pdf

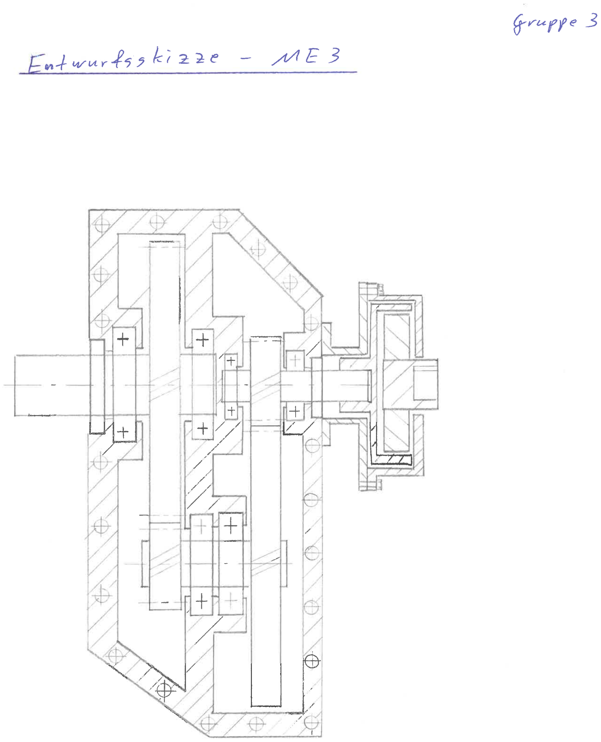
[picture p50: page 1]
