JulianRe24/ME3-Entwurf/Unterlagen/Prinzipskizze-1.jpg

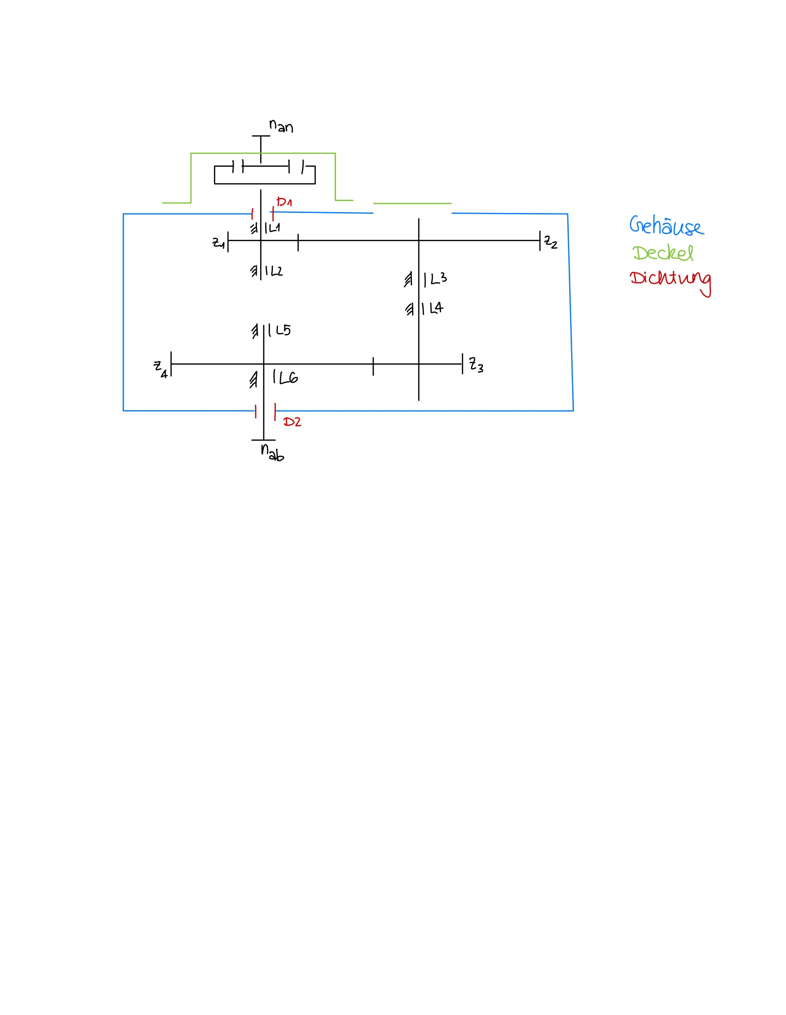
Unterlagen/Prinzipskizze-1.jpg
