JulianRe24/ME3-Entwurf/Zeichnungen/Zeichnungsvorlagen/Stueckliste-Vorlage-A4.xls

1 |  | 2 | 3 | 4 |  |  |  |  | 5 | 6
Pos. |  | Menge | Einheit | Benennung |  |  |  |  | Sachnummer/Norm - Kurzbezeichnung | Bemerkung
1
2
3
4
5
6
7
8
9
10
11
12
13
14
15
16
17
18
19
20
21
22
23
24
25
26
27
 |  |  |  |  |  |  | Datum | Name
 |  |  |  |  |  | Bearb. | 2020-04-06
 |  |  |  |  |  | Gepr.
 |  |  |  |  |  | Norm.
 |  |  |  |  |  |  |  |  |  |  | Blatt
 |  |  |  |  |  |  |  |  |  |  | 1
 |  |  |  |  |  |  |  |  |  |  | 1 Bl.
Zust. | Änderung |  |  | Datum | Name
