JulianRe24/ME3-Entwurf/(list of files, cad)

Other CAD files:
CAD/Abtriebswelle.CATPart
CAD/AbtriebswelleZsmBau.CATProduct
CAD/Antriebswelle.CATPart
CAD/AntriebswelleZsmBau.CATProduct
CAD/Fliehkraftkupplung/129055212-216-07330-401750/07330-401750.CATPart
CAD/Fliehkraftkupplung/FK-Kupplung.CATPart
CAD/Fliehkraftkupplung/FK_Abstandsscheibe.CATPart
CAD/Fliehkraftkupplung/FK_Adapterflansch.CATPart
CAD/Fliehkraftkupplung/FK_Antriebsseite.CATPart
CAD/Fliehkraftkupplung/FK_Deckel.CATPart
CAD/Fliehkraftkupplung/FK_Fliehkoerper.CATPart
CAD/Fliehkraftkupplung/FK_Reibkoerper.CATPart
CAD/Fliehkraftkupplung/Fliehkraftkupplung.CATProduct
CAD/Fliehkraftkupplung/Fliehkraftkupplung_Feder.CATPart
CAD/Fliehkraftkupplung/Glocke.CATPart
CAD/Gehäuse/Gehause 1.CATPart
CAD/Gehäuse/Gehause 2.CATPart
CAD/Gehäuse/GehauseZsmBau.CATProduct
CAD/Gehäuse/Schauglasdeckel.CATPart
CAD/Gesamtgetriebe.CATProduct
CAD/Getriebemechanik.CATProduct
CAD/Lager/6206 Antriebswelle/ball_bearing_6205-2z_va228_2.CATProduct
CAD/Lager/6206 Antriebswelle/ball_bearing_6205-2z_va228_2_01.CATPart
CAD/Lager/6206 Antriebswelle/ball_bearing_6205-2z_va228_2_02.CATPart
CAD/Lager/6206 Antriebswelle/ball_bearing_6205-2z_va228_2_03.CATPart
CAD/Lager/6206 Antriebswelle/ball_bearing_6205-2z_va228_2_04.CATPart
CAD/Lager/6206 Antriebswelle/ball_bearing_6205-2z_va228_2_05.CATPart
CAD/Lager/6206 Antriebswelle/snr_nup208eg15_0.CATProduct
CAD/Lager/6206 Antriebswelle/snr_nup208eg15_0_01.CATPart
CAD/Lager/6206 Antriebswelle/snr_nup208eg15_0_02.CATPart
CAD/Lager/NU208 Abtrieb/nu210e_m1.CATProduct
CAD/Lager/NU208 Abtrieb/nu210e_m1_01.CATPart
CAD/Lager/NU208 Abtrieb/nu210e_m1_02.CATPart
CAD/Lager/NU208 Abtrieb/nu210e_m1_03.CATPart
CAD/Lager/NU208 Abtrieb/nu210e_m1_04.CATPart
CAD/Lager/NU208 Abtrieb/nu210e_m1_05.CATPart
CAD/Lager/NU208 Abtrieb/nu210e_m1_06.CATPart
CAD/Lager/NU208 Abtrieb/nu210e_m1_07.CATPart
CAD/Lager/NU208 Abtrieb/nu210e_m1_08.CATPart
CAD/Lager/NU208 Abtrieb/nu210e_m1_09.CATPart
CAD/Lager/NU208 Abtrieb/nu210e_m1_10.CATPart
CAD/Lager/NU208 Abtrieb/nu210e_m1_11.CATPart
CAD/Lager/NU208 Abtrieb/nu210e_m1_12.CATPart
CAD/Lager/NU208 Abtrieb/nu210e_m1_13.CATPart
CAD/Lager/NU208 Abtrieb/nu210e_m1_14.CATPart
CAD/Lager/NU208 Abtrieb/nu210e_m1_15.CATPart
CAD/Lager/NU208 Abtrieb/nu210e_m1_16.CATPart
CAD/Lager/NU208 Abtrieb/nu210e_m1_17.CATPart
CAD/Lager/NU208 Abtrieb/nu210e_m1_18.CATPart
CAD/Lager/Rillenkugellager 20mm/6004.CATProduct
CAD/Lager/Rillenkugellager 20mm/6004_01.CATPart
CAD/Lager/Rillenkugellager 20mm/6004_02.CATPart
CAD/Lager/Rillenkugellager 20mm/6004_03.CATPart
CAD/Lager/Rillenkugellager 20mm/6004_04.CATPart
CAD/Lager/Rillenkugellager 20mm/6004_05.CATPart
CAD/Lager/Rillenkugellager 20mm/6004_06.CATPart
CAD/Lager/Rillenkugellager 20mm/6004_07.CATPart
CAD/Lager/Rillenkugellager 20mm/6004_08.CATPart
CAD/Lager/Rillenkugellager 20mm/6004_09.CATPart
CAD/Lager/Rillenkugellager 20mm/6004_10.CATPart
CAD/Lager/Rillenkugellager 20mm/6004_11.CATPart
CAD/Lager/Rillenkugellager 40mm/6008.CATProduct
CAD/Lager/Rillenkugellager 40mm/6008_01.CATPart
CAD/Lager/Rillenkugellager 40mm/6008_02.CATPart
CAD/Lager/Rillenkugellager 40mm/6008_03.CATPart
CAD/Lager/Rillenkugellager 40mm/6008_04.CATPart
CAD/Lager/Rillenkugellager 40mm/6008_05.CATPart
CAD/Lager/Rillenkugellager 40mm/6008_06.CATPart
CAD/Lager/Rillenkugellager 40mm/6008_07.CATPart
CAD/Lager/Rillenkugellager 40mm/6008_08.CATPart
CAD/Lager/Rillenkugellager 40mm/6008_09.CATPart
CAD/Lager/Rillenkugellager 40mm/6008_10.CATPart
CAD/Lager/Rillenkugellager 40mm/6008_11.CATPart
CAD/Lager/Rillenkugellager 40mm/6008_12.CATPart
CAD/Lager/Rillenkugellager 40mm/6008_13.CATPart
CAD/Lager/Rillenkugellager 40mm/6008_14.CATPart
CAD/Lager/Rillenkugellager 50mm/6010.CATProduct
CAD/Lager/Rillenkugellager 50mm/6010_01.CATPart
CAD/Lager/Rillenkugellager 50mm/6010_02.CATPart
CAD/Lager/Rillenkugellager 50mm/6010_03.CATPart
CAD/Lager/Rillenkugellager 50mm/6010_04.CATPart
CAD/Lager/Rillenkugellager 50mm/6010_05.CATPart
CAD/Lager/Rillenkugellager 50mm/6010_06.CATPart
CAD/Lager/Rillenkugellager 50mm/6010_07.CATPart
CAD/Lager/Rillenkugellager 50mm/6010_08.CATPart
CAD/Lager/Rillenkugellager 50mm/6010_09.CATPart
CAD/Lager/Rillenkugellager 50mm/6010_10.CATPart
CAD/Lager/Rillenkugellager 50mm/6010_11.CATPart
CAD/Lager/Rillenkugellager 50mm/6010_12.CATPart
CAD/Lager/Rillenkugellager 50mm/6010_13.CATPart
CAD/Lager/Rillenkugellager 50mm/6010_14.CATPart
CAD/Lager/Rillenkugellager 50mm/6010_15.CATPart
CAD/Lager/Rillenkugellager 50mm/6010_16.CATPart
CAD/Lager/Rillenkugellager 60mm/6012.CATProduct
CAD/Lager/Rillenkugellager 60mm/6012_01.CATPart
CAD/Lager/Rillenkugellager 60mm/6012_02.CATPart
CAD/Lager/Rillenkugellager 60mm/6012_03.CATPart
CAD/Lager/Rillenkugellager 60mm/6012_04.CATPart
CAD/Lager/Rillenkugellager 60mm/6012_05.CATPart
CAD/Lager/Rillenkugellager 60mm/6012_06.CATPart
CAD/Lager/Rillenkugellager 60mm/6012_07.CATPart
CAD/Lager/Rillenkugellager 60mm/6012_08.CATPart
CAD/Lager/Rillenkugellager 60mm/6012_09.CATPart
CAD/Lager/Rillenkugellager 60mm/6012_10.CATPart
CAD/Lager/Rillenkugellager 60mm/6012_11.CATPart
CAD/Lager/Rillenkugellager 60mm/6012_12.CATPart
CAD/Lager/Rillenkugellager 60mm/6012_13.CATPart
CAD/Lager/Rillenkugellager 60mm/6012_14.CATPart
CAD/Lager/Rillenkugellager 60mm/6012_15.CATPart
CAD/Lager/Rillenkugellager 60mm/6012_16.CATPart
CAD/Lager/Zylinderrollenlager NU/nu208e_tvp2.CATProduct
CAD/Lager/Zylinderrollenlager NU/nu208e_tvp2_01.CATPart
CAD/Lager/Zylinderrollenlager NU/nu208e_tvp2_02.CATPart
CAD/Lager/Zylinderrollenlager NU/nu208e_tvp2_03.CATPart
CAD/Lager/Zylinderrollenlager NU/nu208e_tvp2_04.CATPart
CAD/Lager/Zylinderrollenlager NU/nu208e_tvp2_05.CATPart
CAD/Lager/Zylinderrollenlager NU/nu208e_tvp2_06.CATPart
CAD/Lager/Zylinderrollenlager NU/nu208e_tvp2_07.CATPart
CAD/Lager/Zylinderrollenlager NU/nu208e_tvp2_08.CATPart
CAD/Lager/Zylinderrollenlager NU/nu208e_tvp2_09.CATPart
CAD/Lager/Zylinderrollenlager NU/nu208e_tvp2_10.CATPart
CAD/Lager/Zylinderrollenlager NU/nu208e_tvp2_11.CATPart
CAD/Lager/Zylinderrollenlager NU/nu208e_tvp2_12.CATPart
CAD/Lager/Zylinderrollenlager NU/nu208e_tvp2_13.CATPart
CAD/Lager/Zylinderrollenlager NU/nu208e_tvp2_14.CATPart
CAD/Lager/Zylinderrollenlager NU/nu208e_tvp2_15.CATPart
CAD/Lager/Zylinderrollenlager NU/nu208e_tvp2_16.CATPart
CAD/Lager/Zylinderrollenlager NUP/snr_nup208eg15_0.CATProduct
CAD/Lager/Zylinderrollenlager NUP/snr_nup208eg15_0_01.CATPart
CAD/Lager/Zylinderrollenlager NUP/snr_nup208eg15_0_02.CATPart
CAD/Lager/Zylinderrollenlager NUP/snr_nup208eg15_0_03.CATPart
CAD/Lager/Zylinderrollenlager NUP/snr_nup208eg15_0_04.CATPart
CAD/Lager/breites Rillenkugellager/62205.CATProduct
CAD/Lager/breites Rillenkugellager/62205_01.CATPart
CAD/Lager/breites Rillenkugellager/62205_02.CATPart
CAD/Lager/breites Rillenkugellager/62205_03.CATPart
CAD/Lager/breites Rillenkugellager/62205_04.CATPart
CAD/Lager/breites Rillenkugellager/62205_05.CATPart
CAD/Lager/breites Rillenkugellager/62205_06.CATPart
CAD/Lager/breites Rillenkugellager/62205_07.CATPart
CAD/Lager/breites Rillenkugellager/62205_08.CATPart
CAD/Lager/breites Rillenkugellager/62205_09.CATPart
CAD/Lager/breites Rillenkugellager/62205_10.CATPart
CAD/Lager/breites Rillenkugellager/62205_11.CATPart
CAD/Lager/schmales Rillenkugellager/bearing_16004.CATProduct
CAD/Lager/schmales Rillenkugellager/bearing_16004_01.CATPart
CAD/Lager/schmales Rillenkugellager/bearing_16004_02.CATPart
CAD/Lager/schmales Rillenkugellager/bearing_16004_03.CATPart
CAD/Normteile/129156503-216-din910-g3_4ax12-st/din910-g3_4ax12-st.CATPart
CAD/Normteile/129157842-216-schraube_iso_4762-m5x8-10_9/schraube_iso_4762-m5x8-10_9.CATPart
CAD/Normteile/129160496-216-schraube_iso_4762-m8x20-10_9/schraube_iso_4762-m8x20-10_9.CATPart
CAD/Normteile/129160563-216-schraube_iso_4762-m5x8-10_9/schraube_iso_4762-m5x8-10_9.CATPart
CAD/Normteile/129160581-216-schraube_iso_4017-m6x12-10_9/schraube_iso_4017-m6x12-10_9.CATPart
CAD/Normteile/129220237-216-din3760-a_25x40x7-fkm/din3760-a_25x40x7-fkm.CATPart
CAD/Normteile/129220248-216-din3760-a_50x72x8-fkm/din3760-a_50x72x8-fkm.CATPart
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
