JulianRe24/ME3-Entwurf/Unterlagen/Testat_1_Maschinenelemte_3E_Gruppe_4.pdf

Maschinenelemente 3 Entwurf Jade Hochschule Wilhelmshaven

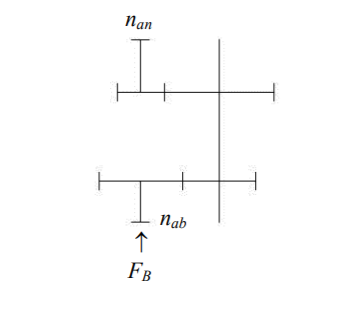
[picture p56: figure]

Claas Lübbers, Niklas Hollmann, Lars Stanislawski

2-stufiges schrägverzahntes koaxiales Getriebe

Abgabe Testat 1 Gruppe 4 – 03.12.2021

Prof. Dr. Lindner

### Inhaltsverzeichnis

1.0 Anforderungsliste

2.0 Skizzen

2.1 Prinzip-Skizze

2.2 Entwurf-Skizze

3.0 Berechnungen

3.1 Übersetzungsverhältnis

3.2 Profilverschiebung

3.3 Zusammenfassung der Parameter der Zahnräder

3.4 Welle-Nabe-Verbindung - Passfeder

### Anforderungsliste 2-stufiges schrägverzahntes koaxiales Getriebe

Eingangsparameter

- | Antrieb | Tan = 50 [Nm]
- | Abtrieb | Tab = 500 [Nm]
- | Schaltdreh. | ns = 1400 [min^-1]
- | Antrieb | nan = 2000 [min^-1]
- | Abtrieb | FB = 3 [kN]

Anforderungen

- Zweiteiliges Getriebegehäuse zur einfachen Montage & Wartung sowie einer möglichst wirtschaftlichen Fertigung z.B. als Gussteil
- Koaxiale Bauweise mit Vorgelegewelle
- Getriebegehäuse mit Ölablassschraube für Ölwechsel bei Wartung und/oder Inspektion
- Schrägverzahnung der Stirnräder für einen ruhigen Lauf (β=20°)
- Fliehkraftkupplung zum Schutz des Motors (Lastfreier Anlauf), die Schaltdrehzahl liegt bei ca. 1400min^-1
- Ölschmierung des Getriebes mit zugehörigen Wellendichtringen etc.
- Die Standzeit der Wälzlager soll mindestens L10>10000h sein
- Erreichung der Zielparameter (Drehmoment Abtrieb etc.) mit einer maximalen Abweichung von 0,5% über dem geforderten Soll-Wert
- Dauerfest SD>1,5 für alle Wellen an je einer Schwachstelle
- Möglichst Verwendung von Kauf-/Normteilen

Zusätzliche Wünsche für die Konstruktion

- Eine gut zugängliche Wartungsklappe um möglichst Bedienerfreundlich zu sein
- Kompakte & vertikale Bauweise bei hoher Leistungsdichte (bei niedrigem Gewicht z.B. Aluminiumguss)
- Möglichst lange Standzeit bei Belastung der Ausgangswelle durch Bohrvorgang mit max. 3kN
- Beständig gegenüber äußeren Einflüssen wie Staub & Korrosion

Prinzip-Skizze

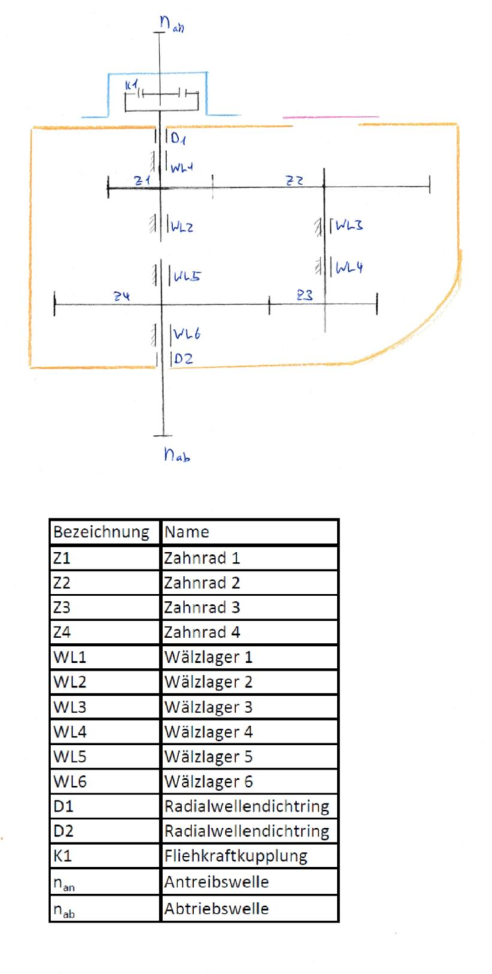
[picture p57: figure]

Entwurf-Skizze

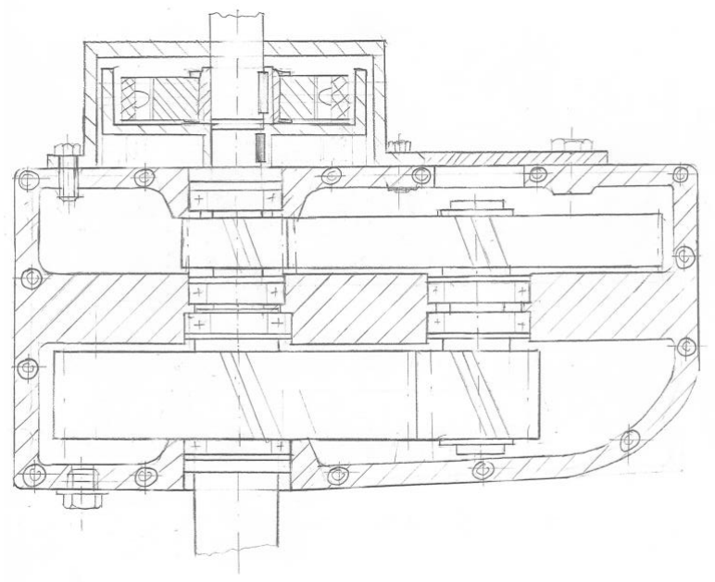
[picture p58: figure]

Maschinenelemte 3 Entwurf

### 2-stufiges schrägverzahntes koaxiales Getriebe

Alle im Folgenden auftretenden Angaben zu Seitenzahlen, Tabellen und Gleichungen beziehen sich auf "Roloff/Matek Maschinenelemente (24. Auflage)"

Konstanten per Vorgabe

Drehmoment Antrieb | Tan≔50 N ⋅m
Drehmoment Abtrieb | Tab≔500 N ⋅m
Antriebsdrehzahl | nan≔2000 | min ⁻¹
axiale Abtriebskraft | FB≔3 kN
Anwendungsfaktor | KA≔2
Verzahnungsschrägungswinkel | β≔20 °
Normaleingriffswinkel | αn≔20 | °

Dauerfestigkeitsschubspannung von
42CrMo4 (Wellenstahl)

τtzul≔50 ―N―mm²

Überschlägiger Belastungswert | Bzul≔4 | ―N―mm²

theoretisches Übersetzungsverhältnis

iges≔――=

Tab

Tan

### 10 i12≔3.4

i23≔――=

iges

i12

2.941 iges≔i12 ⋅i23=10
gewählt nach TB21-11

Ritzelzähnezahlen

z1≔21 | z2≔z1
⋅i12=71.4 | z2≔71 | orientiert an TB21-12
z3≔28 | z4≔z3
⋅i23=82 | z4≔83 | Da ggT>1 wurde die
Ritzelzähnezahl um +1
erhöht
wirkliches Übersetzungsverhältnis

i12≔―=

z2
z1

3.381 i23≔―=

z4
z3

2.964 iges≔i12 ⋅i23=10.022

Tab≔Tan ⋅iges=501.105 N ⋅m

――――=

500 ⋅N ⋅m

Tab

0.998 Abweichung von 0,2% vom geforderten Abtriebsdrehmoment

Claas Lübbers, Niklas Hollmann, Lars Stanislawski | Seite 1 von 7

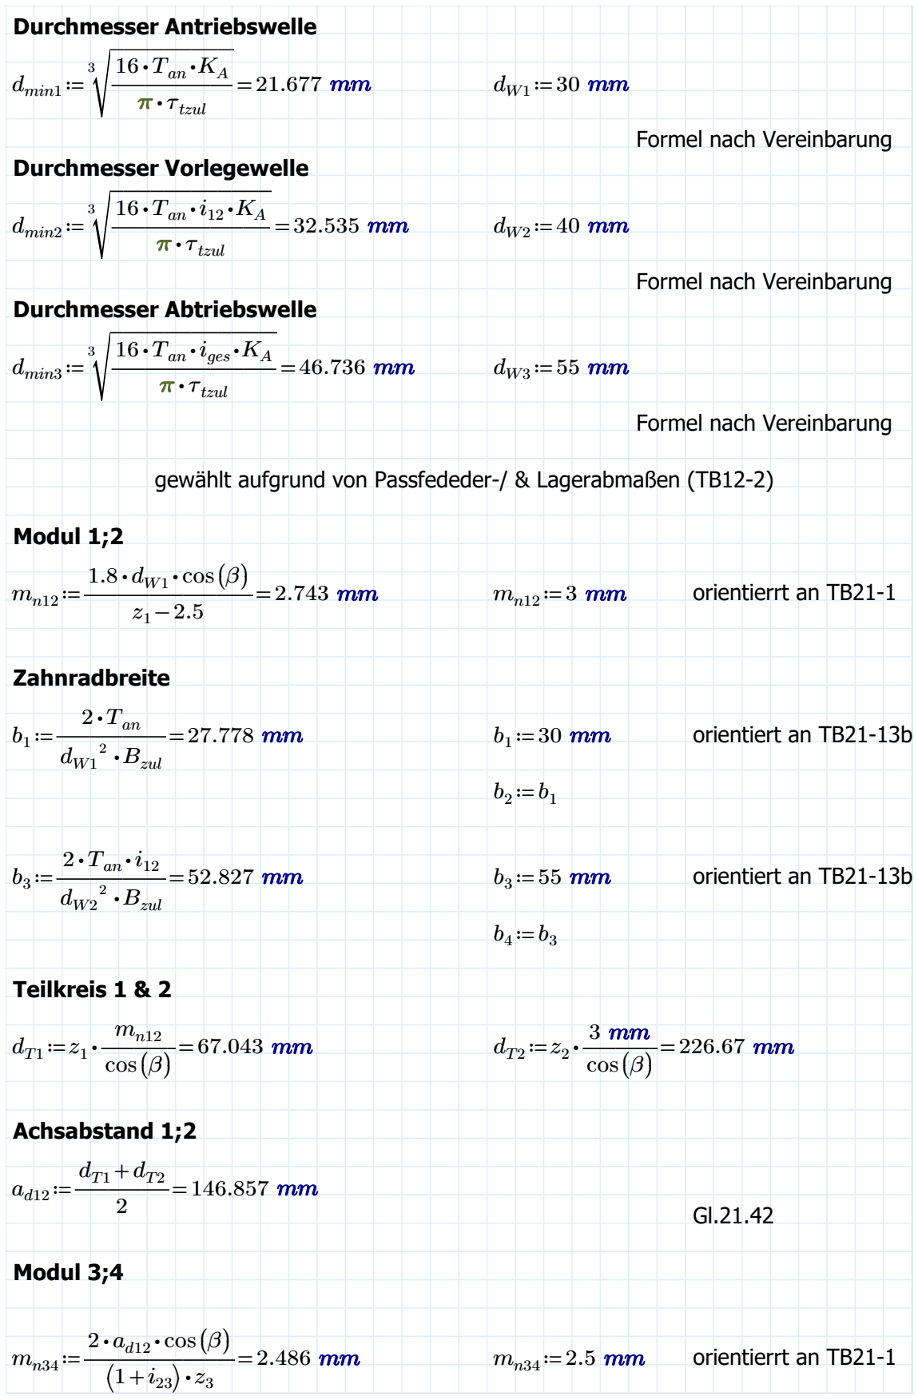
[picture p59: figure]
Durchmesser Antriebswelle; dmin1≔; π⋅τtzul; Formel nach Vereinbarung; Durchmesser Vorlegewelle; dmin2≔; Durchmesser Abtriebswelle; dmin3≔; ⋅ an iges; Modul 1;2; 1.8 ⋅dW1 ⋅ cos ((β)) z1-2.5; orientierrt an TB21-1; Zahnradbreite; 2 ⋅Tan dW1 ⋅; 2 Bzul; orientiert an TB21-13b; Teilkreis 1 & 2; mn12 cos ((β)); 3 mm cos ((β)); Achsabstand 1;2; Modul 3;4; ⋅ d12 cos ((β))

gewählt aufgrund von Passfededer-/ & Lagerabmaßen (TB12-2)

Claas Lübbers, Niklas Hollmann, Lars Stanislawski | Seite 2 von 7

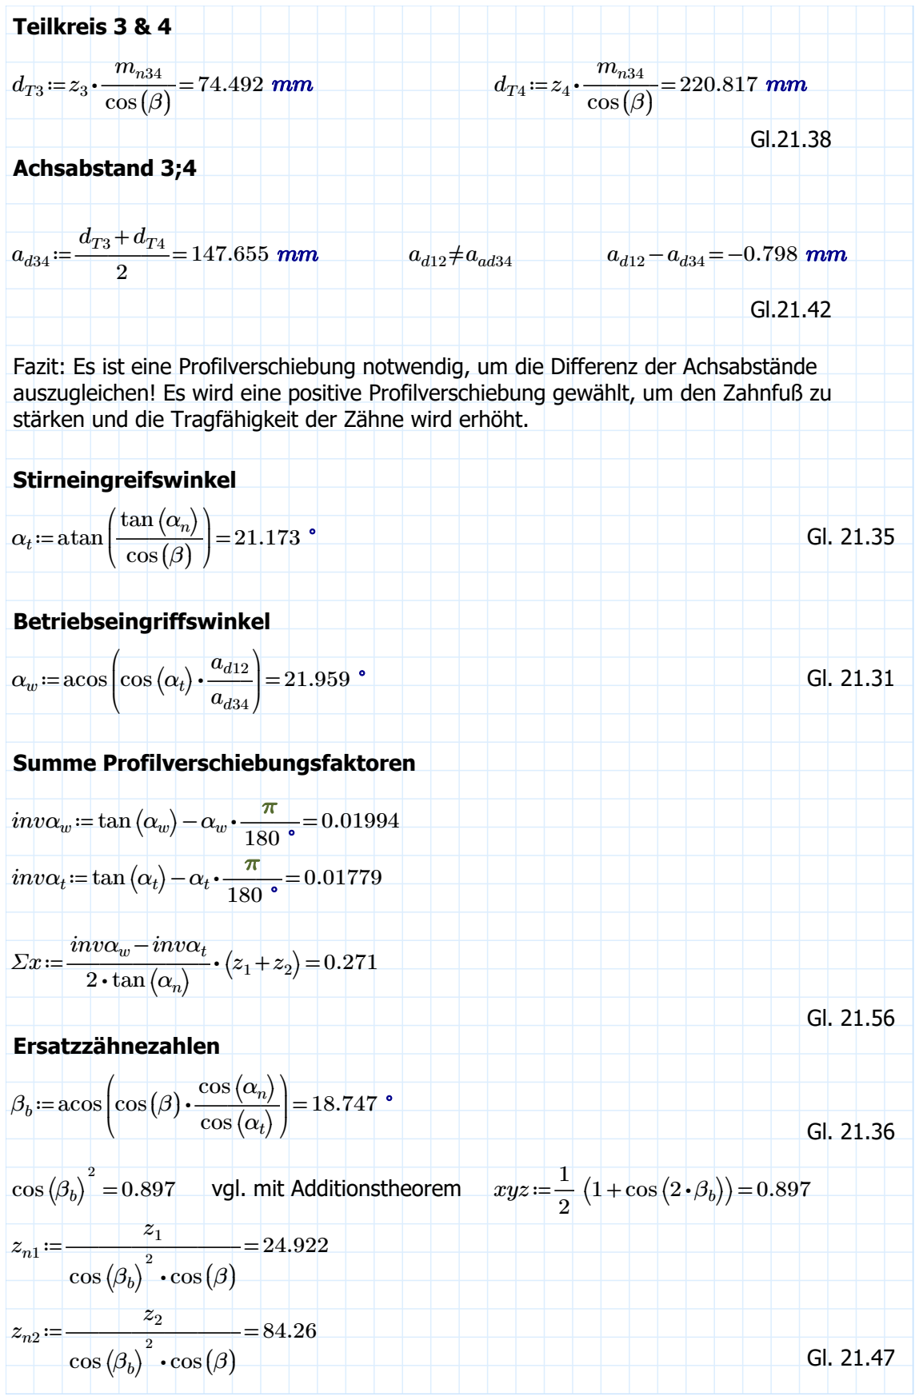
[picture p60: figure]
Teilkreis 3 & 4; mn34 cos ((β)); Achsabstand 3;4; ad12≠aad34; Stirneingreifswinkel; αt≔atan; tan⎛⎝αn; ⎞ ⎠ cos ((β)); Betriebseingriffswinkel; αw≔acos; cos ⎛; Summe Profilverschiebungsfaktoren; invαw≔tan⎛⎝αw; invαt≔tan⎛⎝αt; invαw -invαt 2 ⋅ tan⎛⎝αn; Ersatzzähnezahlen; βb≔acos; cos ((β)) ⋅―――; cos ⎛⎝αn; cos ⎛⎝αt; cos ⎛⎝βb; vgl. mit Additionstheorem; xyz≔―; ⎛⎝1+cos ⎛⎝2 ⋅βb; cos ((β))

Fazit: Es ist eine Profilverschiebung notwendig, um die Differenz der Achsabstände auszugleichen! Es wird eine positive Profilverschiebung gewählt, um den Zahnfuß zu stärken und die Tragfähigkeit der Zähne wird erhöht.

Claas Lübbers, Niklas Hollmann, Lars Stanislawski | Seite 3 von 7

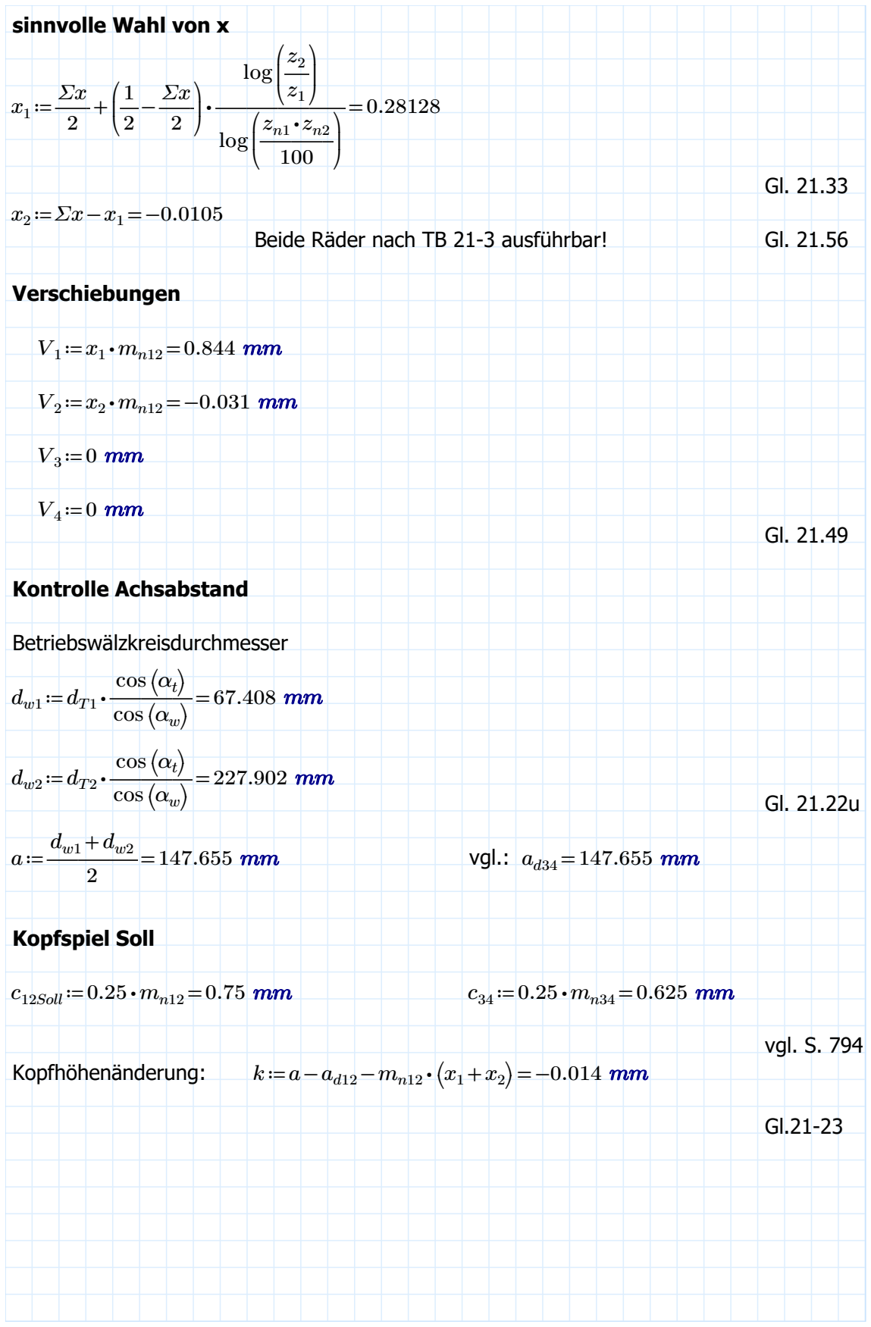
[picture p61: figure]
sinnvolle Wahl von x; log; Verschiebungen; Kontrolle Achsabstand; Betriebswälzkreisdurchmesser; cos ⎛⎝αt; ⎞ ⎠ cos ⎛⎝αw; vgl.:; Kopfspiel Soll; c12Soll≔0.25 ⋅mn12=0.75; vgl. S. 794; Kopfhöhenänderung:

Beide Räder nach TB 21-3 ausführbar! | Gl. 21.56
Claas Lübbers, Niklas Hollmann, Lars Stanislawski | Seite 4 von 7

Zahnräder

Zahnrad Nr.1:

dT1=67.043 mm

Betriebswälzkreisdurchmesser | dw1≔―――⋅ | =

2 ⋅ z1
z1+z2
a | 67.408 | mm | Gl.21-22a
Grundkreisdurchmesser | db1≔z1
⋅―――――=

m ⋅ n12 cos ⎛⎝αt

⎞
⎠
cos ((β))
62.517 mm | Gl.21-39
Kopfkreisdurchmesser | da1≔dT1+2 ⋅ ⎛⎝mn12+V1+k⎞
⎠=74.702 mm | Gl.21-24
Fußkreisdurchmesser | df1≔dT1-2 ⋅ ⎛⎝

⎛⎝mn12+c12Soll⎞
⎠-V1

⎞
⎠=61.231 mm Gl.21-25

Zahnrad Nr.2:

dT2=226.67 mm

dw2≔―――⋅ =

2 ⋅ z2
z1+z2
a | 227.902 mm | Gl.21-22b

db2≔z2

⋅―――――=

m | ⋅ n12 | cos ⎛⎝αt

⎞
⎠
cos ((β))
211.369 | mm | Gl.21-39

da2≔dT2+2 ⋅ ⎛⎝mn12+V2+k⎞
⎠=232.578 | mm | Gl.21-24

df2≔dT2-2 ⋅ ⎛⎝

⎛⎝mn12+c12Soll⎞
⎠-V2

⎞
⎠=219.107 | mm | Gl.21-25

Zahnrad Nr.3:

dT3=74.492 mm

dw3≔―――⋅ =

2 ⋅ z3
z3+z4
a | 74.492 | mm | Gl.21-22a

db3≔z3

⋅―――――=

m | ⋅ n34 | cos ⎛⎝αt

⎞
⎠
cos ((β))
69.464 mm | Gl.21-39

da3≔dT3+2 ⋅ ⎛⎝mn34+V2+k⎞
⎠=79.401 mm | Gl.21-40
df3≔dT3-2.5 ⋅mn34=68.242 mm | Gl.21-41
Claas Lübbers, Niklas Hollmann, Lars Stanislawski | Seite 5 von 7

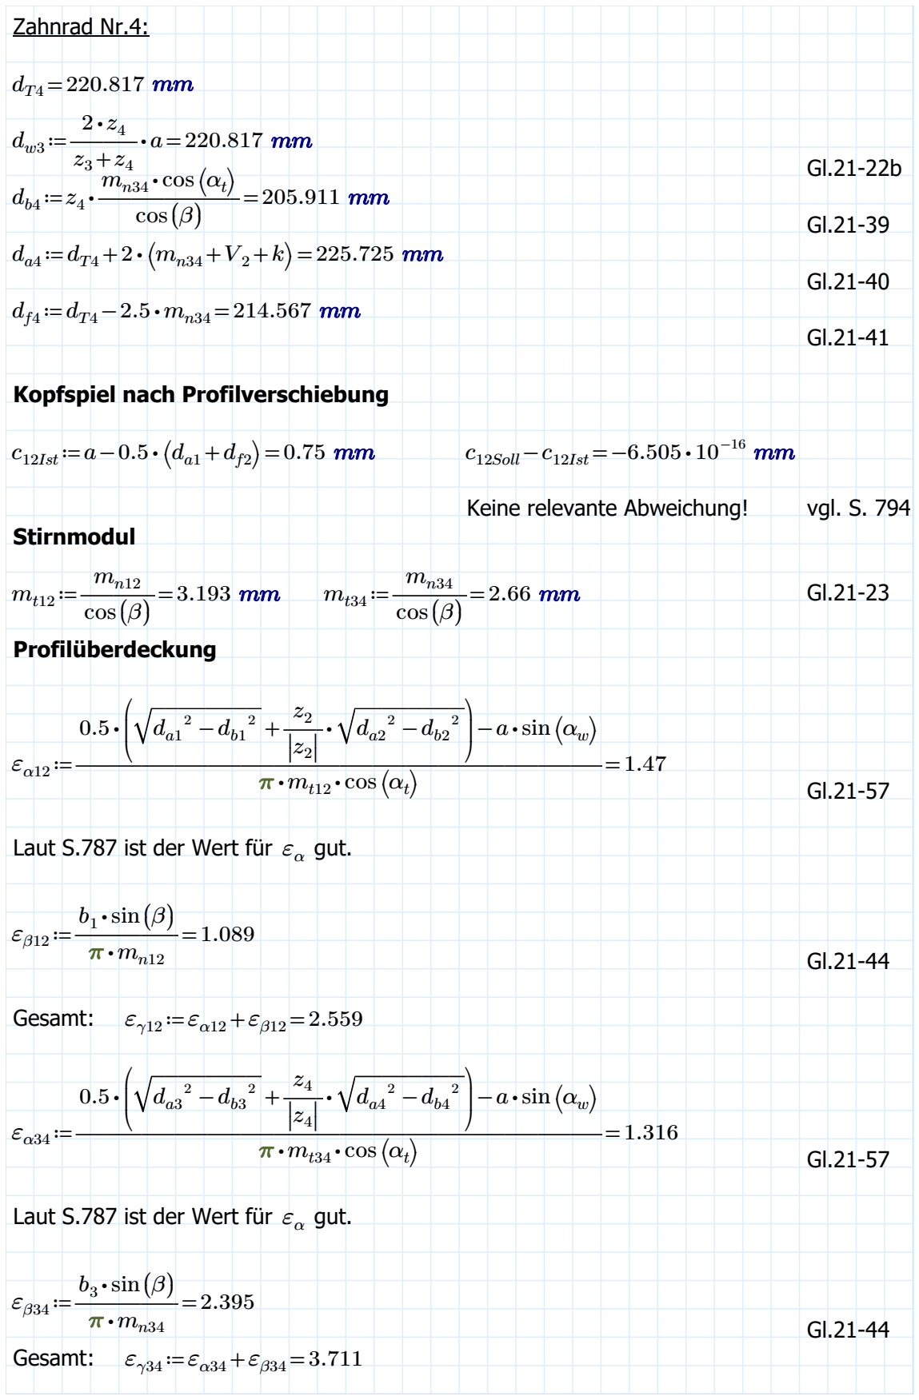
[picture p62: figure]
Zahnrad Nr.4:; cos ⎛⎝αt; cos ((β)); Kopfspiel nach Profilverschiebung; c12Ist≔a-0.5 ⋅ ⎛⎝da1+df2⎞; c12Soll-c12Ist=-6.505 ⋅ 10⁻¹⁶ mm; Keine relevante Abweichung!; vgl. S. 794; Stirnmodul; mn12 cos ((β)); mn34 cos ((β)); Profilüberdeckung; a⋅ sin⎛⎝αw; Laut S.787 ist der Wert für ε gut. α; ⋅ 1 sin((β)); Gesamt:; ⋅ 3 sin((β))

Claas Lübbers, Niklas Hollmann, Lars Stanislawski | Seite 6 von 7

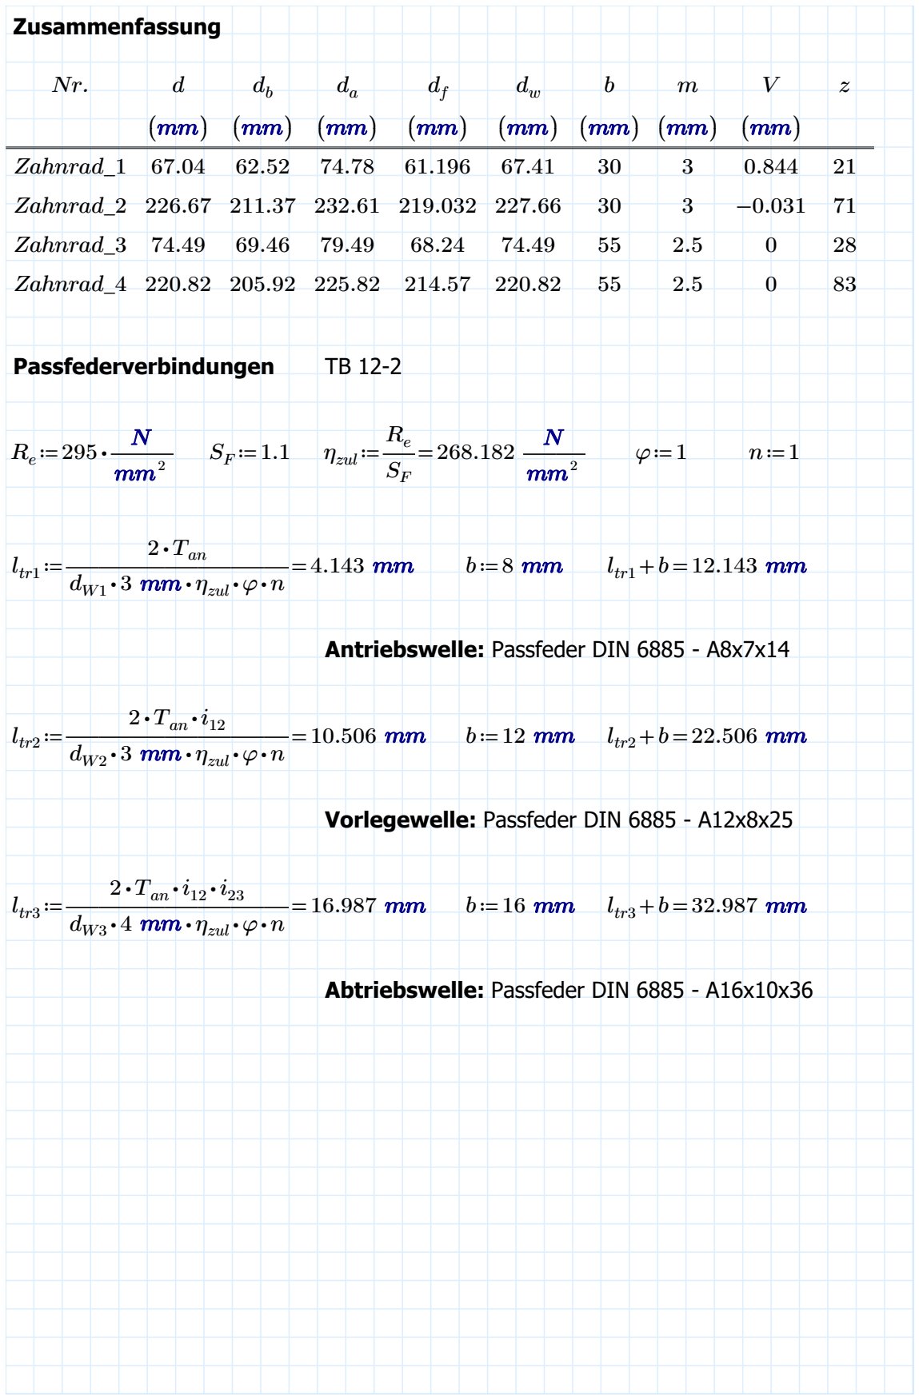
[picture p63: figure]
Zusammenfassung; Zahnrad_1; Zahnrad_2; Zahnrad_3; Zahnrad_4; Passfederverbindungen; Re≔295 ⋅―N―mm²; ηzul≔―=; 268.182 ―N―mm²; 2 ⋅Tan; ⋅ zul

Antriebswelle: Passfeder DIN 6885 - A8x7x14

Vorlegewelle: Passfeder DIN 6885 - A12x8x25

Abtriebswelle: Passfeder DIN 6885 - A16x10x36

Claas Lübbers, Niklas Hollmann, Lars Stanislawski | Seite 7 von 7
