JulianRe24/ME3-Entwurf/Zeichnungen/02_Hauptansichten.pdf

Maßstab 1:5; Gruppe 3; Zust; Änderung; Datum; Nam. Urspr.; ISO 2768-m; Öleinlass: DIN 910 G 3/4"; Ölablass: DIN 910 G 3/4"; Einstellbare Klemmnabe

Passfedernut für 25 mm-Welle
mit Passfeder A 8x7x25

Name
2-stufiges schrägverzahntes
koaxiales Getriebe
Hauptansichten
Lara Vujevic, Julian Reimann,
Arne Schlemermeyer
