JulianRe24/ME3-Entwurf/Unterlagen/Momentenverläufe.pdf

## MomentenVerlauf Antriebswelle

✓„

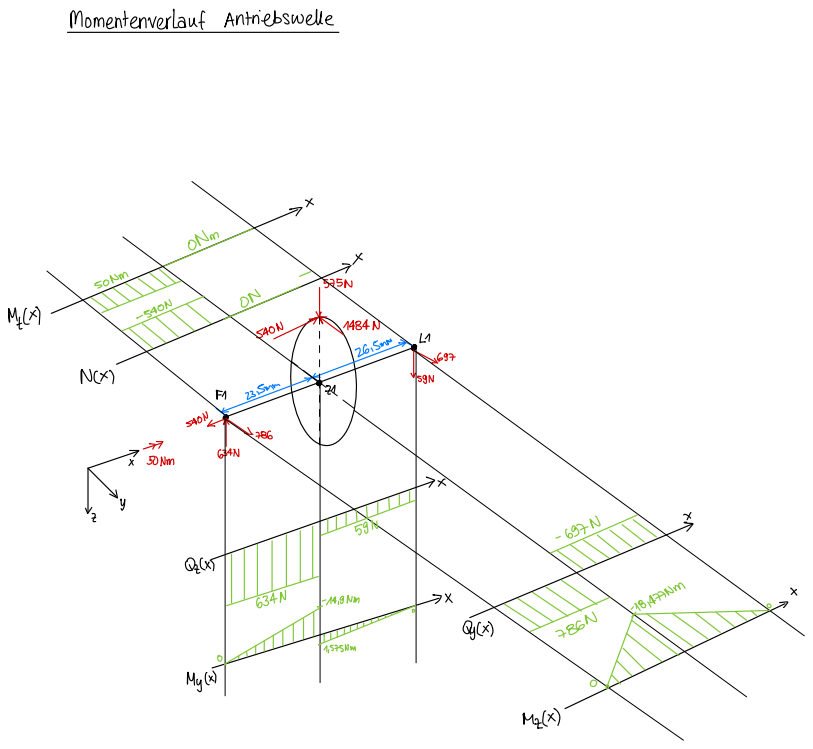
[picture p64: page 1]
ggf 50DM; SION ""; NCX); Qzlx); ÄHM; Mzfx)

# MomentenVerlauf VorgelegeWelle

-1652N

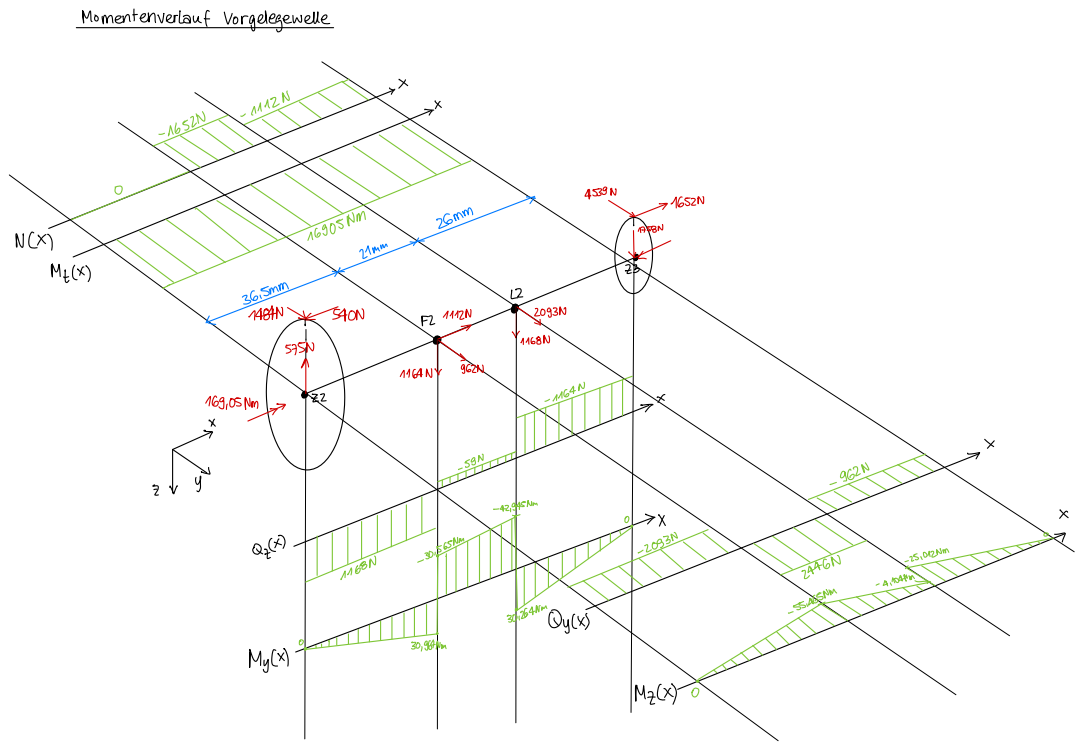
[picture p65: page 2]
NCX); VOL; Mtk); Qzli⁾; purim; gqAGN-aifm-55.AE ); ?NM3JiHNMQy(X ⑨; Mzcx) ;

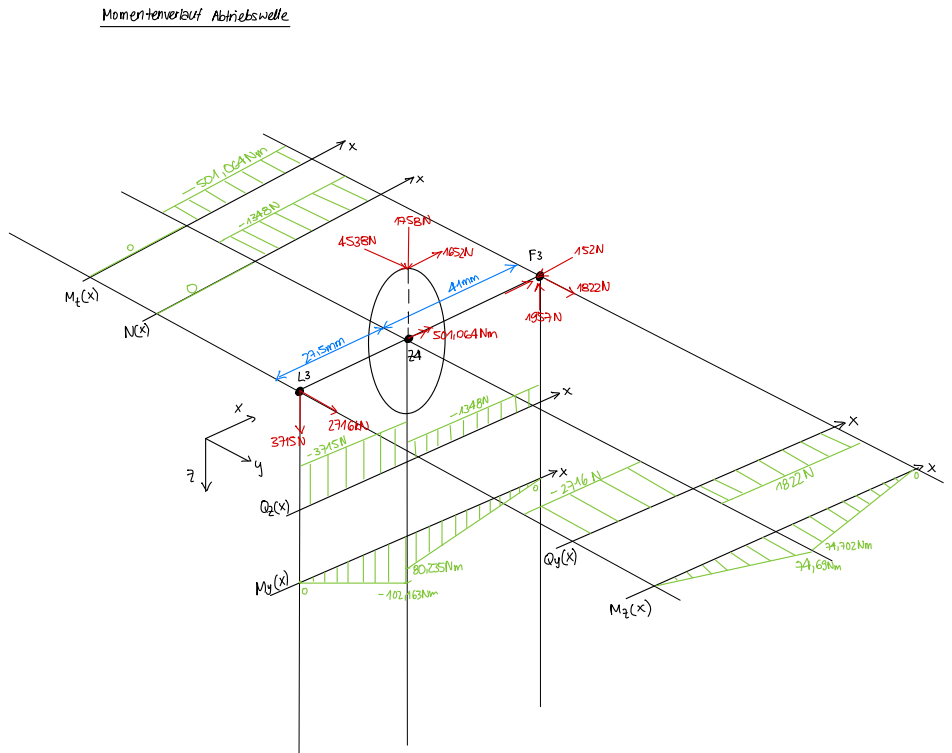
[picture p66: page 3]
Momentenverlauf AbtriebsWelle; Mtk⁾; y.im#-----sNm95tN ZA; näht; Qzcx); Qylx); Mzlx)
