JulianRe24/ME3-Entwurf/(commit log)

2022-03-31 Weiterführung
    [Getriebeberechnung Me3.xlsx]
2022-03-31 Änderungen
    [Getriebeberechnung Me3.xlsx]
2022-07-11 Update Anforderungsliste des Bohrgerät.docx
2022-07-30 Zahnräder
    [Eing-Steuerteil_Stirnradstufe_Maschb_Achabst.CATPart, Stirnradstufe 2_Maschb_Waelzverf_S20_R19.CATProduct, Stirnradstufe_Maschb_Waelzverf_S20_R19.CATProduct]
2022-08-04 Wieder Neues
    [10_37_0807_0250_001.CATPart, 10_37_1008_0250_001.CATPart, 6004_11.CATPart, 6012_16.CATPart, Abtriebswelle.CATPart, AbtriebswelleZsmBau.CATProduct, Antriebswelle.CATPart, AntriebswelleZsmBau.CATProduct]
